wyolum/VeloKey/README.md

# VeloKey
Minimal Bluetooth Keyboard with rotary controller
=======

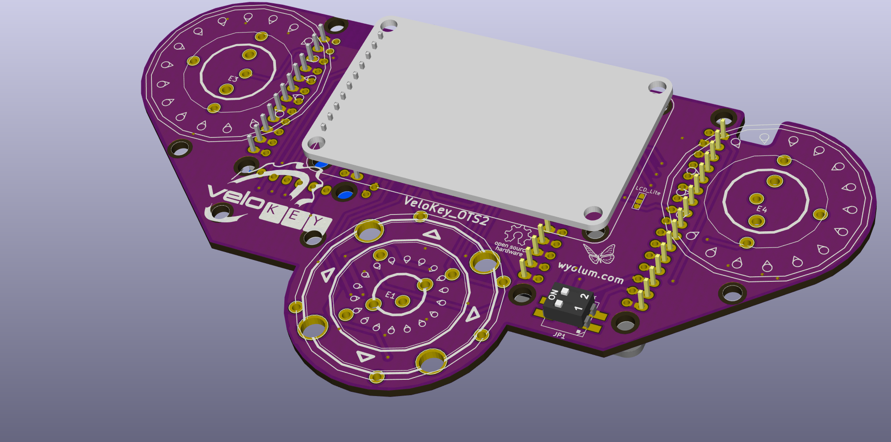
[picture p1: kicad/OTS_2/images/OTS2_01.png]
VeloKey top


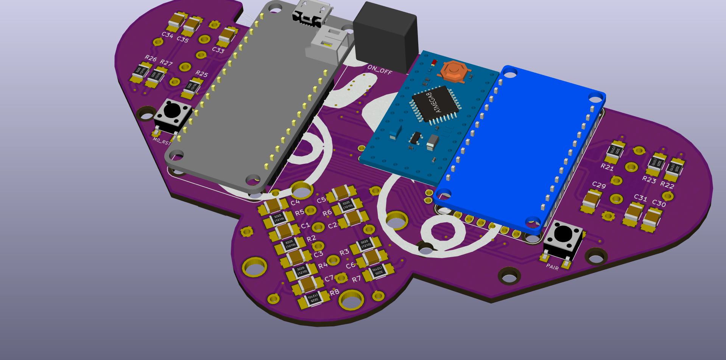
[picture p2: kicad/OTS_2/images/OTS2_02.png]
Velokey bottom


License
-------
[CERN Open Hardware Licence v1.2 ]

[CERN Open Hardware Licence v1.2 ]:http://www.ohwr.org/attachments/2388/cern_ohl_v_1_2.txt
