wyolum/VeloKey/kicad/data/Switch_GPTS203212BR2.pdf

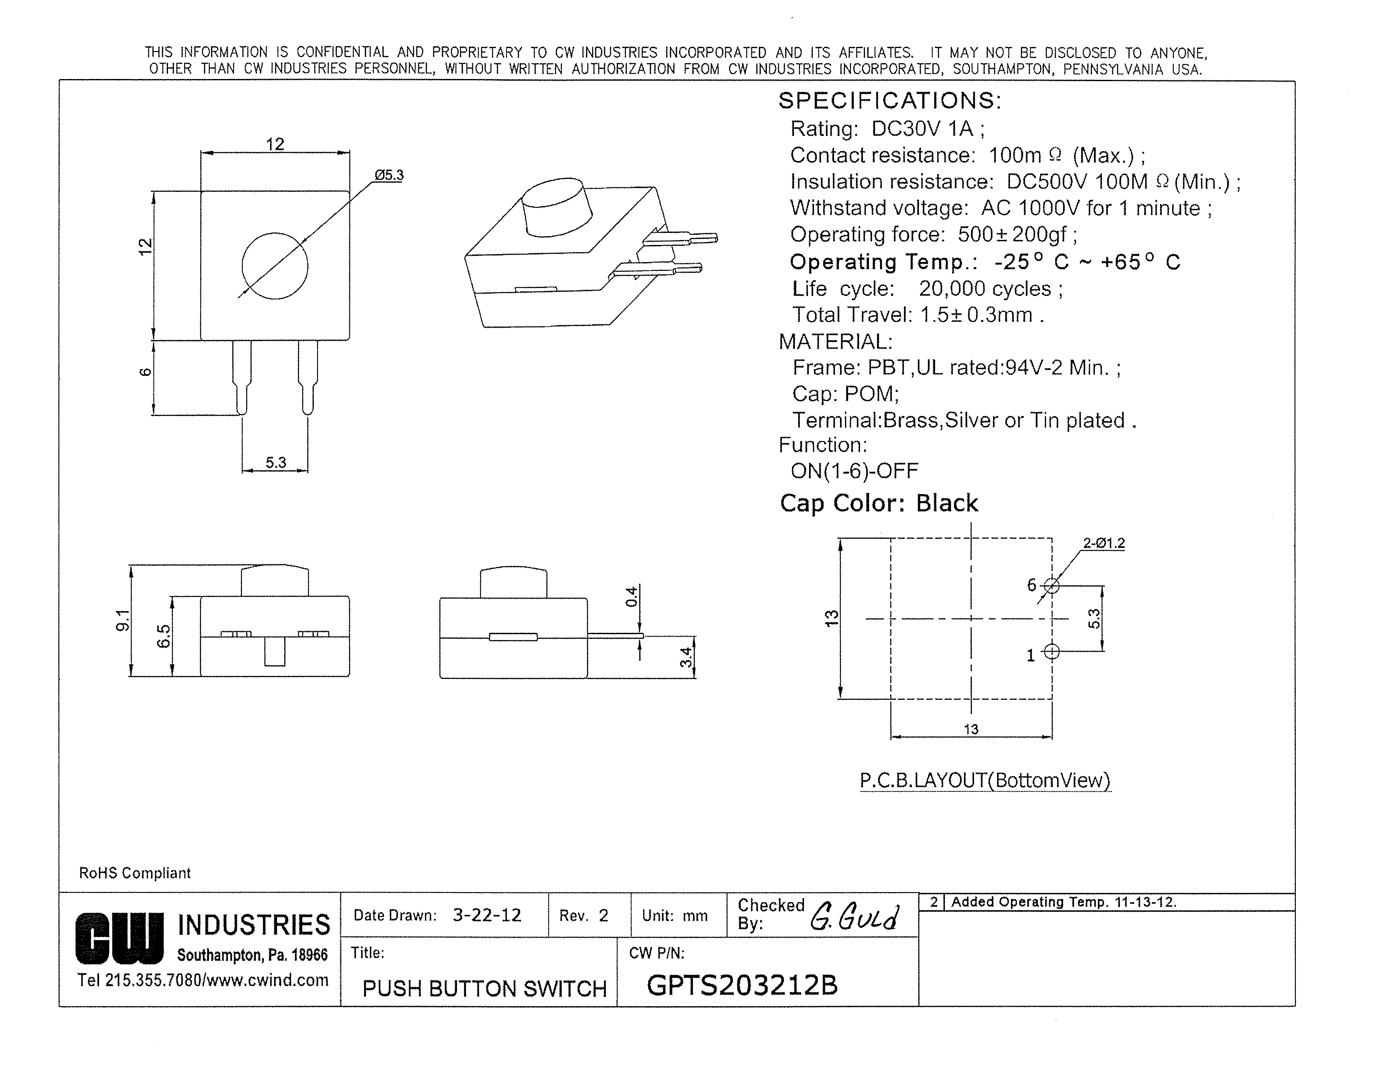
[picture p3: page 1]
