wyolum/VeloKey/kicad/data/ArduinoPRoMini.png

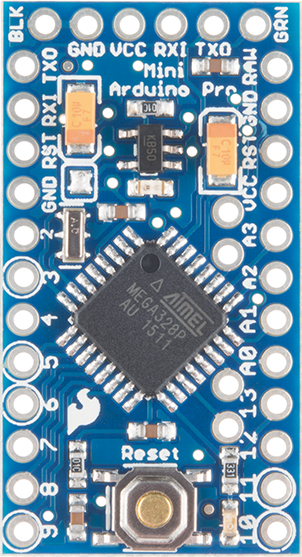
kicad/data/ArduinoPRoMini.png
