wyolum/VeloKey/kicad/data/ch04_promini_outline.png

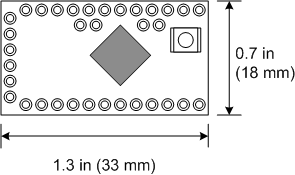
kicad/data/ch04_promini_outline.png
