wyolum/VeloKey/kicad/data/DisplayTFT.png

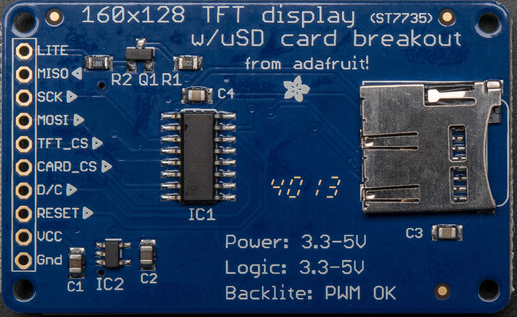
kicad/data/DisplayTFT.png
