wyolum/VeloKey/kicad/data/EZbluefruit.png

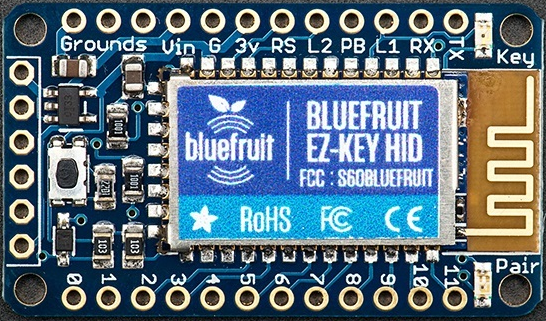
kicad/data/EZbluefruit.png
