wyolum/VeloKey/kicad/data/FeatherM0.png

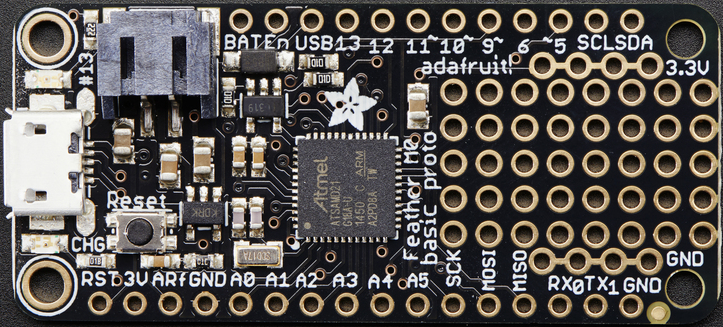
kicad/data/FeatherM0.png
