wyolum/VeloKey/kicad/data/OTS_Schematic.png

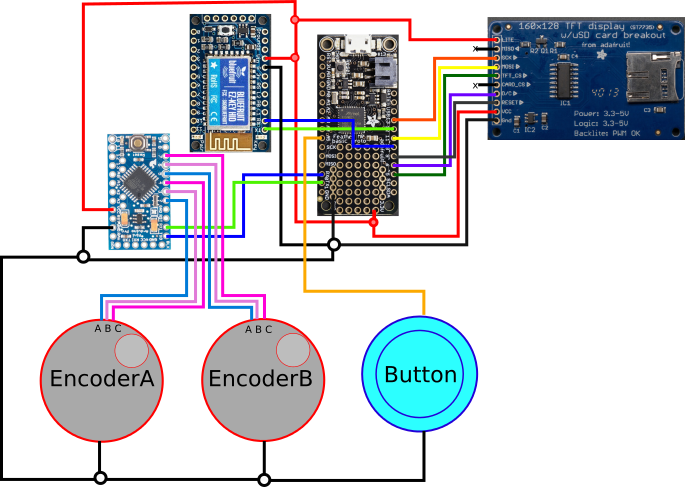
kicad/data/OTS_Schematic.png
