wyolum/VeloKey/kicad/data/velokey_sketch.jpg

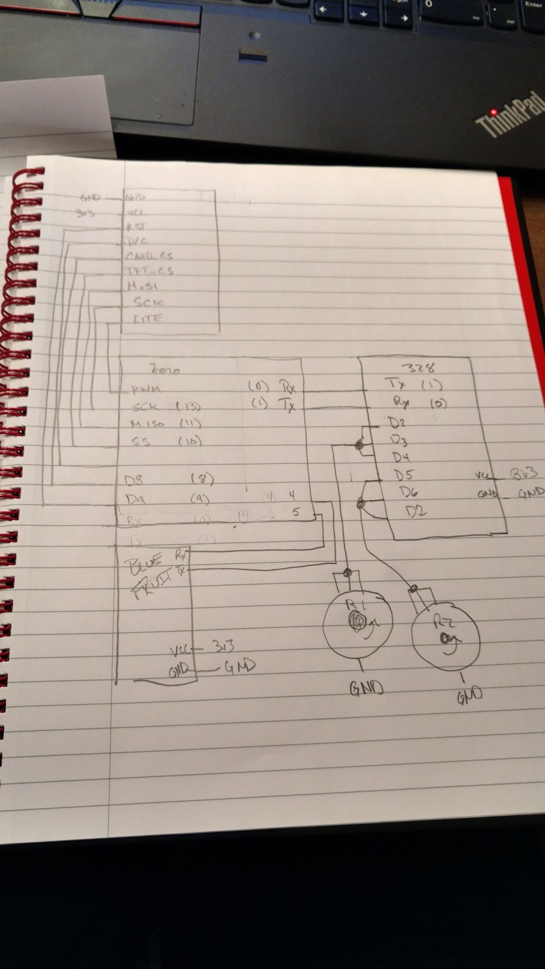
kicad/data/velokey_sketch.jpg
