wyolum/VeloKey/kicad/data/ZeroICSP.jpg

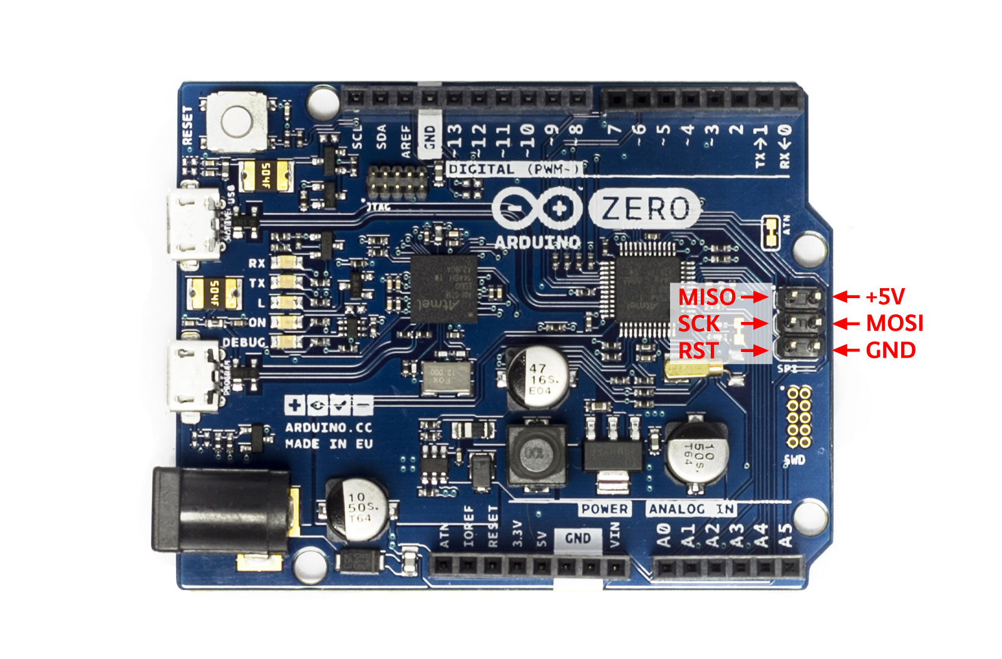
kicad/data/ZeroICSP.jpg
