wyolum/VeloKey/kicad/OTS_1/images/OTS01.png

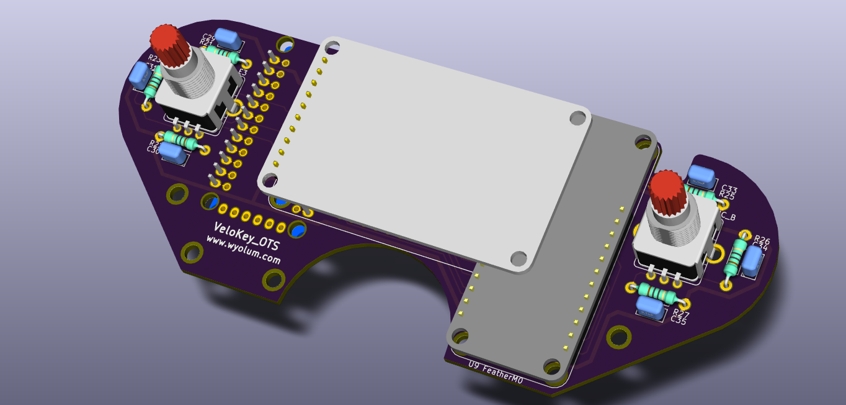
kicad/OTS_1/images/OTS01.png
