wyolum/VeloKey/kicad/OTS_1/images/OTS02.png

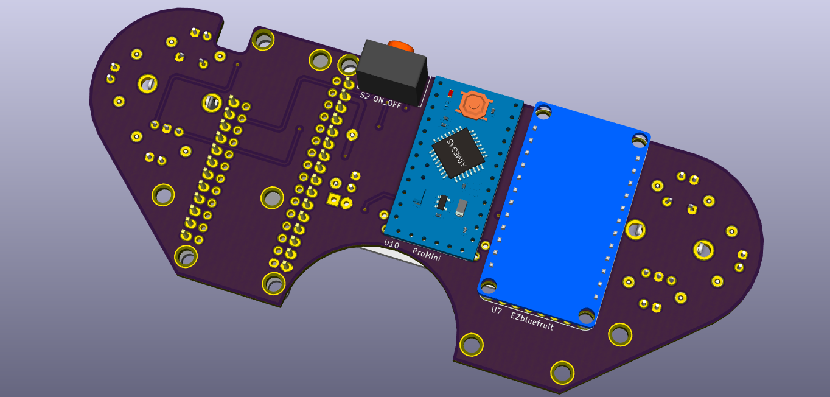
kicad/OTS_1/images/OTS02.png
