wyolum/VeloKey/kicad/OTS_1/images/OTS03.png

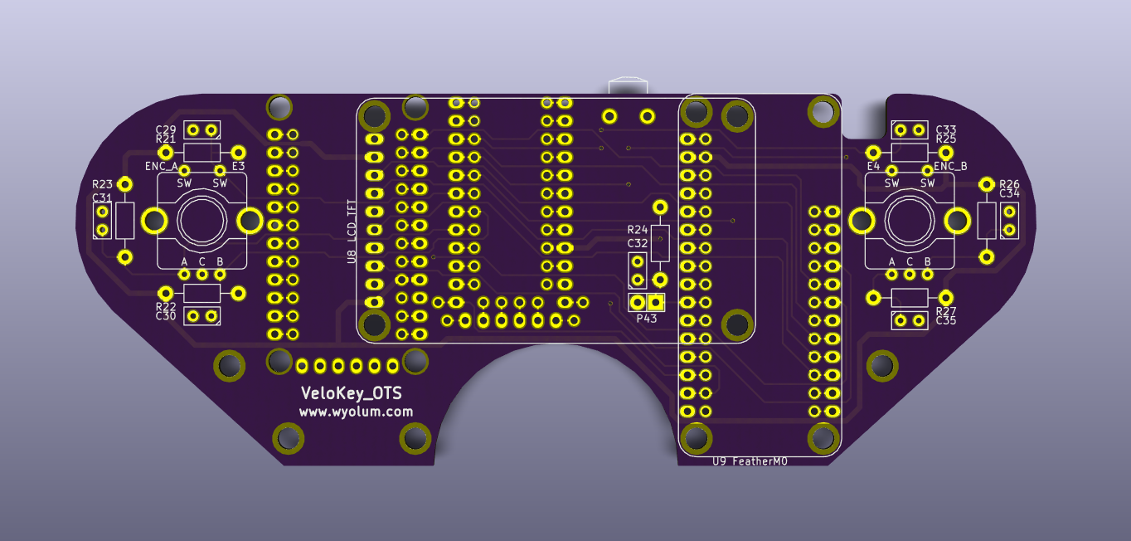
kicad/OTS_1/images/OTS03.png
