wyolum/VeloKey/kicad/OTS_1/images/OTS04.png

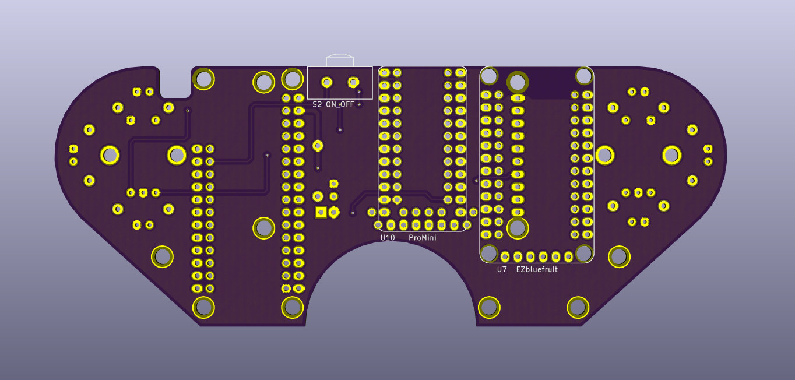
kicad/OTS_1/images/OTS04.png
