wyolum/VeloKey/kicad/OTS_1/images/OTS05.png

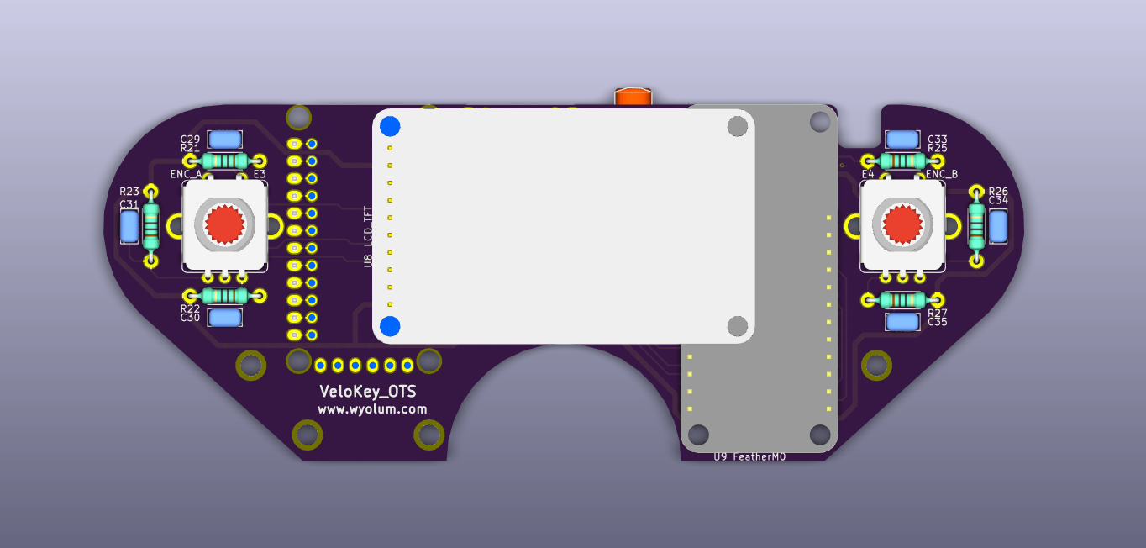
kicad/OTS_1/images/OTS05.png
