wyolum/VeloKey/kicad/OTS_1/images/OTS06.png

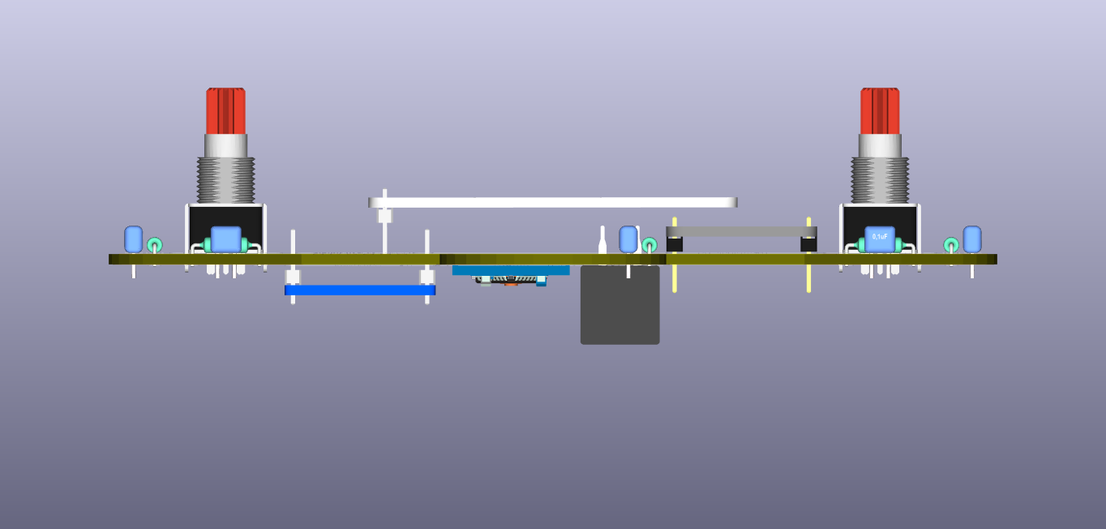
kicad/OTS_1/images/OTS06.png
