wyolum/VeloKey/kicad/OTS_2/images/OTS2_03.png

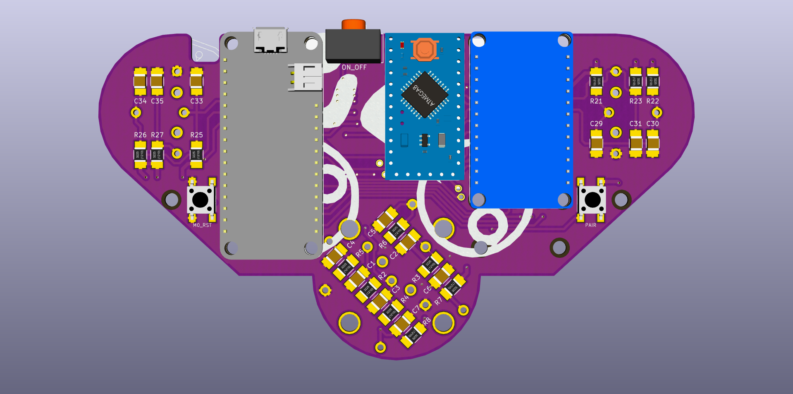
kicad/OTS_2/images/OTS2_03.png
