wyolum/VeloKey/kicad/OTS_2/images/OTS2_04.png

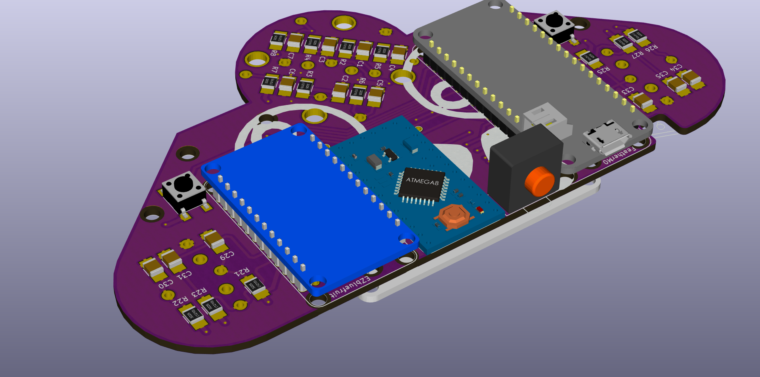
kicad/OTS_2/images/OTS2_04.png
