wyolum/VeloKey/kicad/OTS_2/images/OTS2_05.png

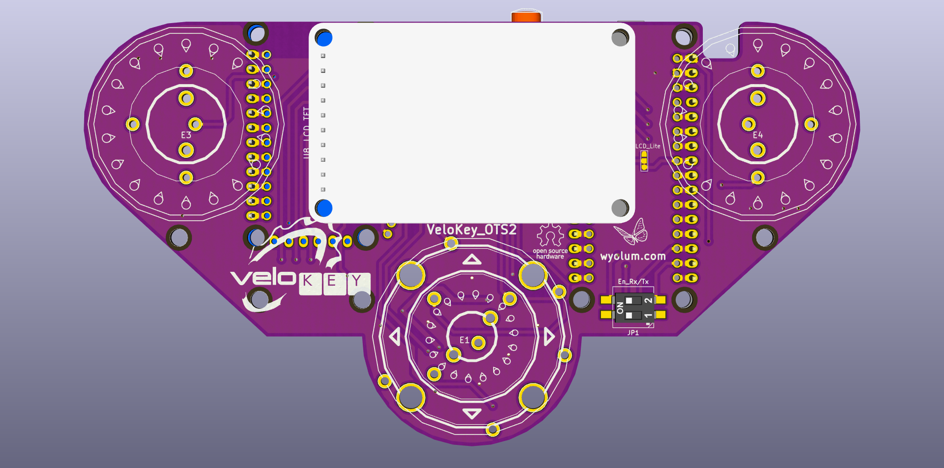
kicad/OTS_2/images/OTS2_05.png
