wyolum/VeloKey/kicad/OTS_2/OTS2_main.FCStd

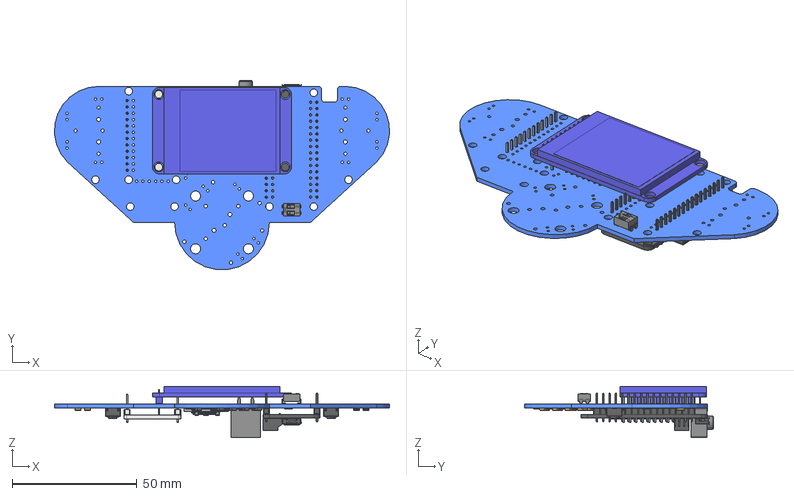
[picture p21: CAD file, 2016-10-24]
kicad/OTS_2/OTS2_main.FCStd
134.5 x 75.9 x 20.6 mm
Pcb
dip_sw_smd_
M0_
SW_smd_
Cap_smd_1210_
Cap_smd_1210_001
Cap_smd_1210_002
Cap_smd_1210_003
Cap_smd_1210_004
Cap_smd_1210_005
Cap_smd_1210_006
Cap_smd_1210_007
Cap_smd_1210_008
Cap_smd_1210_009
Cap_smd_1210_010
Cap_smd_1210_011
Cap_smd_1210_012
Res_smd_1210_
Res_smd_1210_001
Res_smd_1210_002
Res_smd_1210_003
Res_smd_1210_004
Res_smd_1210_005
Res_smd_1210_006
Res_smd_1210_007
Res_smd_1210_008
Res_smd_1210_009
Res_smd_1210_010
Res_smd_1210_011
Res_smd_1210_012
Res_smd_1210_013
SW_smd_001
