wyolum/VeloKey/fabricate/knob2.stl

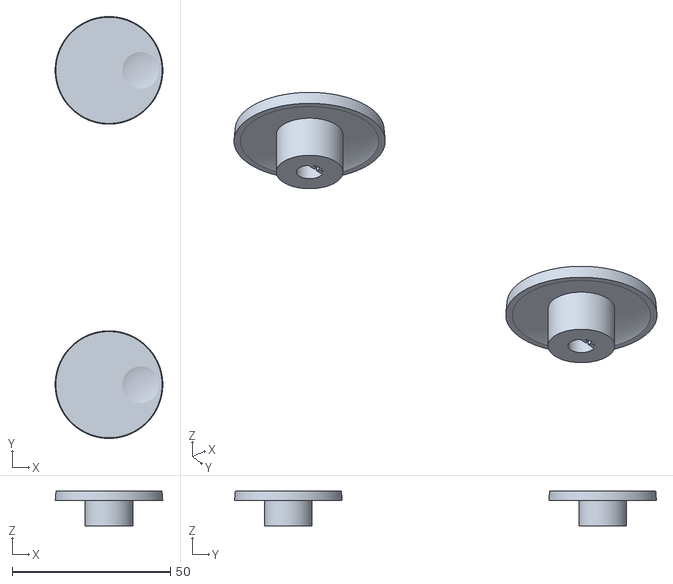
[picture p22: CAD file, 2016-03-05]
fabricate/knob2.stl
34.0 x 133.2 x 11.0
