wyolum/VeloKey/fabricate/OTS_1/case6_OTS_top.stl

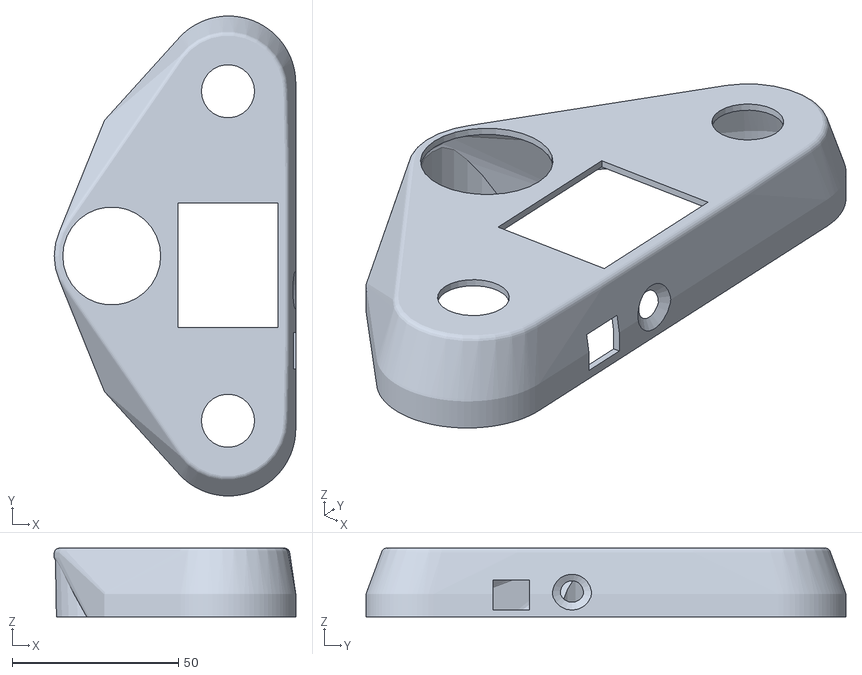
[picture p23: CAD file, 2016-03-07]
fabricate/OTS_1/case6_OTS_top.stl
72.7 x 144.5 x 20.7
