wyolum/VeloKey/fabricate/OTS_2/boards/OTS2_encC.FCStd

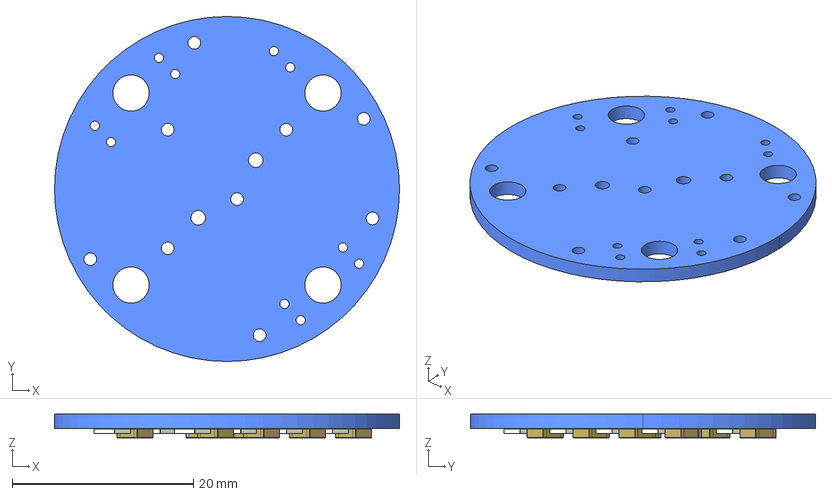
[picture p24: CAD file, 2016-09-07]
fabricate/OTS_2/boards/OTS2_encC.FCStd
38.1 x 38.1 x 2.60 mm
Pcb
Cap_smd_1210_
Cap_smd_1210_001
Res_smd_1210_
Res_smd_1210_001
Cap_smd_1210_002
Res_smd_1210_002
Cap_smd_1210_003
Res_smd_1210_003
Res_smd_1210_004
Res_smd_1210_005
Cap_smd_1210_004
Res_smd_1210_006
Cap_smd_1210_005
Cap_smd_1210_006
