wyolum/VeloKey/fabricate/OTS_2/OTS2_7_top.stl

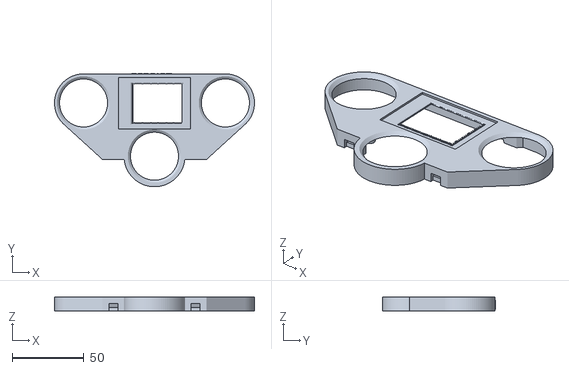
[picture p25: CAD file, 2018-01-31]
fabricate/OTS_2/OTS2_7_top.stl
139.7 x 79.2 x 9.63
