wyolum/VeloKey/fabricate/proto1/front.dxf

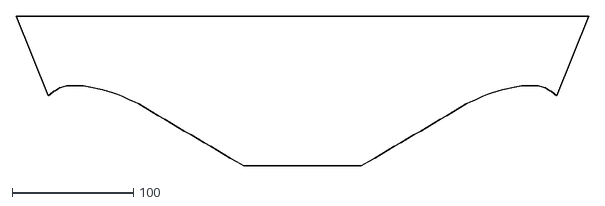
[picture p26: CAD file, 2016-02-07]
fabricate/proto1/front.dxf
473.0 x 123.5
