wyolum/VeloKey/kicad/OTS_1/3d_models/LCD_TFT2.step

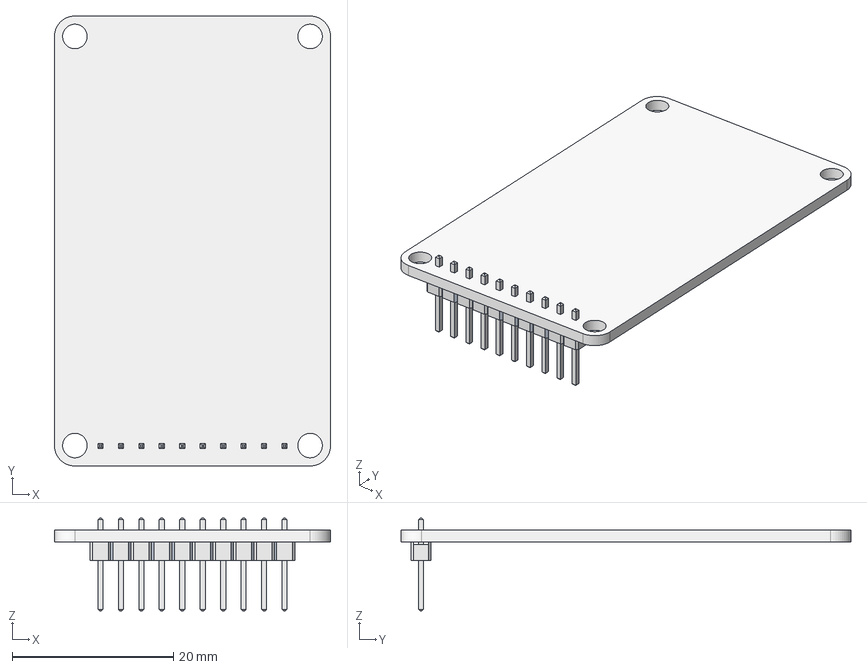
[picture p27: CAD file, 2016-02-05]
kicad/OTS_1/3d_models/LCD_TFT2.step
34.3 x 55.9 x 11.5 mm
