wyolum/VeloKey/kicad/OTS_2/3d_models/enc_a.step

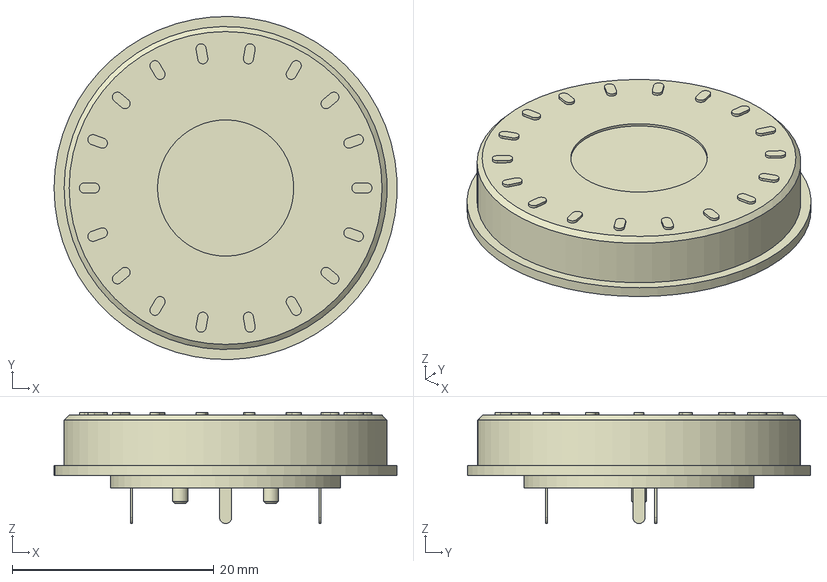
[picture p28: CAD file, 2016-09-07]
kicad/OTS_2/3d_models/enc_a.step
34.0 x 34.0 x 11.0 mm
