wyolum/VeloKey/fabricate/Garmin_Quarter_Turn_Plate.stl

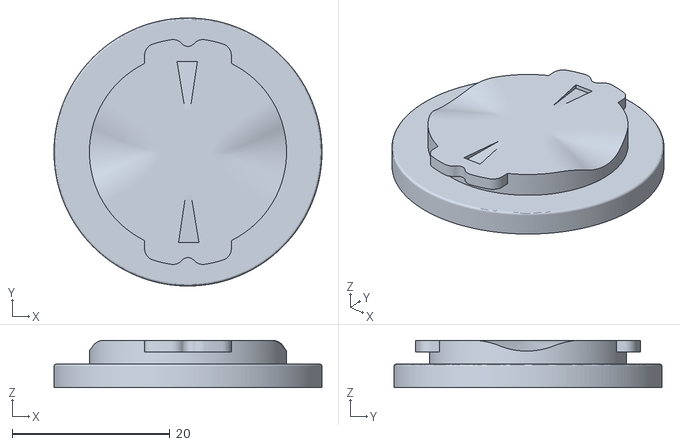
[picture p29: CAD file, 2016-03-05]
fabricate/Garmin_Quarter_Turn_Plate.stl
34.0 x 34.0 x 6.00
