wyolum/VeloKey/fabricate/OTS_1/case4_OTS_bottom.stl

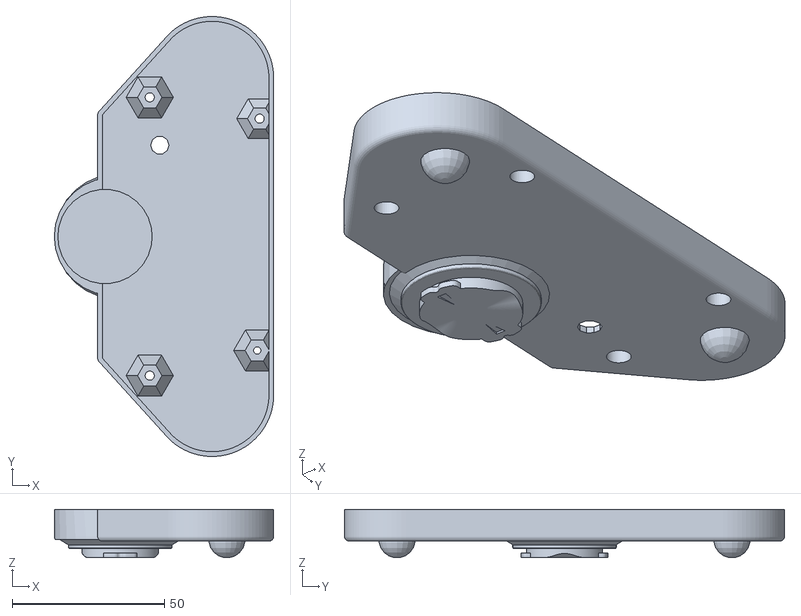
[picture p30: CAD file, 2016-03-05]
fabricate/OTS_1/case4_OTS_bottom.stl
72.1 x 144.5 x 15.8
