wyolum/VeloKey/fabricate/OTS_2/boards/OTS2_encB.FCStd

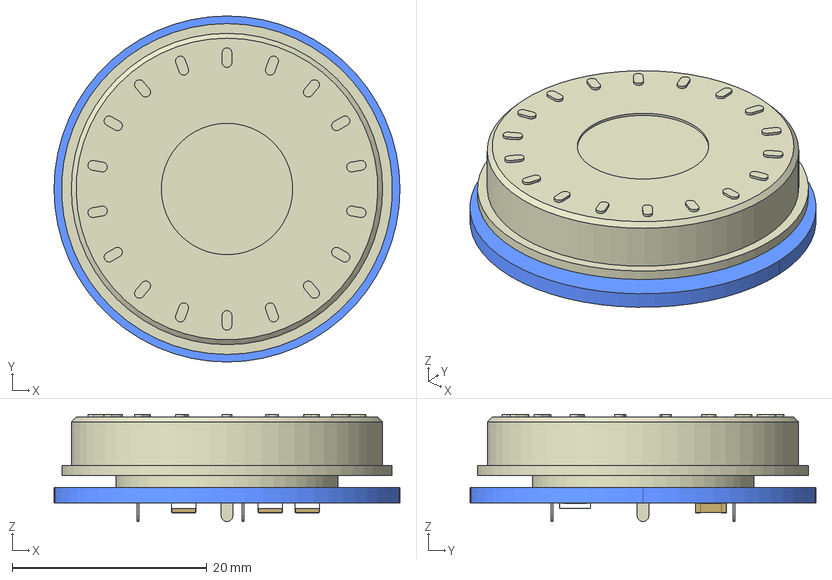
[picture p31: CAD file, 2016-09-07]
fabricate/OTS_2/boards/OTS2_encB.FCStd
35.6 x 35.6 x 11.0 mm
Pcb
Res_smd_1210_
Res_smd_1210_001
Cap_smd_1210_
Res_smd_1210_002
Cap_smd_1210_001
Cap_smd_1210_002
PolarPattern_
