wyolum/VeloKey/fabricate/OTS_2/OTS2_7_top_NoSupport.stl

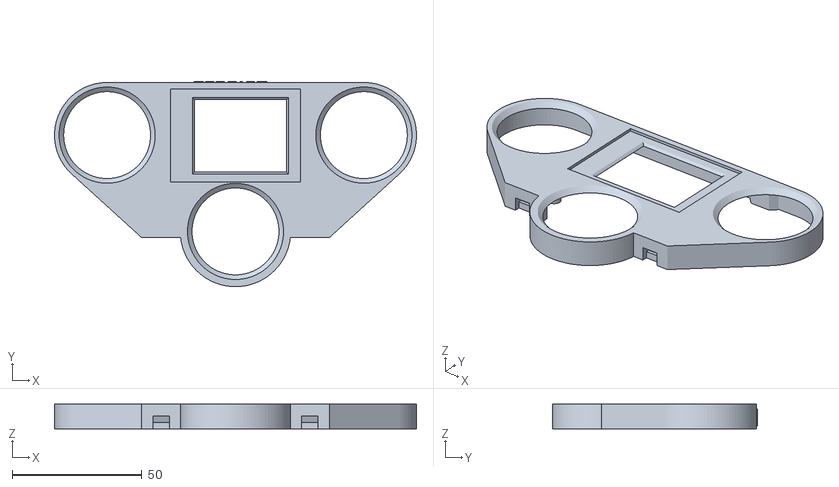
[picture p32: CAD file, 2016-12-15]
fabricate/OTS_2/OTS2_7_top_NoSupport.stl
139.7 x 79.2 x 9.63
