wyolum/VeloKey/fabricate/proto1/side.dxf

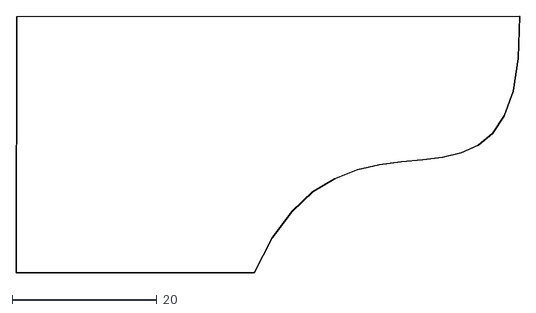
[picture p33: CAD file, 2016-02-01]
fabricate/proto1/side.dxf
69.7 x 35.5
