wyolum/VeloKey/kicad/OTS_1/3d_models/Header_Male_02Pin.step

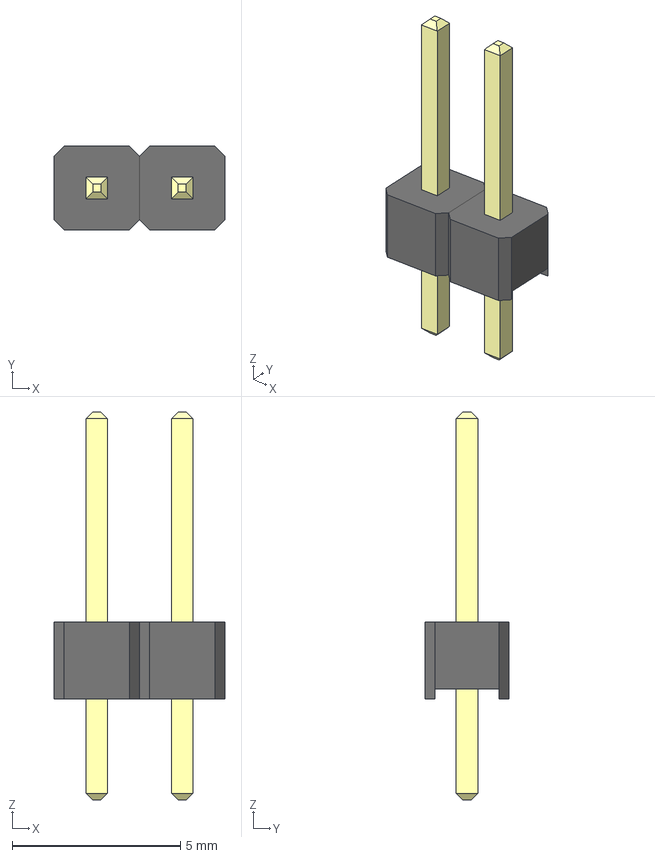
[picture p34: CAD file, 2016-02-05]
kicad/OTS_1/3d_models/Header_Male_02Pin.step
5.08 x 2.49 x 11.5 mm
