wyolum/VeloKey/kicad/OTS_2/3d_models/LCD_TFT.step

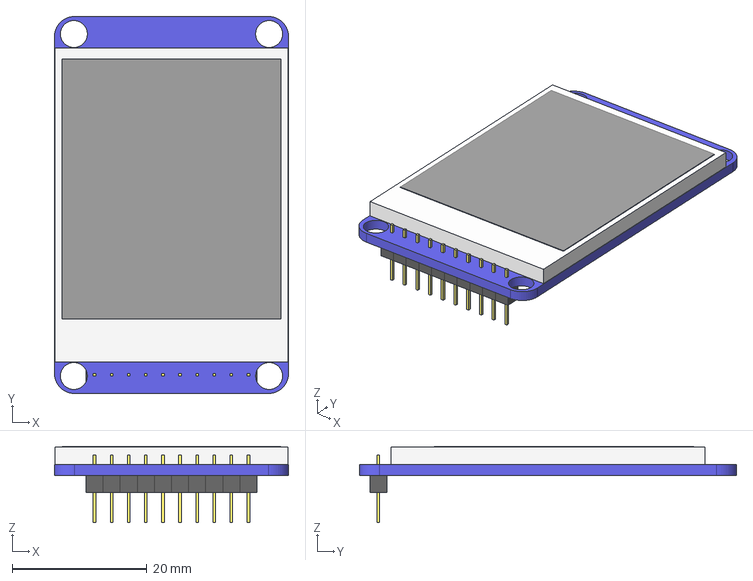
[picture p35: CAD file, 2016-07-04]
kicad/OTS_2/3d_models/LCD_TFT.step
34.8 x 56.0 x 11.3 mm
