wyolum/VeloKey/fabricate/knobs.stl

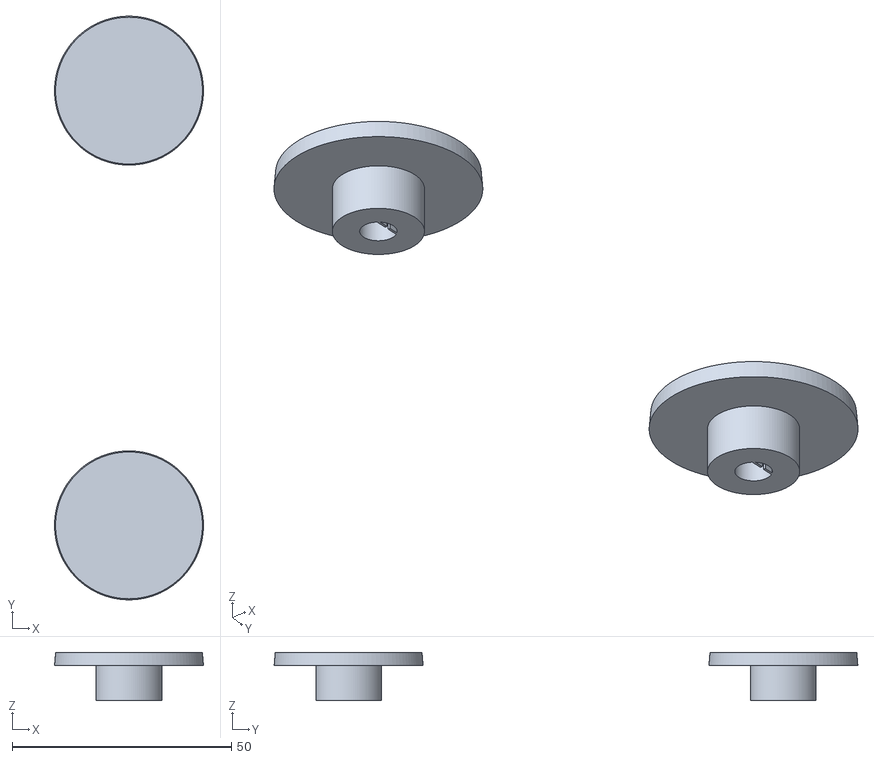
[picture p36: CAD file, 2016-03-05]
fabricate/knobs.stl
34.0 x 133.2 x 11.0
