wyolum/VeloKey/fabricate/OTS_1/case5_OTS.stl

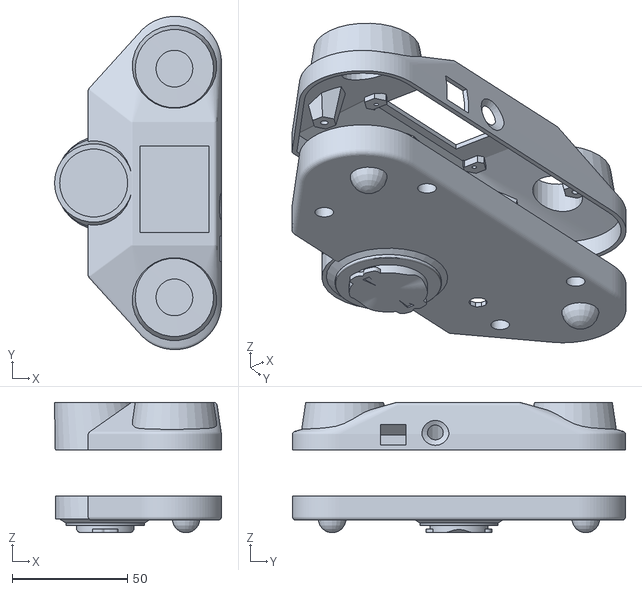
[picture p37: CAD file, 2016-03-05]
fabricate/OTS_1/case5_OTS.stl
72.4 x 144.5 x 56.5
