wyolum/VeloKey/fabricate/OTS_2/OTS2_7_bot.stl

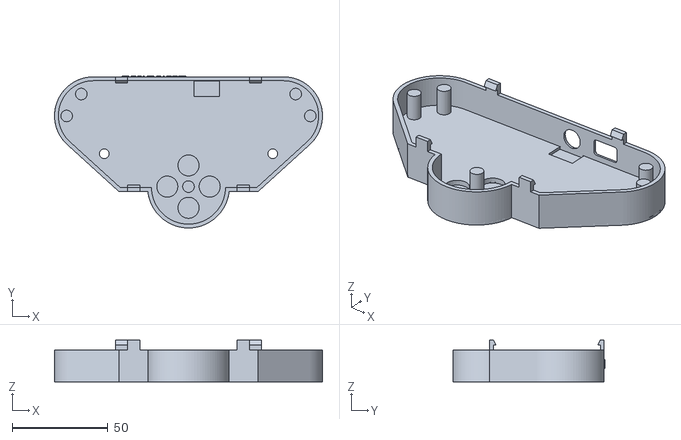
[picture p38: CAD file, 2016-12-15]
fabricate/OTS_2/OTS2_7_bot.stl
139.7 x 79.2 x 21.8
