wyolum/VeloKey/fabricate/proto1/top.dxf

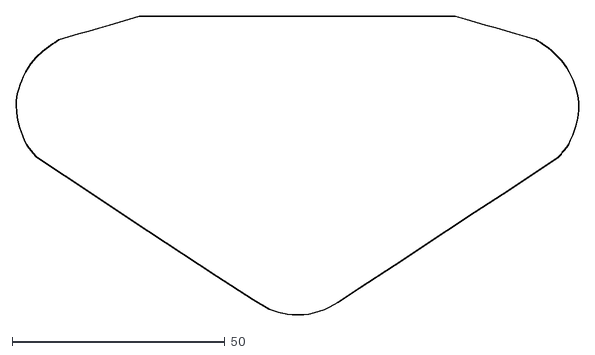
[picture p39: CAD file, 2016-01-26]
fabricate/proto1/top.dxf
132.1 x 70.2
