wyolum/VeloKey/kicad/OTS_1/3d_models/LCD_TFT.stl

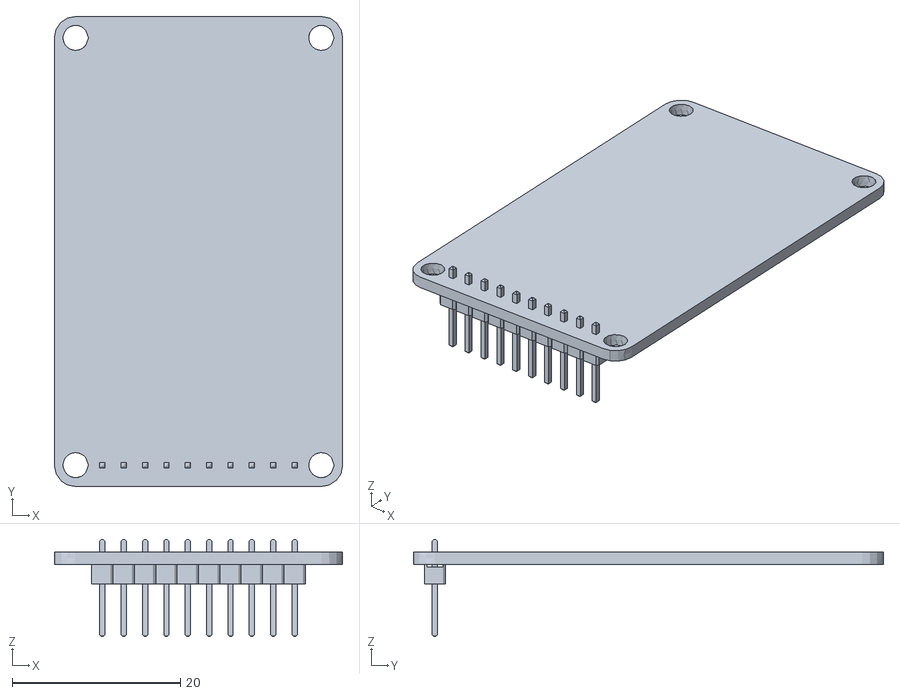
[picture p40: CAD file, 2016-02-04]
kicad/OTS_1/3d_models/LCD_TFT.stl
34.3 x 55.9 x 11.5
