wyolum/VeloKey/kicad/OTS_2/3d_models/dip_switch_smd_x2_3.step

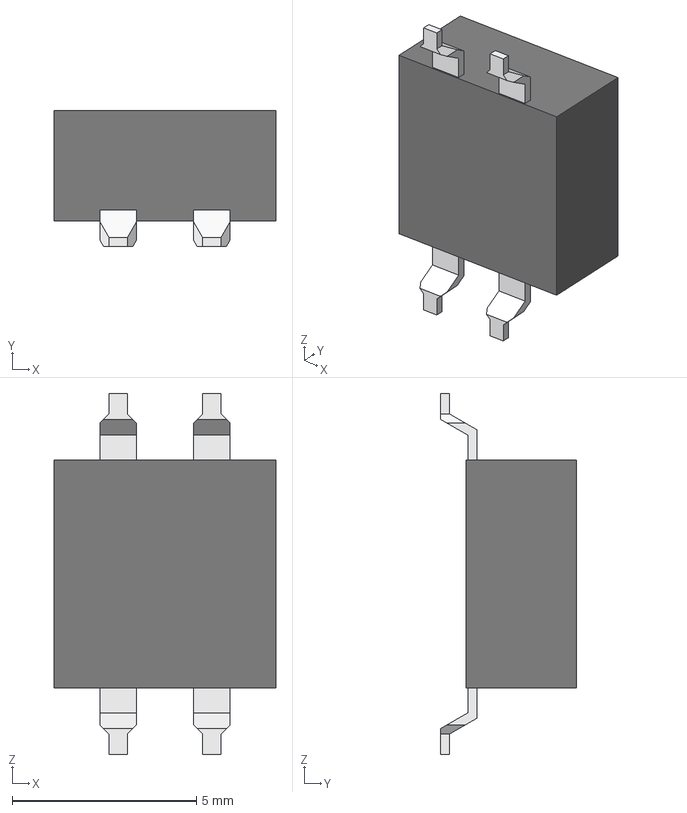
[picture p41: CAD file, 2016-04-25]
kicad/OTS_2/3d_models/dip_switch_smd_x2_3.step
6.02 x 3.70 x 9.80 mm
