wyolum/VeloKey/fabricate/knob.stl

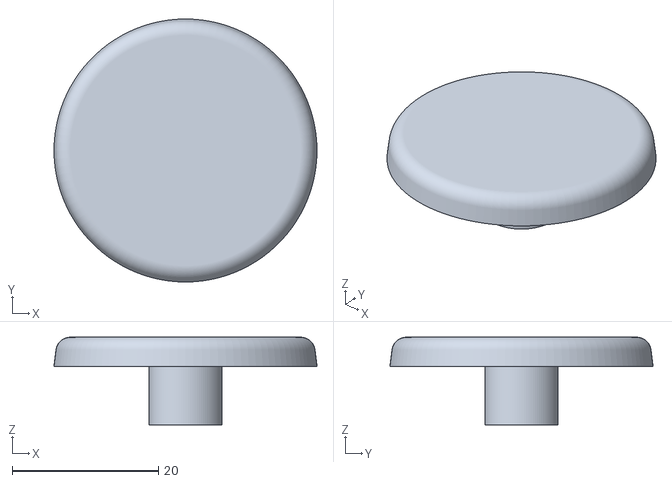
[picture p42: CAD file, 2016-03-05]
fabricate/knob.stl
36.0 x 36.0 x 12.0
