wyolum/VeloKey/fabricate/OTS_1/case4_OTS_top.stl

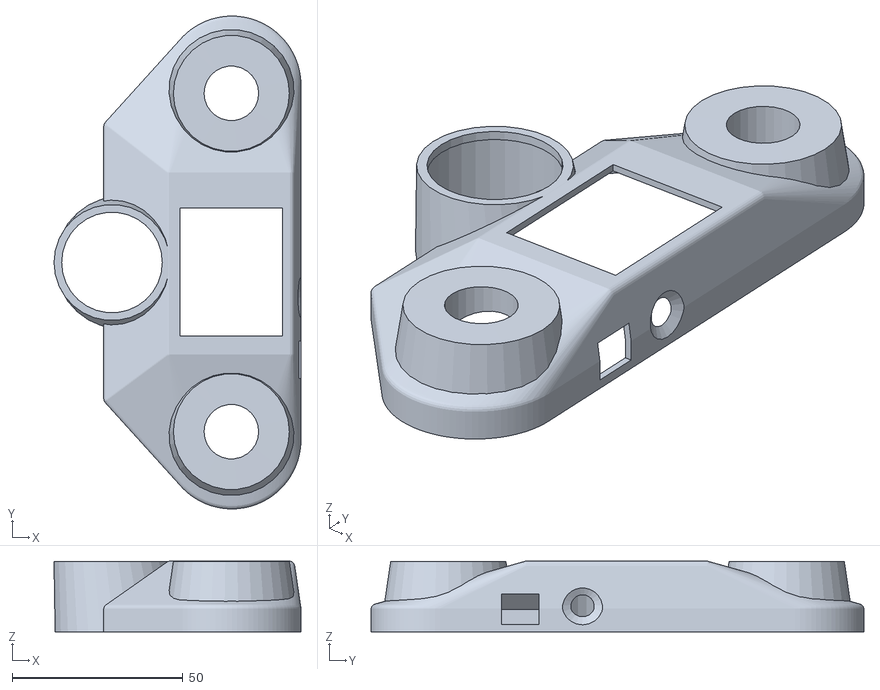
[picture p43: CAD file, 2016-03-05]
fabricate/OTS_1/case4_OTS_top.stl
72.4 x 144.5 x 20.7
