wyolum/VeloKey/kicad/OTS_1/3d_models/FeatherM0.step

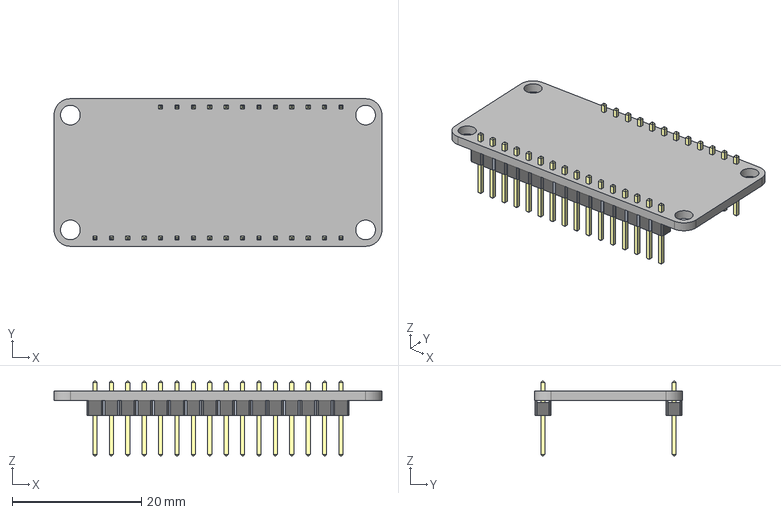
[picture p44: CAD file, 2016-02-04]
kicad/OTS_1/3d_models/FeatherM0.step
50.8 x 22.9 x 11.5 mm
