wyolum/VeloKey/kicad/OTS_2/3d_models/dip_switch_smd_x2.step

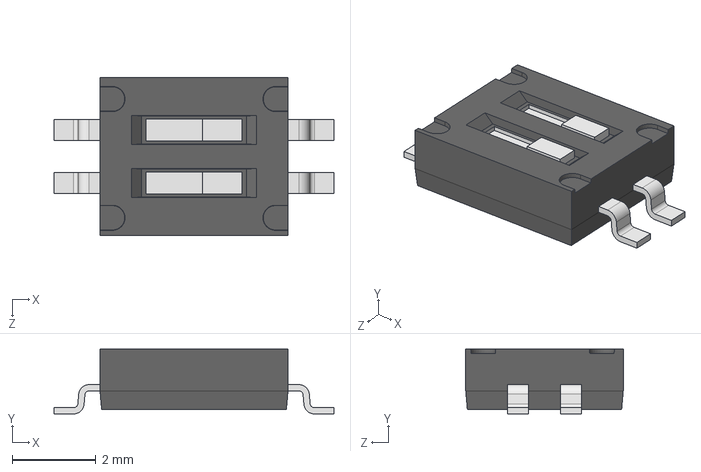
[picture p45: CAD file, 2016-04-25]
kicad/OTS_2/3d_models/dip_switch_smd_x2.step
6.70 x 1.55 x 3.77 mm
