wyolum/VeloKey/fabricate/OTS_1/board_OTS.stl

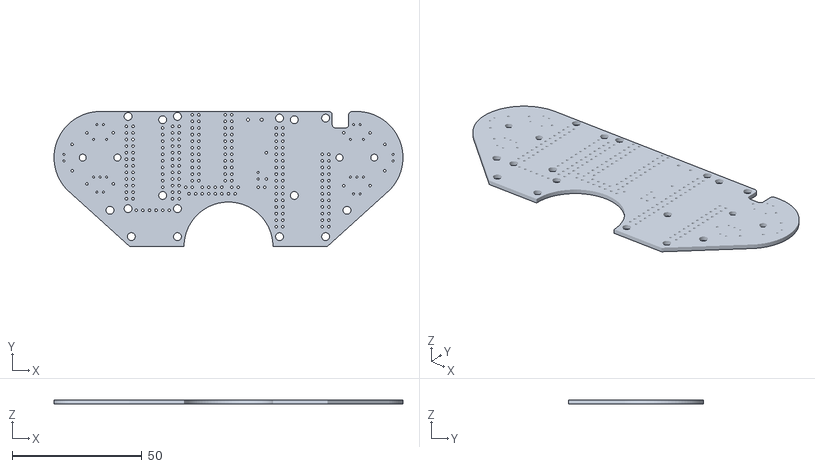
[picture p46: CAD file, 2016-03-05]
fabricate/OTS_1/board_OTS.stl
134.6 x 52.1 x 1.60
