wyolum/VeloKey/fabricate/power.stl

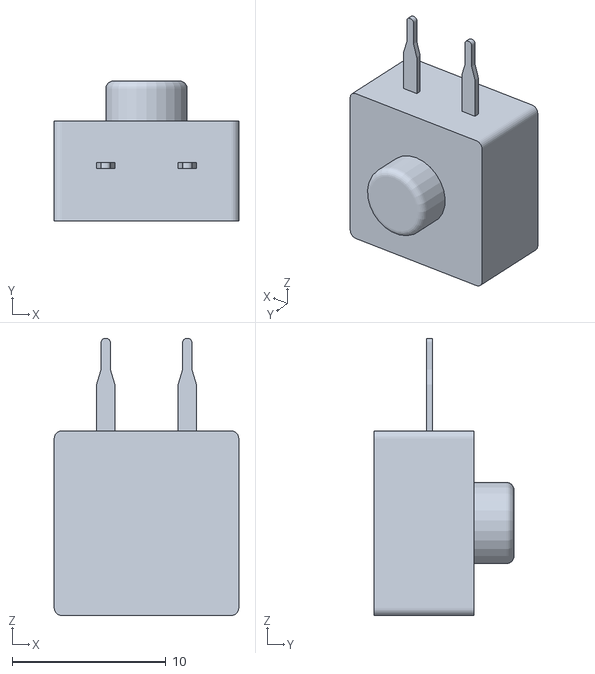
[picture p47: CAD file, 2016-03-05]
fabricate/power.stl
12.0 x 9.10 x 18.0
