wyolum/VeloKey/kicad/OTS_2/3d_models/dip_sw_smd.step

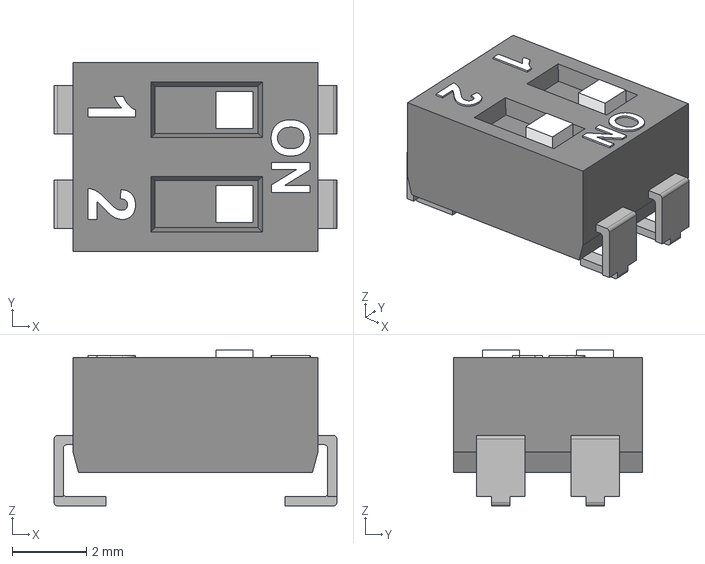
[picture p48: CAD file, 2016-04-25]
kicad/OTS_2/3d_models/dip_sw_smd.step
7.62 x 5.08 x 4.20 mm
