wyolum/VeloKey/fabricate/extender.stl

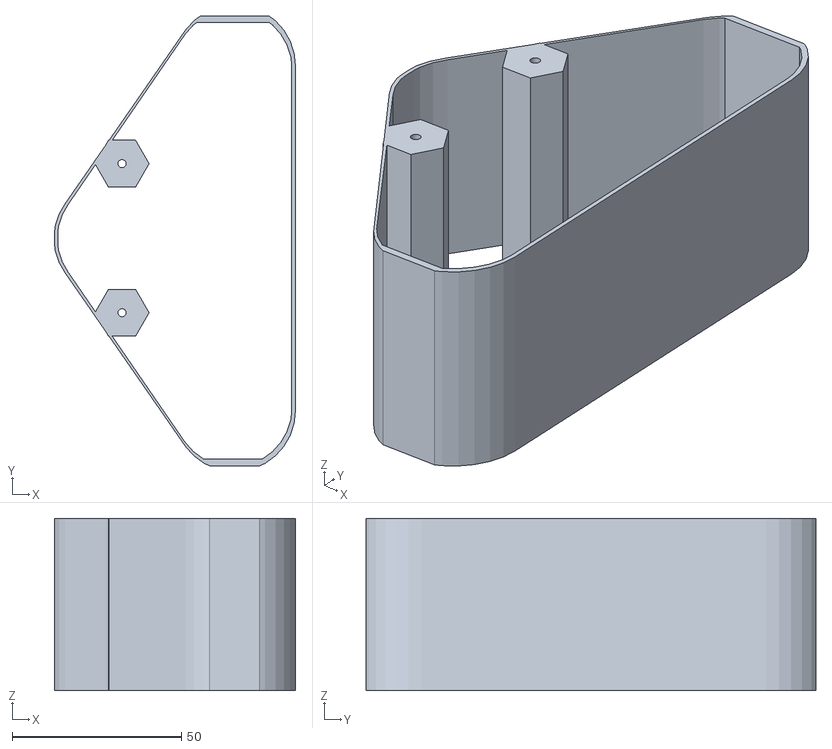
[picture p49: CAD file, 2016-03-05]
fabricate/extender.stl
71.1 x 132.7 x 50.8
