wyolum/VeloKey/fabricate/OTS_1/case3_OTS_bottom.stl

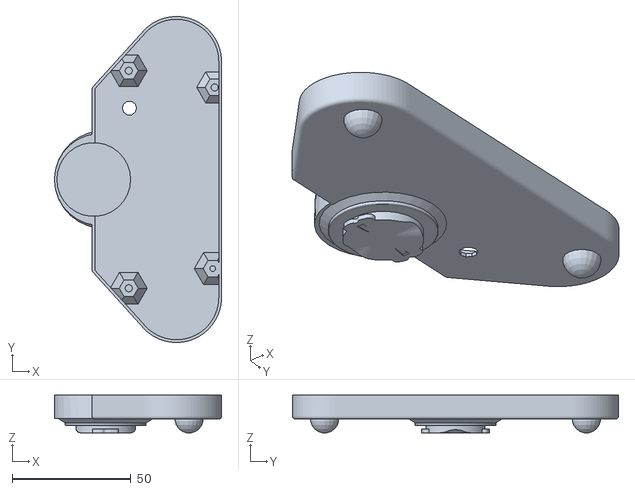
[picture p50: CAD file, 2016-03-05]
fabricate/OTS_1/case3_OTS_bottom.stl
70.3 x 137.0 x 15.8
