wyolum/VeloKey/fabricate/OTS_2/OTS2_5_garmin_base.stl

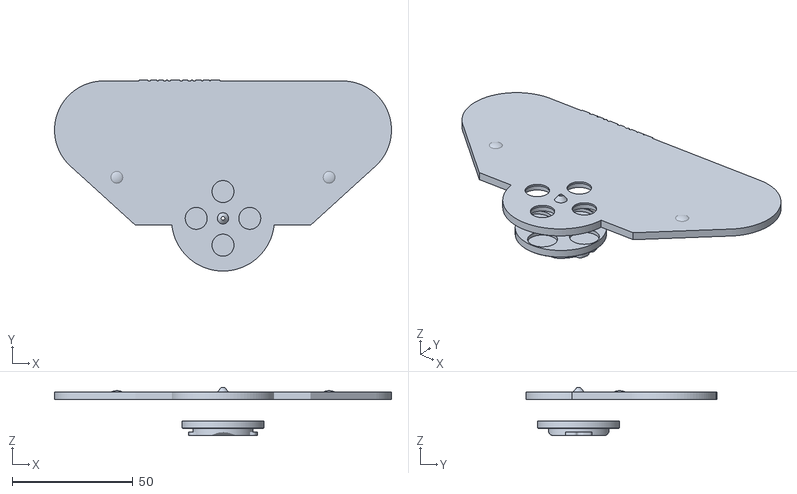
[picture p51: CAD file, 2016-10-24]
fabricate/OTS_2/OTS2_5_garmin_base.stl
139.7 x 79.2 x 19.9
