wyolum/VeloKey/fabricate/display.stl

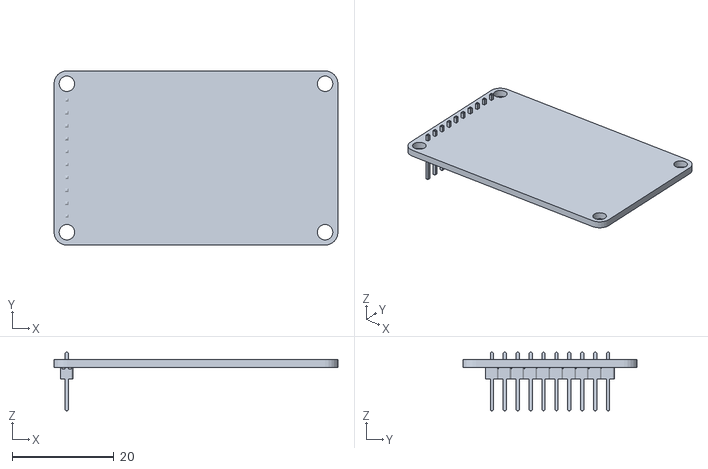
[picture p52: CAD file, 2016-03-05]
fabricate/display.stl
55.9 x 34.3 x 11.5
