wyolum/VeloKey/fabricate/OTS_2/OTS2_4_bot.stl

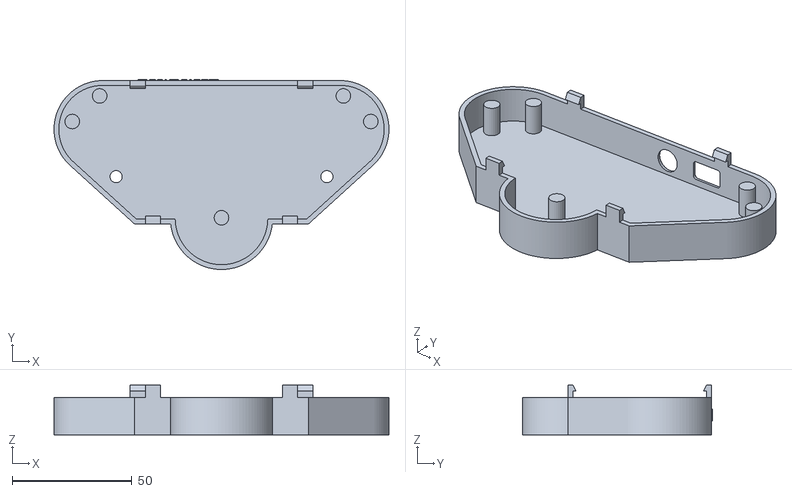
[picture p53: CAD file, 2016-10-10]
fabricate/OTS_2/OTS2_4_bot.stl
139.7 x 79.2 x 20.8
