wyolum/VeloKey/kicad/OTS_1/3d_models/Header_Male_12Pin.step

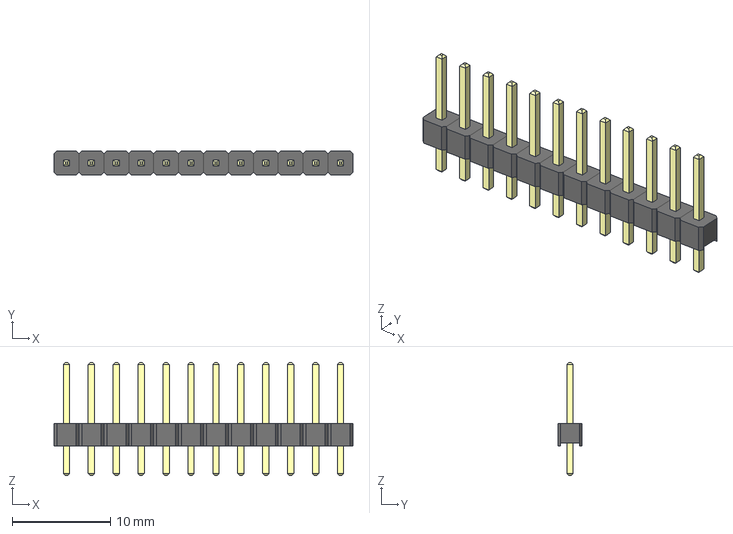
[picture p54: CAD file, 2016-02-04]
kicad/OTS_1/3d_models/Header_Male_12Pin.step
30.5 x 2.49 x 11.5 mm
