wyolum/VeloKey/kicad/OTS_2/3d_models/LiPo.step

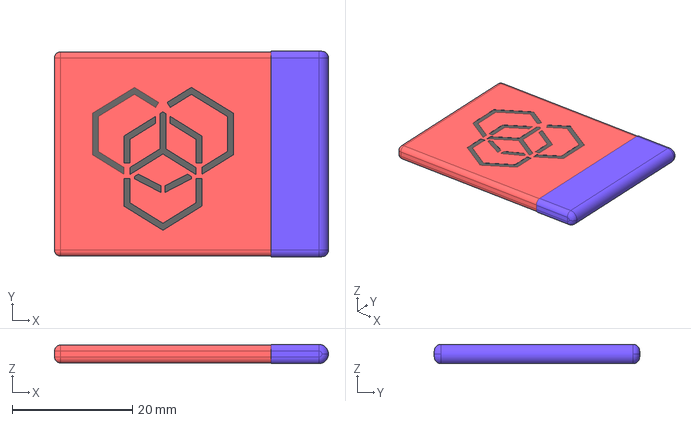
[picture p55: CAD file, 2016-03-31]
kicad/OTS_2/3d_models/LiPo.step
45.6 x 34.2 x 3.20 mm
