wyolum/VeloKey/kicad/OTS_1/3d_models/Capacitor_100nF_2-54mm.step

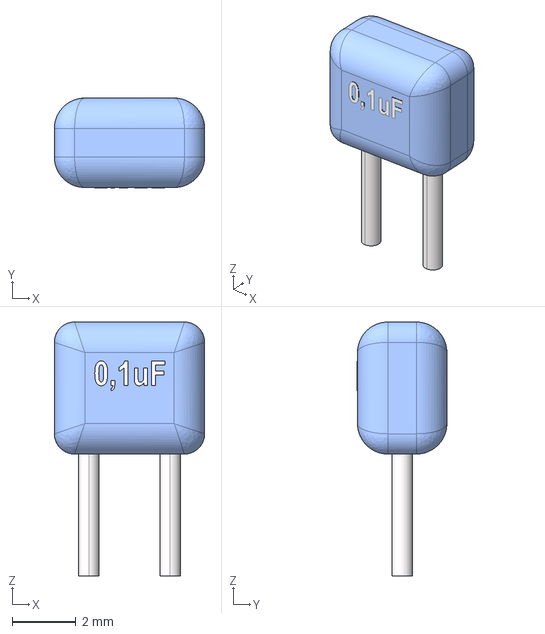
[picture p56: CAD file, 2016-02-04]
kicad/OTS_1/3d_models/Capacitor_100nF_2-54mm.step
4.70 x 2.81 x 7.94 mm
