wyolum/VeloKey/kicad/OTS_2/3d_models/SW_smd.step

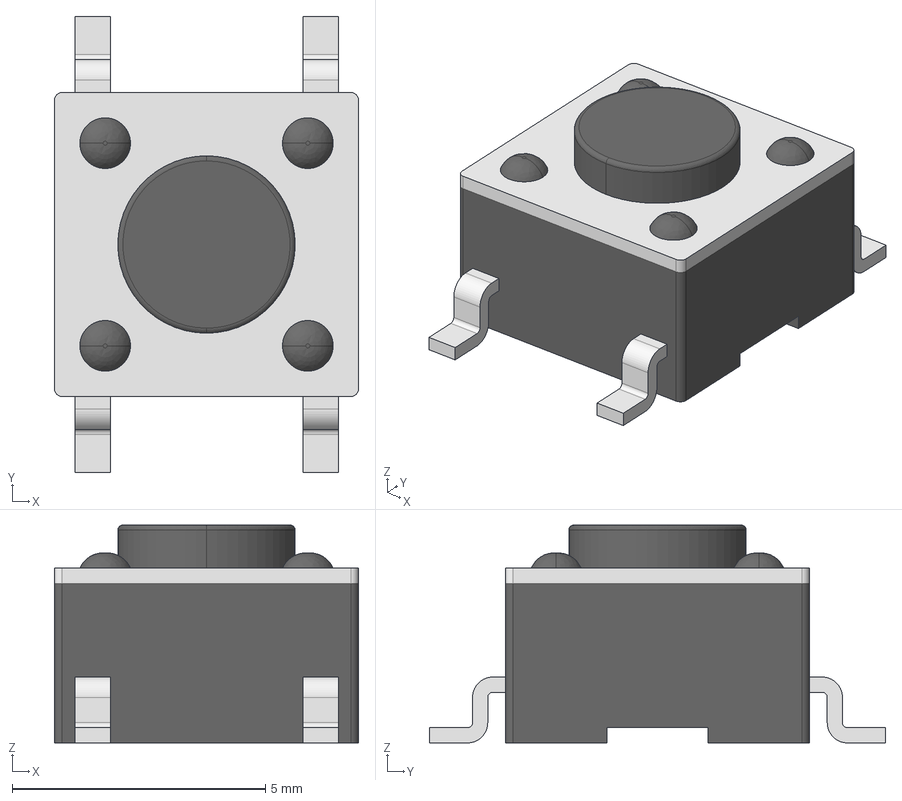
[picture p57: CAD file, 2016-03-31]
kicad/OTS_2/3d_models/SW_smd.step
6.00 x 9.00 x 4.30 mm
