wyolum/VeloKey/fabricate/OTS_1/case3_OTS.stl

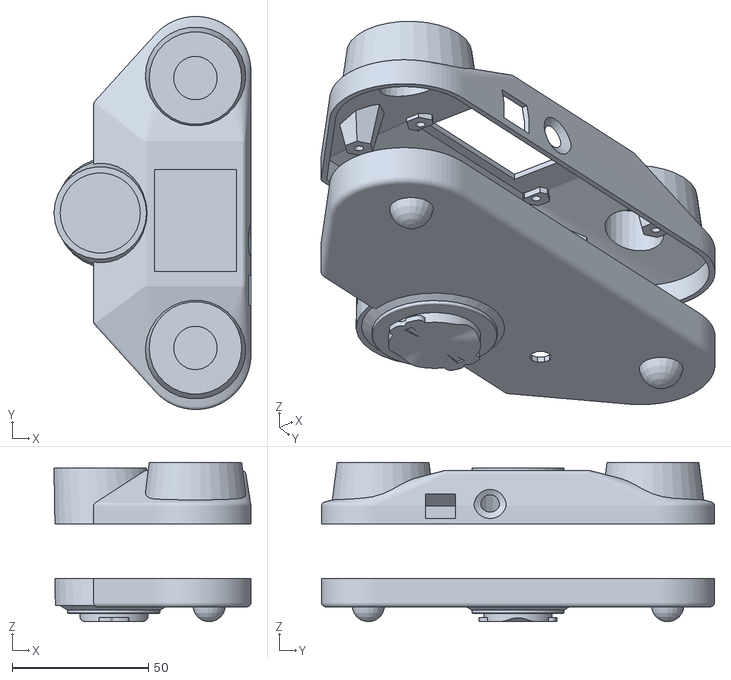
[picture p58: CAD file, 2016-03-05]
fabricate/OTS_1/case3_OTS.stl
72.4 x 144.5 x 58.5
