wyolum/VeloKey/fabricate/OTS_2/OTS2_4.FCStd

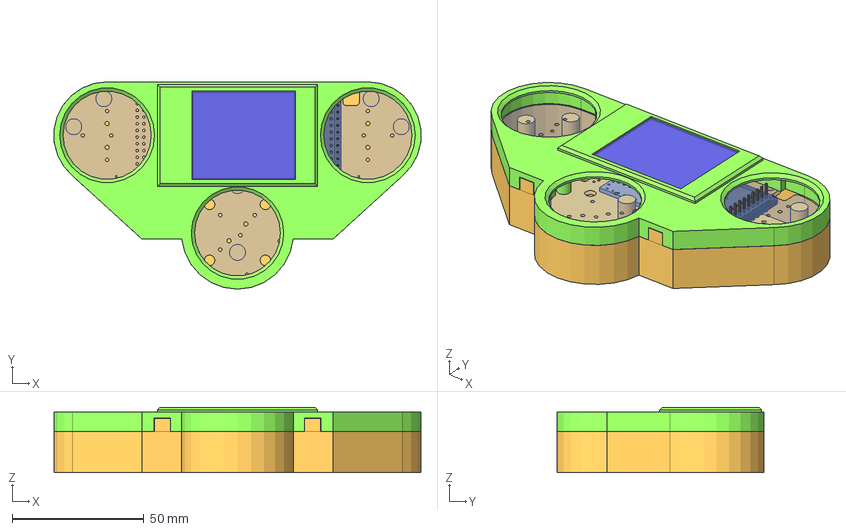
[picture p59: CAD file, 2016-08-29]
fabricate/OTS_2/OTS2_4.FCStd
139.4 x 78.8 x 24.9 mm
Pcb
dip_sw_smd_
LCD
M0_
SW_smd_
ProMini
Power
SW_smd_001
bottom_Pad013
top_final_Chamfer001
