wyolum/VeloKey/kicad/OTS_1/3d_models/header_1x2_TH_2_54mm.step

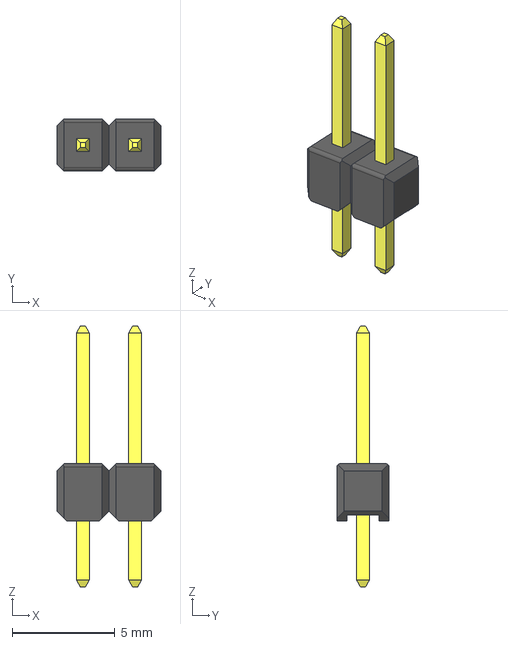
[picture p60: CAD file, 2016-02-04]
kicad/OTS_1/3d_models/header_1x2_TH_2_54mm.step
5.08 x 2.54 x 12.7 mm
