wyolum/VeloKey/kicad/OTS_2/3d_models/JST_SxB-PH-K-S-RA.step

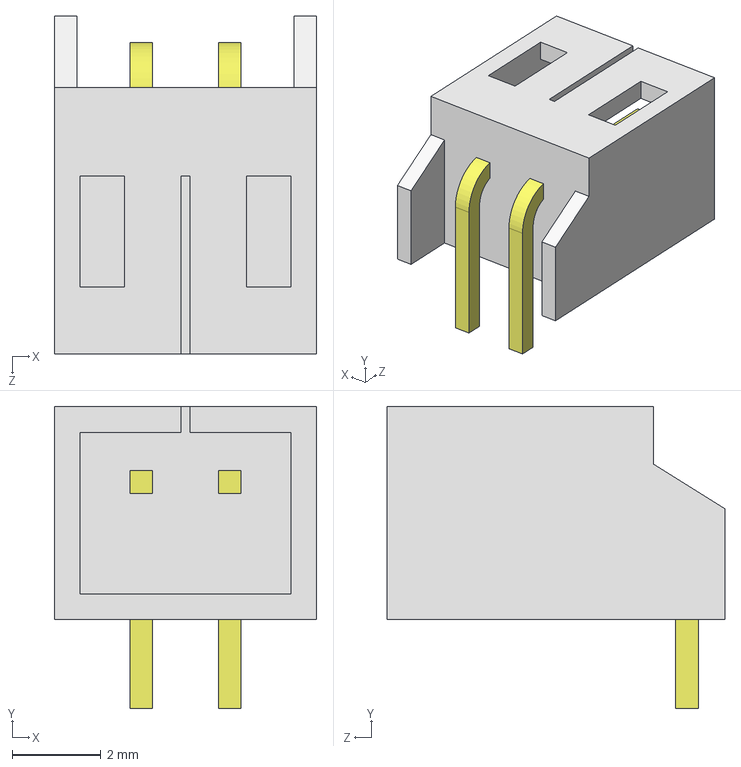
[picture p61: CAD file, 2016-03-31]
kicad/OTS_2/3d_models/JST_SxB-PH-K-S-RA.step
5.90 x 6.80 x 7.60 mm
