wyolum/VeloKey/fabricate/OTS_1/case1_top.stl

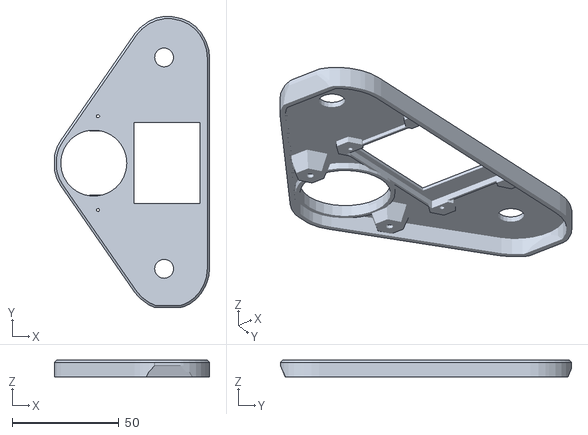
[picture p62: CAD file, 2016-03-05]
fabricate/OTS_1/case1_top.stl
72.8 x 136.6 x 7.88
