wyolum/VeloKey/kicad/OTS_1/3d_models/Header_Male_03Pin.step

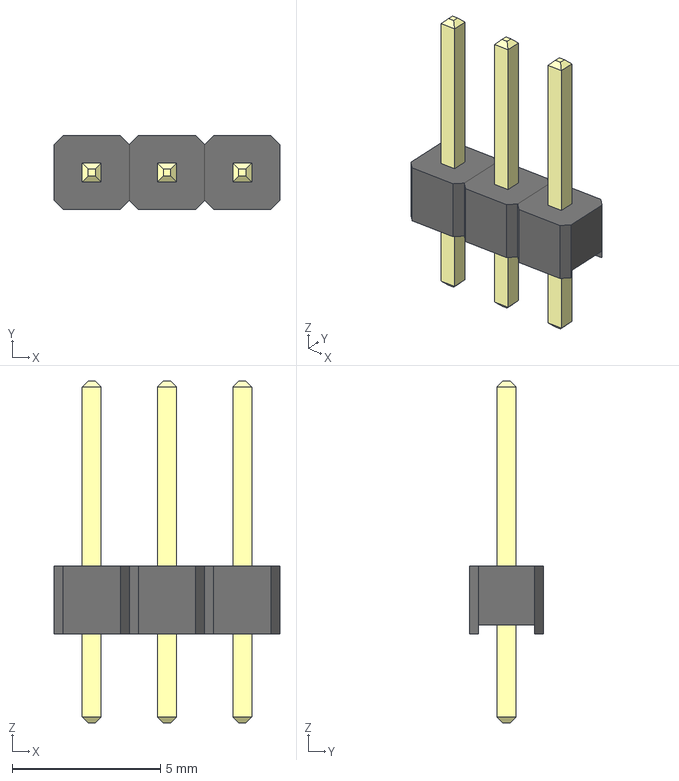
[picture p63: CAD file, 2016-02-04]
kicad/OTS_1/3d_models/Header_Male_03Pin.step
7.62 x 2.49 x 11.5 mm
