wyolum/VeloKey/kicad/OTS_2/3d_models/FeatherM0.fcstd

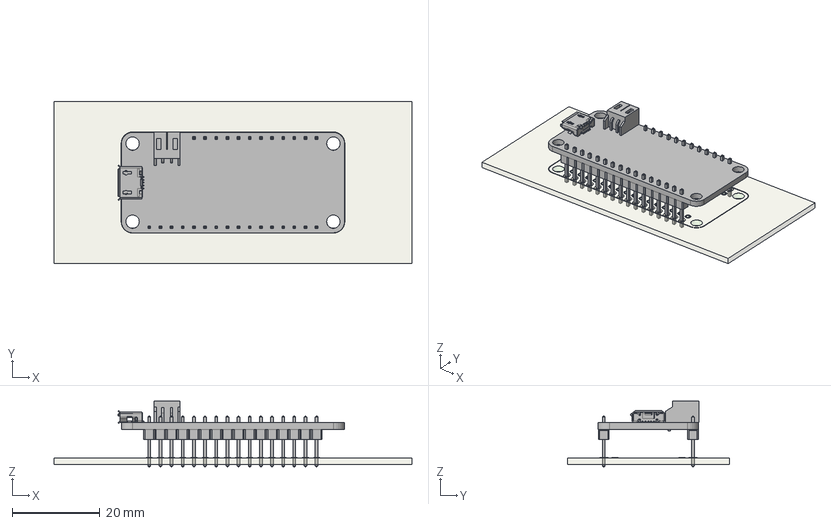
[picture p64: CAD file, 2016-03-31]
kicad/OTS_2/3d_models/FeatherM0.fcstd
81.5 x 36.8 x 14.9 mm
FrontSilk
TopPads
BotPads
PTHs
Pcb
M0
