wyolum/VeloKey/fabricate/OTS_1/case1.stl

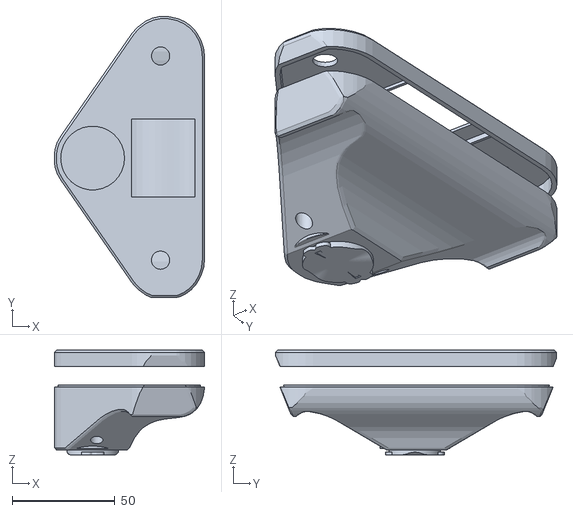
[picture p65: CAD file, 2016-03-05]
fabricate/OTS_1/case1.stl
72.9 x 136.6 x 50.9
