wyolum/VeloKey/kicad/OTS_1/3d_models/header_1x6_TH_2_54mm.step

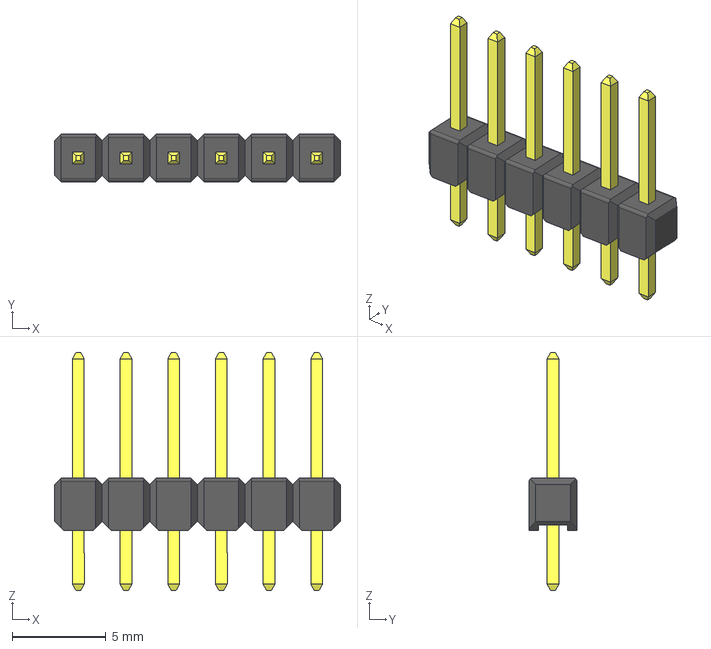
[picture p66: CAD file, 2016-02-04]
kicad/OTS_1/3d_models/header_1x6_TH_2_54mm.step
15.2 x 2.54 x 12.7 mm
