wyolum/VeloKey/kicad/OTS_2/3d_models/SW-800AWSPxM6.step

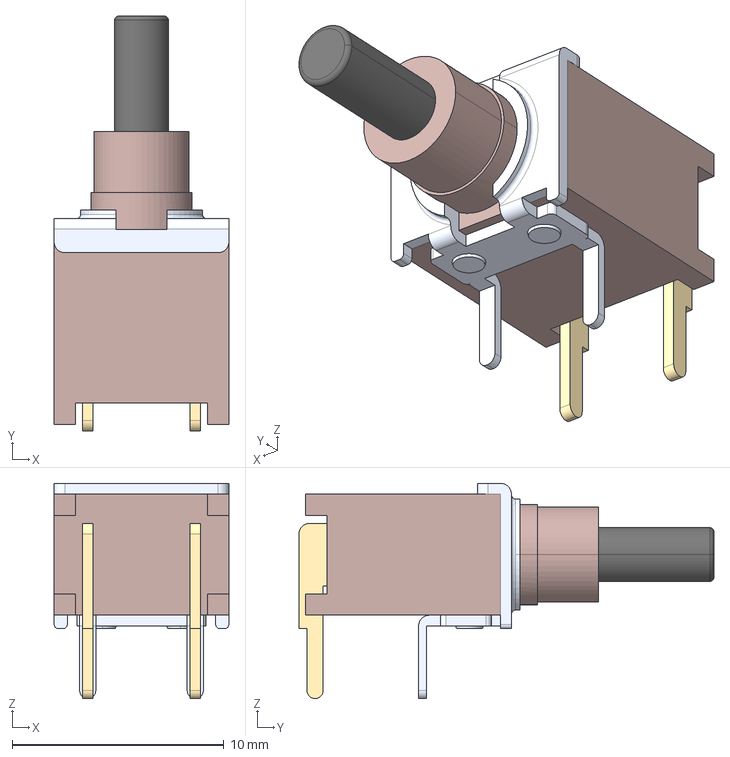
[picture p67: CAD file, 2016-03-31]
kicad/OTS_2/3d_models/SW-800AWSPxM6.step
8.25 x 19.6 x 10.2 mm
