wyolum/VeloKey/kicad/OTS_1/3d_models/Header_Male_06Pin.step

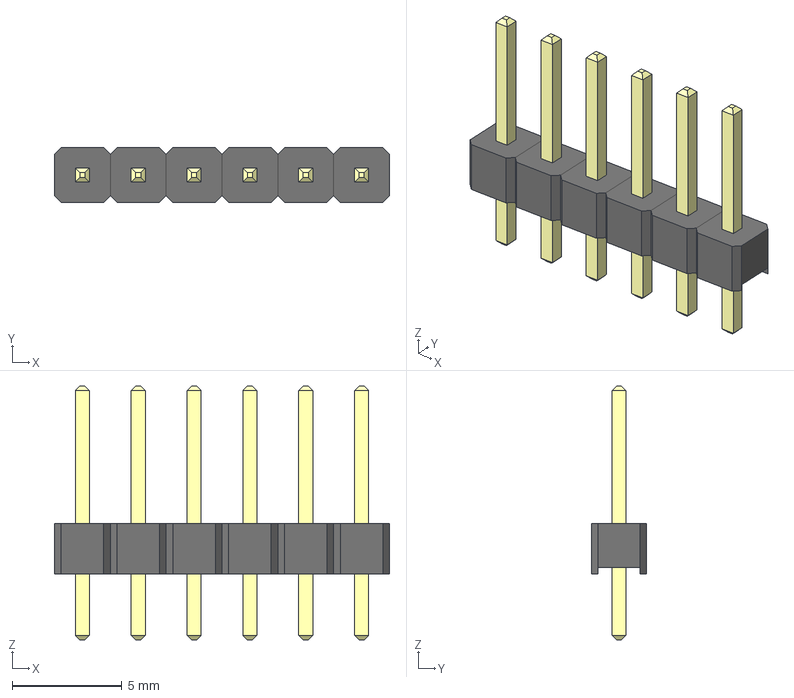
[picture p68: CAD file, 2016-02-04]
kicad/OTS_1/3d_models/Header_Male_06Pin.step
15.2 x 2.49 x 11.5 mm
