wyolum/VeloKey/kicad/OTS_2/3d_models/Res_smd_1210.step

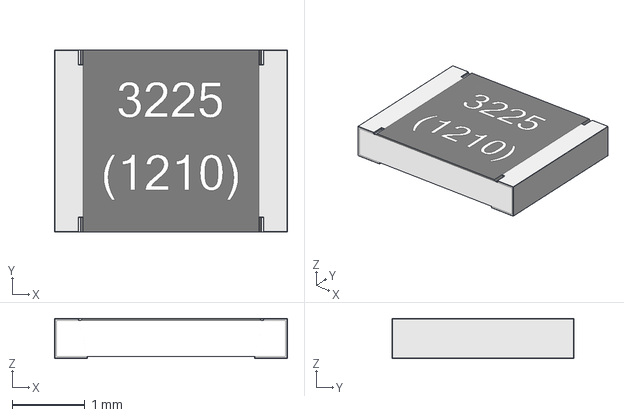
[picture p69: CAD file, 2016-03-31]
kicad/OTS_2/3d_models/Res_smd_1210.step
3.20 x 2.50 x 0.55 mm
