wyolum/VeloKey/fabricate/OTS_1/velokey_edge.dxf

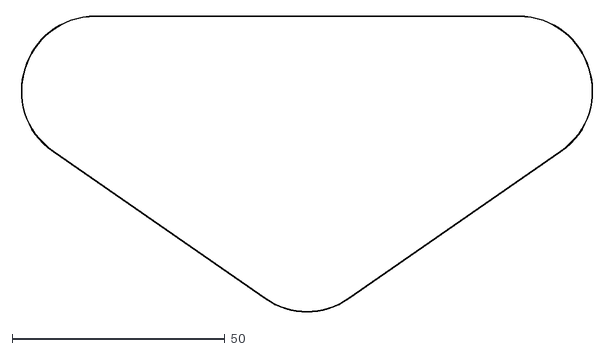
[picture p70: CAD file, 2016-02-25]
fabricate/OTS_1/velokey_edge.dxf
136.9 x 69.5
