wyolum/VeloKey/kicad/OTS_1/3d_models/Rotary_Encoder.step

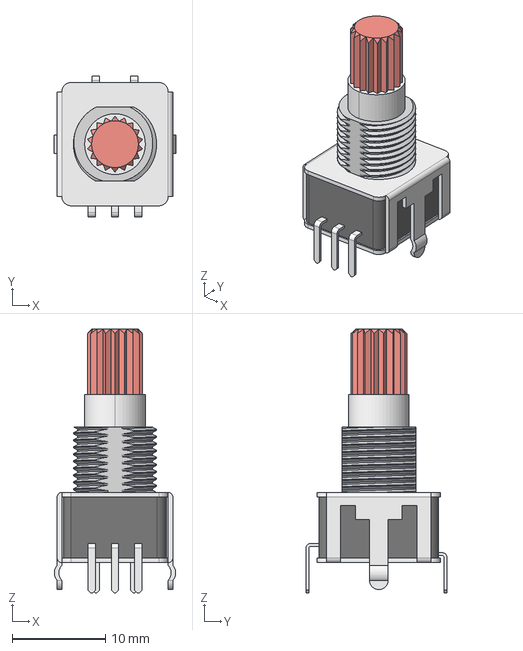
[picture p71: CAD file, 2016-02-04]
kicad/OTS_1/3d_models/Rotary_Encoder.step
13.0 x 15.1 x 28.3 mm
