wyolum/VeloKey/kicad/OTS_2/3d_models/Cap_smd_1210.step

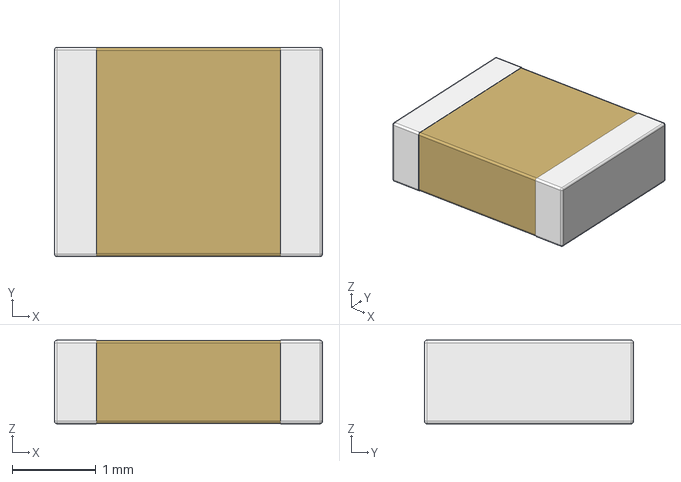
[picture p72: CAD file, 2016-03-31]
kicad/OTS_2/3d_models/Cap_smd_1210.step
3.20 x 2.50 x 1.00 mm
