wyolum/VeloKey/fabricate/OTS_1/velokey_outline.dxf

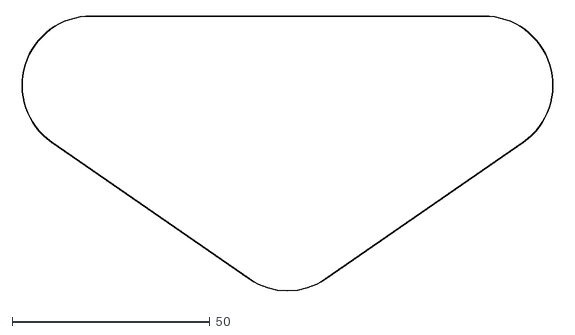
[picture p73: CAD file, 2016-02-25]
fabricate/OTS_1/velokey_outline.dxf
137.2 x 70.5
