wyolum/VeloKey/kicad/OTS_1/3d_models/Header_Male_01Pin.step

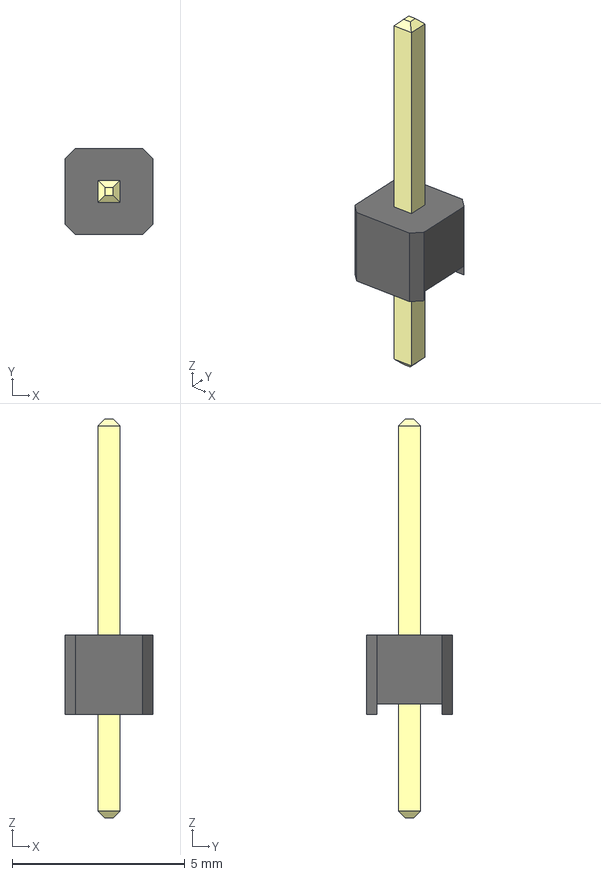
[picture p75: CAD file, 2016-02-04]
kicad/OTS_1/3d_models/Header_Male_01Pin.step
2.54 x 2.49 x 11.5 mm
