wyolum/VeloKey/fabricate/OTS_1/OTS.FCStd

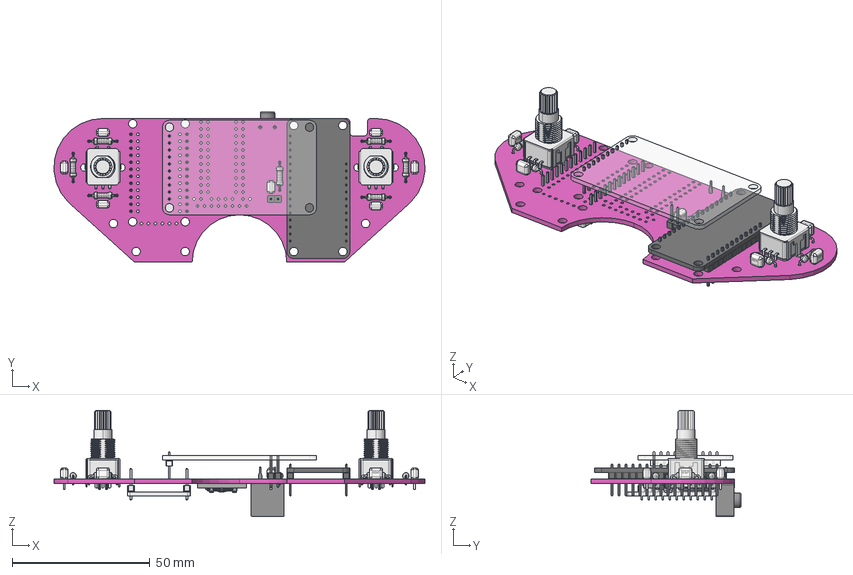
[picture p76: CAD file, 2016-02-05]
fabricate/OTS_1/OTS.FCStd
134.5 x 54.4 x 38.6 mm
Board_outline
Scale_
Scale_001
Scale_002
Scale_003
Scale_004
Scale_005
Scale_006
User_Library-Res40-Axial_Short_0.25W-10R_
User_Library-Res40-Axial_Short_0.25W-10R_001
User_Library-Res40-Axial_Short_0.25W-10R_002
User_Library-Res40-Axial_Short_0.25W-10R_003
User_Library-Res40-Axial_Short_0.25W-10R_004
User_Library-Res40-Axial_Short_0.25W-10R_005
User_Library-Res40-Axial_Short_0.25W-10R_006
