wyolum/VeloKey/kicad/OTS_1/3d_models/Header_Male_10Pin.step

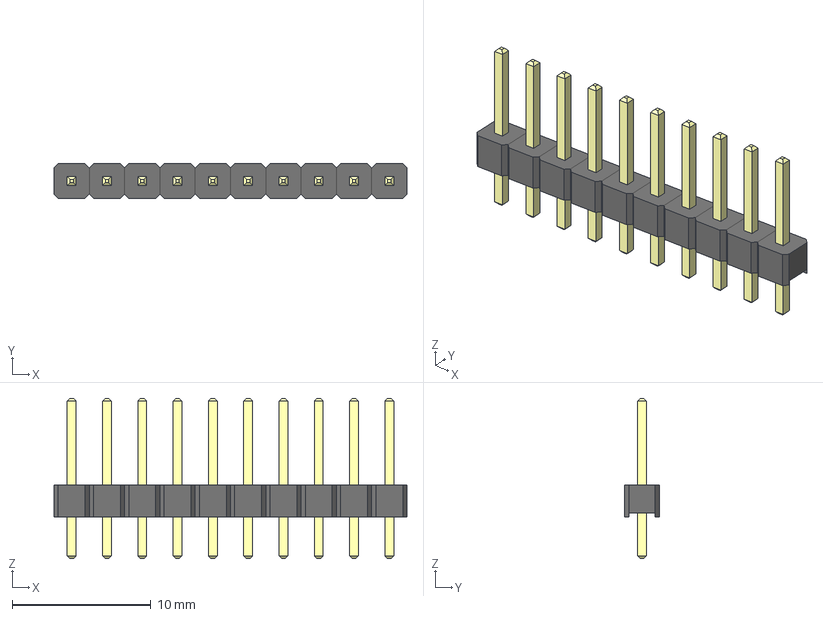
[picture p77: CAD file, 2016-02-04]
kicad/OTS_1/3d_models/Header_Male_10Pin.step
25.4 x 2.49 x 11.5 mm
