wyolum/VeloKey/kicad/OTS_1/3d_models/Header_Male_09Pin.step

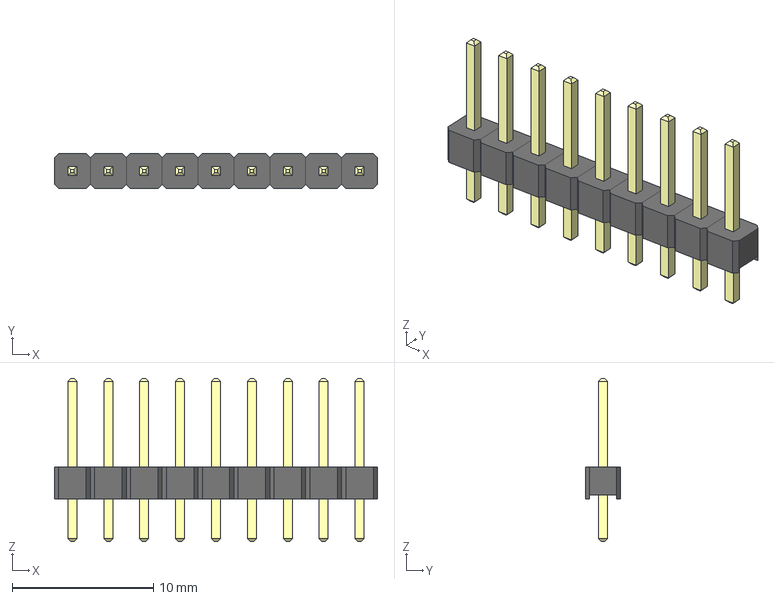
[picture p78: CAD file, 2016-02-04]
kicad/OTS_1/3d_models/Header_Male_09Pin.step
22.9 x 2.49 x 11.5 mm
