wyolum/VeloKey/kicad/OTS_1/3d_models/BlueFruit.step

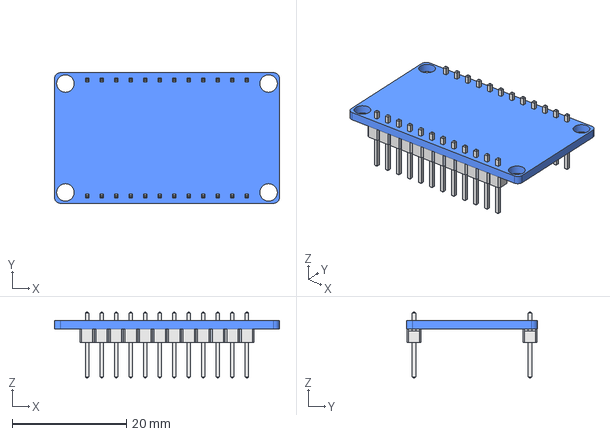
[picture p79: CAD file, 2016-02-04]
kicad/OTS_1/3d_models/BlueFruit.step
39.4 x 22.9 x 11.5 mm
