wyolum/VeloKey/kicad/OTS_1/3d_models/Header_Male_16Pin.step

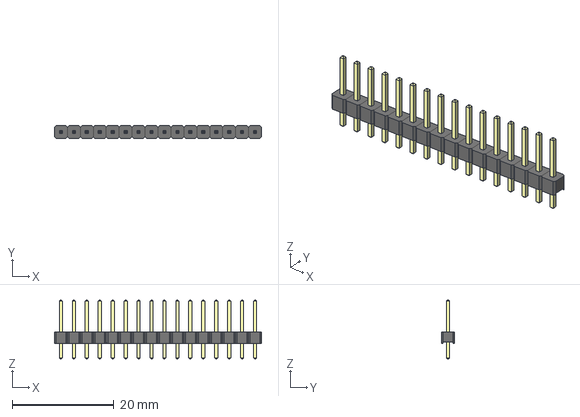
[picture p80: CAD file, 2016-02-04]
kicad/OTS_1/3d_models/Header_Male_16Pin.step
40.6 x 2.49 x 11.5 mm
