wyolum/VeloKey/kicad/OTS_1/3d_models/Header_Male_40Pin.step

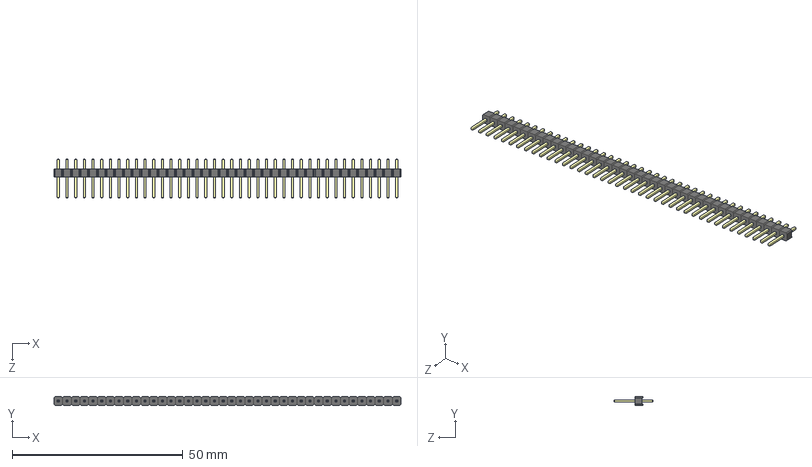
[picture p81: CAD file, 2016-02-04]
kicad/OTS_1/3d_models/Header_Male_40Pin.step
101.6 x 2.49 x 11.5 mm
User Library-Header_Male_40Pin_BodyArray
User Library-Header_Male_40Pin_PinArray
