wyolum/VeloKey/kicad/OTS_1/3d_models/Res40_AxialShort_0_25W-10k.step

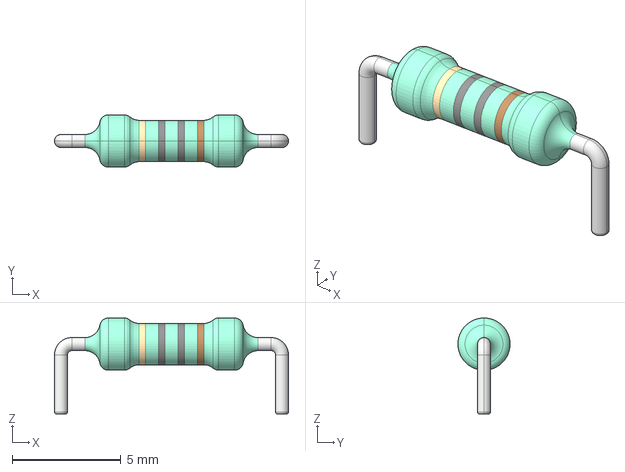
[picture p82: CAD file, 2016-02-04]
kicad/OTS_1/3d_models/Res40_AxialShort_0_25W-10k.step
10.8 x 2.40 x 4.41 mm
