wyolum/VeloKey/kicad/OTS_1/3d_models/Header_Male_08Pin.step

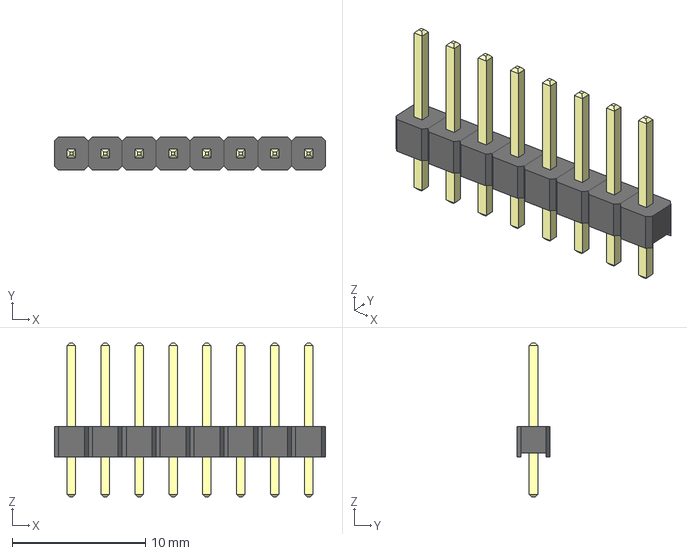
[picture p83: CAD file, 2016-02-04]
kicad/OTS_1/3d_models/Header_Male_08Pin.step
20.3 x 2.49 x 11.5 mm
