wyolum/VeloKey/(list of files, cad)

Other CAD files:
fabricate/OTS_2/boards/OTS2_encA.FCStd
fabricate/OTS_2/OTS2_6_bot.stl
fabricate/OTS_2/OTS2_6_top.stl
kicad/OTS_1/3d_models/SW_spdt.step
kicad/OTS_1/3d_models/SW_spst.step
kicad/OTS_2/3d_models/dip_switch_smd_x2_2.step
fabricate/OTS_1/case4_OTS.stl
fabricate/OTS_2/OTS2_4_top.stl
fabricate/OTS_1/VeloKey_dims.fcstd
kicad/OTS_2/3d_models/LCD_TFT_2.fcstd
fabricate/OTS_1/velokey.fcstd
kicad/OTS_2/3d_models/SW_spst.step
fabricate/OTS_1/case4_OTS.scad
fabricate/OTS_1/case5_OTS.scad
fabricate/OTS_1/case6_OTS.scad
fabricate/OTS_2/archive/OTS2_0.FCStd
fabricate/OTS_2/archive/OTS2_1.FCStd
fabricate/OTS_2/archive/OTS2_2.FCStd
fabricate/OTS_2/archive/OTS2_2.stl
fabricate/OTS_2/archive/OTS2_3.FCStd
fabricate/OTS_2/archive/OTS2_3.stl
fabricate/OTS_2/archive/OTS2_4_top.stl
fabricate/OTS_2/archive/OTS2_5_bot.stl
fabricate/OTS_2/archive/OTS2_5_top.stl
fabricate/OTS_2/archive/OTS2_6_bot.stl
fabricate/OTS_2/archive/OTS2_6_top.stl
fabricate/OTS_2/boards/OTS2_main.FCStd
kicad/OTS_1/3d_models/BlueFruit.fcstd
kicad/OTS_1/3d_models/FeatherM0.fcstd
kicad/OTS_1/3d_models/SW_spst.fcstd
kicad/OTS_2/3d_models/BlueFruit.fcstd
kicad/OTS_2/3d_models/LCD_TFT.fcstd
kicad/OTS_2/3d_models/SW_spst.fcstd
kicad/OTS_2/3d_models/enc_a.fcstd
