wyolum/VeloKey/fabricate/images/OTS2_4_01.png

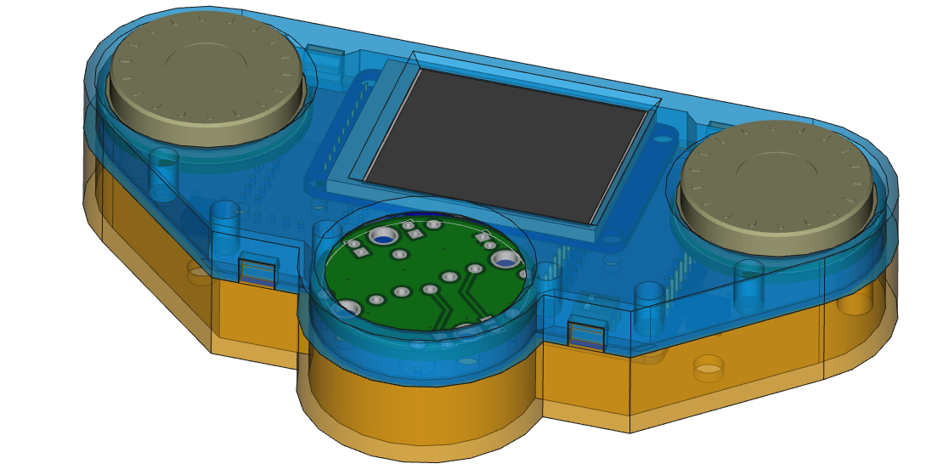
fabricate/images/OTS2_4_01.png
