wyolum/VeloKey/fabricate/images/OTS2_4_02.png

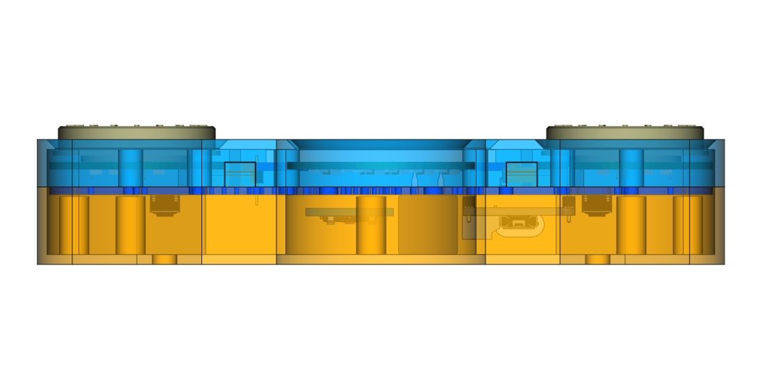
fabricate/images/OTS2_4_02.png
