wyolum/VeloKey/fabricate/images/OTS2_4_03.png

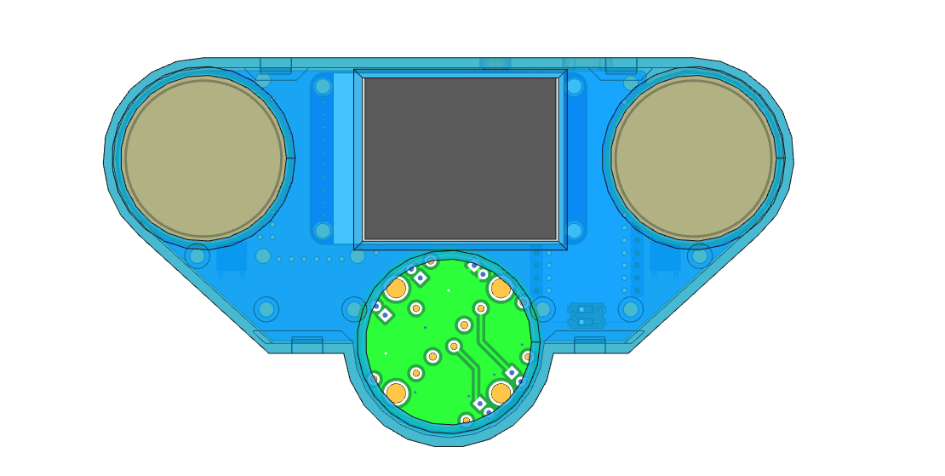
fabricate/images/OTS2_4_03.png
