wyolum/VeloKey/(threads)

Thread 1 (2016-02-15):

Power button holes are too small.

wyojustin, 2016-02-15:
The power button leads to not fit all the way down into the holes.  We need to make them a bit bigger.

wyojustin, 2016-02-15:
Posts are 1.5 mm.

Anool, 2016-02-15:
Switch pad hole diameter set to 1.6mm hole and 2.6mm pad dia.

wyojustin, 2016-04-01:
Confirmed in KiCad.

Closed 2016-02-15.

Thread 2 (2016-02-15):

Encoder holes are too small

wyojustin, 2016-02-15:
Encoder posts do not fit in holes.  Need to make bigger.

wyojustin, 2016-02-15:
posts are 1mm

Anool, 2016-02-15:
Encoder pads hole dia set to 1mm.

wyojustin, 2016-04-01:
New encoder part fits printed layout.

Closed 2016-02-15.

Thread 3 (2016-02-15):

Add reset button to reset M0

wyojustin, 2016-02-15:
Sometimes the M0 gets hung and the only way to revive it is to hit the reset button.  We need to break this out to the exterior of the case like bluetooth pair button.

Anool, 2016-03-27:
Added Reset button for M0 with pull up resistor.

Closed 2016-03-27.

Thread 4 (2016-02-16):

VeloKey_V1 locks up

wyojustin, 2016-02-16:
VeloKey_V1 locks up.  Seems to software as vk_display test can run for hours without locking up.

osbock, 2016-02-16:
have you performed a static analysis of RAM usage? or perhaps periodically
printing free_ram() periodically?

On Mon, Feb 15, 2016 at 10:45 PM, Justin Shaw <notifications@github.com>
wrote:

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

Anool, 2016-02-16:
On the hardware side, try adding a large (10uF  ~ 47uF) cap across the M0 power supply pins to take care of the occasional supply brownout, or a 100nF cap to take care of noise.

wyojustin, 2016-02-17:
Hard to test when it is intermittent.  Right now it seems to be working fine.

wyojustin, 2016-02-20:
Figured it out.  When there is no bluetooth link it locks up.  Need to check bt before writing to EZKey

wyojustin, 2016-02-20:
Looks like we need to monitor L2 on the EZLink for a 4 Hz sq wave.  This is the signal that a link is made.

https://learn.adafruit.com/introducing-bluefruit-ez-key-diy-bluetooth-hid-keyboard/pinouts

wyojustin, 2016-02-21:
Successful testing connecting EZ-Key L2 --> A4.  Please update schematic @Anool

Anool, 2016-02-22:
Connected EZKey L2 to M0 Pin A4

Anool, 2016-03-27:
Connected EZKey L2 to M0 Pin A4

wyojustin, 2016-04-01:
Fixed in SW.  Lock up occurs when trying to use BlueFruit when there is no link.   We now wait for link before starting BF serial.

Closed 2016-03-27.

Thread 5 (2016-02-17):

Move line from display lite to A5

wyojustin, 2016-02-17:
We might want to save battery when inactive.  If we move display LITE to A5, we can toggle the back light  on and off as necessary.

Anool, 2016-02-17:
A5 is the pin used for Power Up/Sleep. You mean to connect LCD LITE signal
to this same pin?
When M0 goes to sleep, so does the LCD, I thought.

Best Regards,

Anool Mahidharia
Work <http://www.lumetron.com/>
DiY <http://www.wyolum.com/>
Hackaday <http://hackaday.com/about/>
HackerSpace <http://www.makersasylum.com>
Git <https://github.com/anool>
Cycling <http://cyclists.in/profile/AnoolJM>
Workouts <http://www.dailymile.com/people/anool>
Flickr <http://www.flickr.com/photos/anool>
Picasa <http://picasaweb.google.com/anool.m>

On Wed, Feb 17, 2016 at 5:44 AM, Justin Shaw <notifications@github.com>
wrote:

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

wyojustin, 2016-02-17:
https://learn.adafruit.com/assets/30320

I don't see any special functionality on the Feather A5 pin from this
printout.  I really don't care which pin though.

On Wed, Feb 17, 2016 at 12:32 AM, Anool Mahidharia <notifications@github.com
> wrote:

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

--
Justin
<justin@wyolum.com>

Anool, 2016-02-22:
LCD Display LITE pin connected to Pin 20 of M0

wyojustin, 2016-03-05:
M0 pin does not have enough current to support display LITE.  Tested and failed.  Move display LITE pin back to 3v3.

wyojustin, 2016-03-06:
Comment from Anool:

> adding a simple transistor/FET will solve the display

Anool, 2016-03-07:
Let's first try with adding a series resistor on the A3 "LITE" pin. About
100 to 220 ohms. If that doesn't work, a MOSFET/Transistor will.

Best Regards,

Anool Mahidharia
Work <http://www.lumetron.com/>
DiY <http://www.wyolum.com/>
Hackaday <http://hackaday.com/about/>
HackerSpace <http://www.makersasylum.com>
Git <https://github.com/anool>
Cycling <http://cyclists.in/profile/AnoolJM>
Workouts <http://www.dailymile.com/people/anool>
Flickr <http://www.flickr.com/photos/anool>
Picasa <http://picasaweb.google.com/anool.m>

On Sun, Mar 6, 2016 at 5:12 PM, Justin Shaw <notifications@github.com>
wrote:

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

Anool, 2016-03-07:
How did you wire it up?
Per the data on Adafruit product page at :
https://www.adafruit.com/products/358
it says "2 white LED backlight, transistor connected so you can PWM dim the
backlight"

Which means you can connect micro controller pin directly to the LITE pin.

Best Regards,

Anool Mahidharia
Work <http://www.lumetron.com/>
DiY <http://www.wyolum.com/>
Hackaday <http://hackaday.com/about/>
HackerSpace <http://www.makersasylum.com>
Git <https://github.com/anool>
Cycling <http://cyclists.in/profile/AnoolJM>
Workouts <http://www.dailymile.com/people/anool>
Flickr <http://www.flickr.com/photos/anool>
Picasa <http://picasaweb.google.com/anool.m>

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

wyojustin, 2016-03-08:
Tried on an analog pin and a digital pin full power.  Will try again soon.

J

On Mon, Mar 7, 2016 at 8:50 AM, Anool Mahidharia <notifications@github.com>
wrote:

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

--
Justin
<justin@wyolum.com>

wyojustin, 2016-04-01:
TFT_LITE now connected to A3.  Tested with 5V PWM and works great.  Anool to add fall back via for direct connection if necessary.  Will close after change.

Closed 2016-04-01.

Thread 6 (2016-02-19):

encoder gets in the way of lipo jack.

wyojustin, 2016-02-19:
Anool: Maybe put M0 on the bottom.
Justin: But that is where lipo goes
Anool: put lipo under display

wyojustin, 2016-04-01:
New design accommodates JST connector

Closed 2016-04-01.

Thread 7 (2016-02-22):

Pin 28 on M0 is different on the bluetooth version. Disconnect

osbock, 2016-02-22:
Pin 16 is common gnd on both boards, connect to GND

Anool, 2016-02-22:
Disconnected Pin 28 of M0 from GND.
Connected Pin 16 of M0 to GND.

Best Regards,

Anool Mahidharia
Work <http://www.lumetron.com/>
DiY <http://www.wyolum.com/>
Hackaday <http://hackaday.com/about/>
HackerSpace <http://www.makersasylum.com>
Git <https://github.com/anool>
Cycling <http://cyclists.in/profile/AnoolJM>
Workouts <http://www.dailymile.com/people/anool>
Flickr <http://www.flickr.com/photos/anool>
Picasa <http://picasaweb.google.com/anool.m>

On Mon, Feb 22, 2016 at 9:01 AM, Kevin Osborn <notifications@github.com>
wrote:

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

Anool, 2016-03-27:
Connected Pin 16 to GND

Closed 2016-03-27.

Thread 8 (2016-03-06):

Add strain relief for PowerUp button leads

wyojustin, 2016-03-06:
I've broken a few power up leads at the solder joint.
Add a hole for the power up button leads to go through to relieve some strain on the solder joints.

Anool, 2016-03-07:
Added several holes around the board. This can be closed.

Closed 2016-03-07.

Thread 9 (2016-03-25):

Swap thumbwheels/ replace Powerup. --> OTS_V2

wyojustin, 2016-03-25:
Going to try new thumbwheels ENC_A ENC_B with : http://www.digikey.com/product-detail/en/c-k-components/TSWA3NCD23LFS/CKN10343-ND/2627682

Replace power up button with all-in-one L/R/U/D/S + scroll: http://www.digikey.com/product-search/en?keywords=ckn10345-nd

Closed 2016-04-01.

Thread 11 (2016-04-22):

Values and Labels swapped on R6 and C2 (OTS_2)

wyojustin, 2016-04-22:
Value or label swapped on OTS_2 board: C2/R6 1uF/10K.

Anool, 2016-04-22:
Labels are correct - C2 / R6
Values were swapped and are now corrected.

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

wyojustin, 2016-04-23:
Tested this configuration on unit #1.  Checks out.

Closed 2016-04-23.

Thread 12 (2016-04-23):

PIN 13 is used for LED.  Move  S2 to different pin

wyojustin, 2016-04-23:
LED prevents detection of button presses.

Anool, 2016-04-26:
Changed. Please review and close.

Closed 2016-04-26.

Thread 13 (2016-04-23):

Add micro switch to disconnect pro mini Rx/Tx from M0

wyojustin, 2016-04-23:
We need to be able to re-program the pro mini after soldering into the OTS board.  This switch will allow it.

Anool, 2016-04-26:
Added 2 way DIP switch. Please review and close.

Closed 2016-04-26.
