wyolum/VeloKey/kicad/data/Arduino-Zero-schematic.pdf

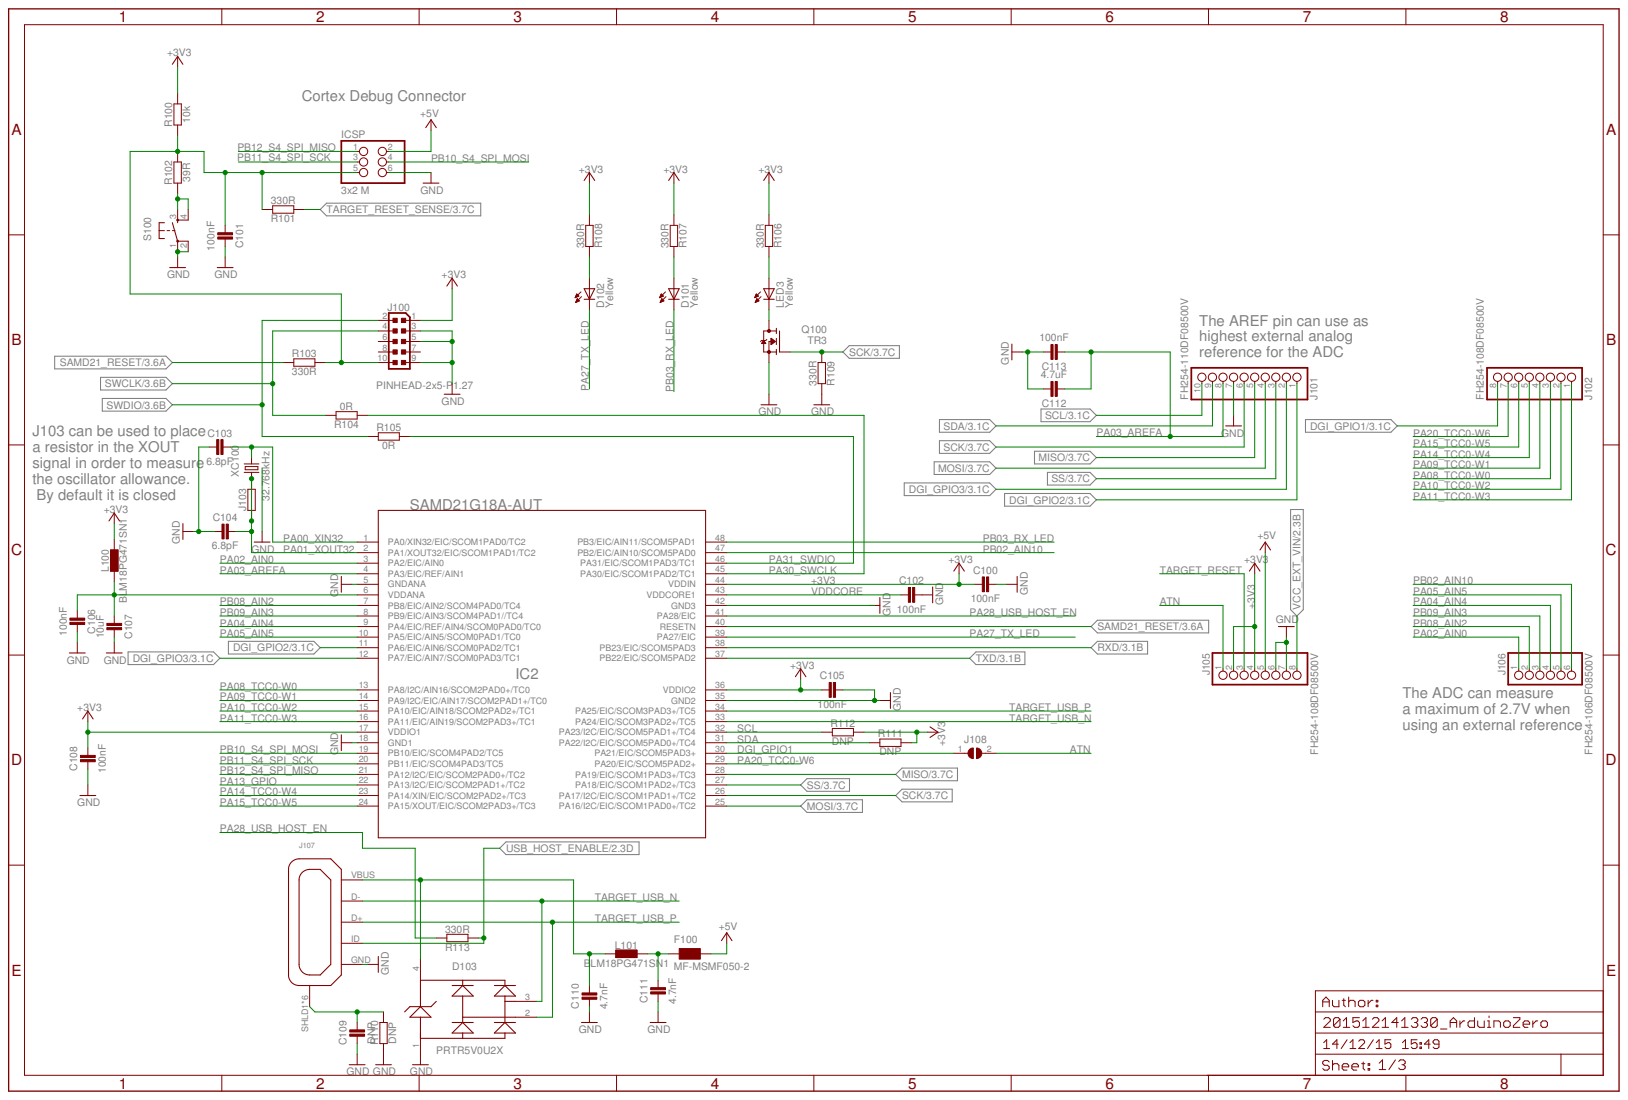
[picture p87: page 1]

The AREF pin can use as
highest external analog
reference for the ADC

J103 can be used to place
a resistor in the XOUT
signal in order to measure
the oscillator allowance. By default it is closed

The ADC can measure
a maximum of 2.7V when
using an external reference

D+D- VBUS

TARGET_USB_P

DNP DNP GND GND

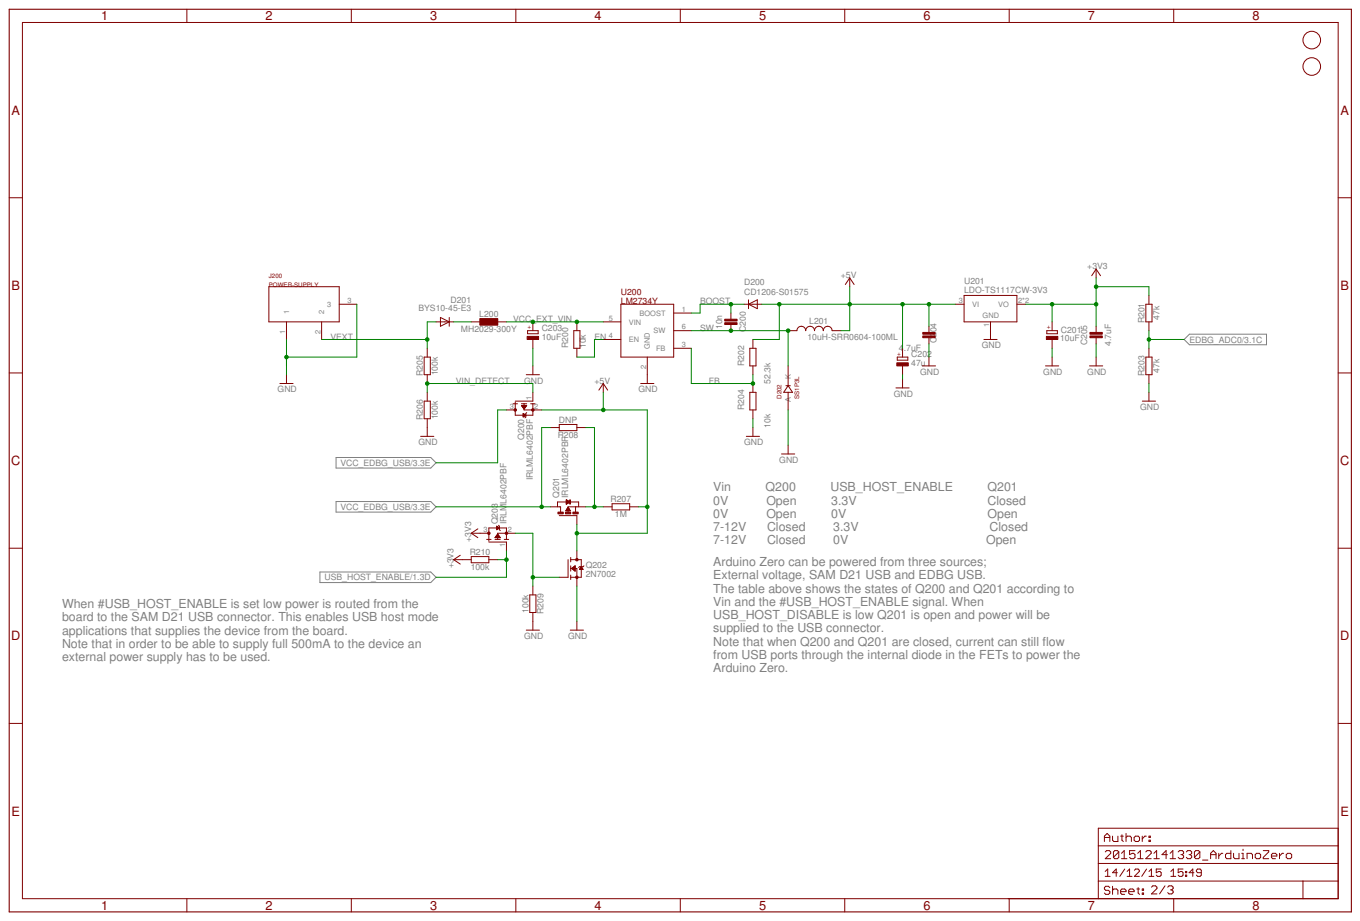
[picture p88: page 2]

Arduino Zero can be powered from three sources;
External voltage, SAM D21 USB and EDBG USB. The table above shows the states of Q200 and Q201 according to
Vin and the #USB_HOST_ENABLE signal. When
USB_HOST_DISABLE is low Q201 is open and power will be
supplied to the USB connector. Note that when Q200 and Q201 are closed, current can still flow
from USB ports through the internal diode in the FETs to power the
Arduino Zero.

When #USB_HOST_ENABLE is set low power is routed from the
board to the SAM D21 USB connector. This enables USB host mode
applications that supplies the device from the board. Note that in order to be able to supply full 500mA to the device an
external power supply has to be used.

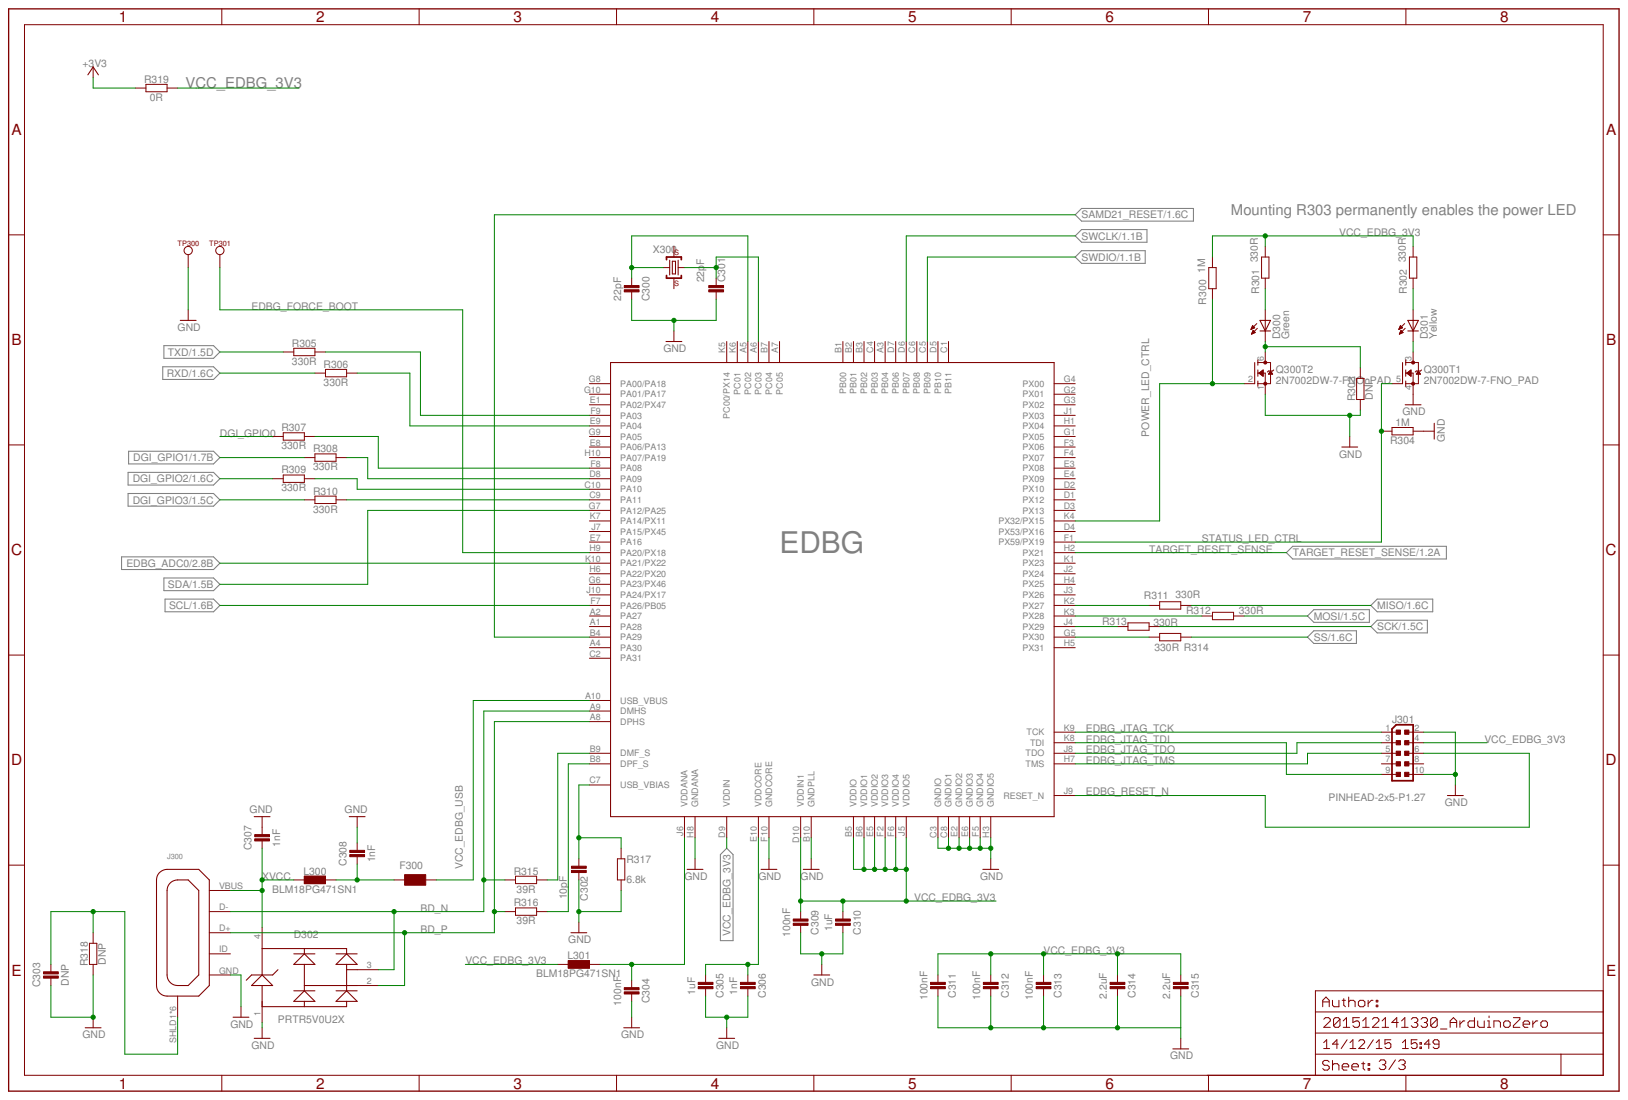
[picture p89: page 3]

Mounting R303 permanently enables the power LED

IDGND | | L301
