wyolum/VeloKey/kicad/data/SW_500A.pdf

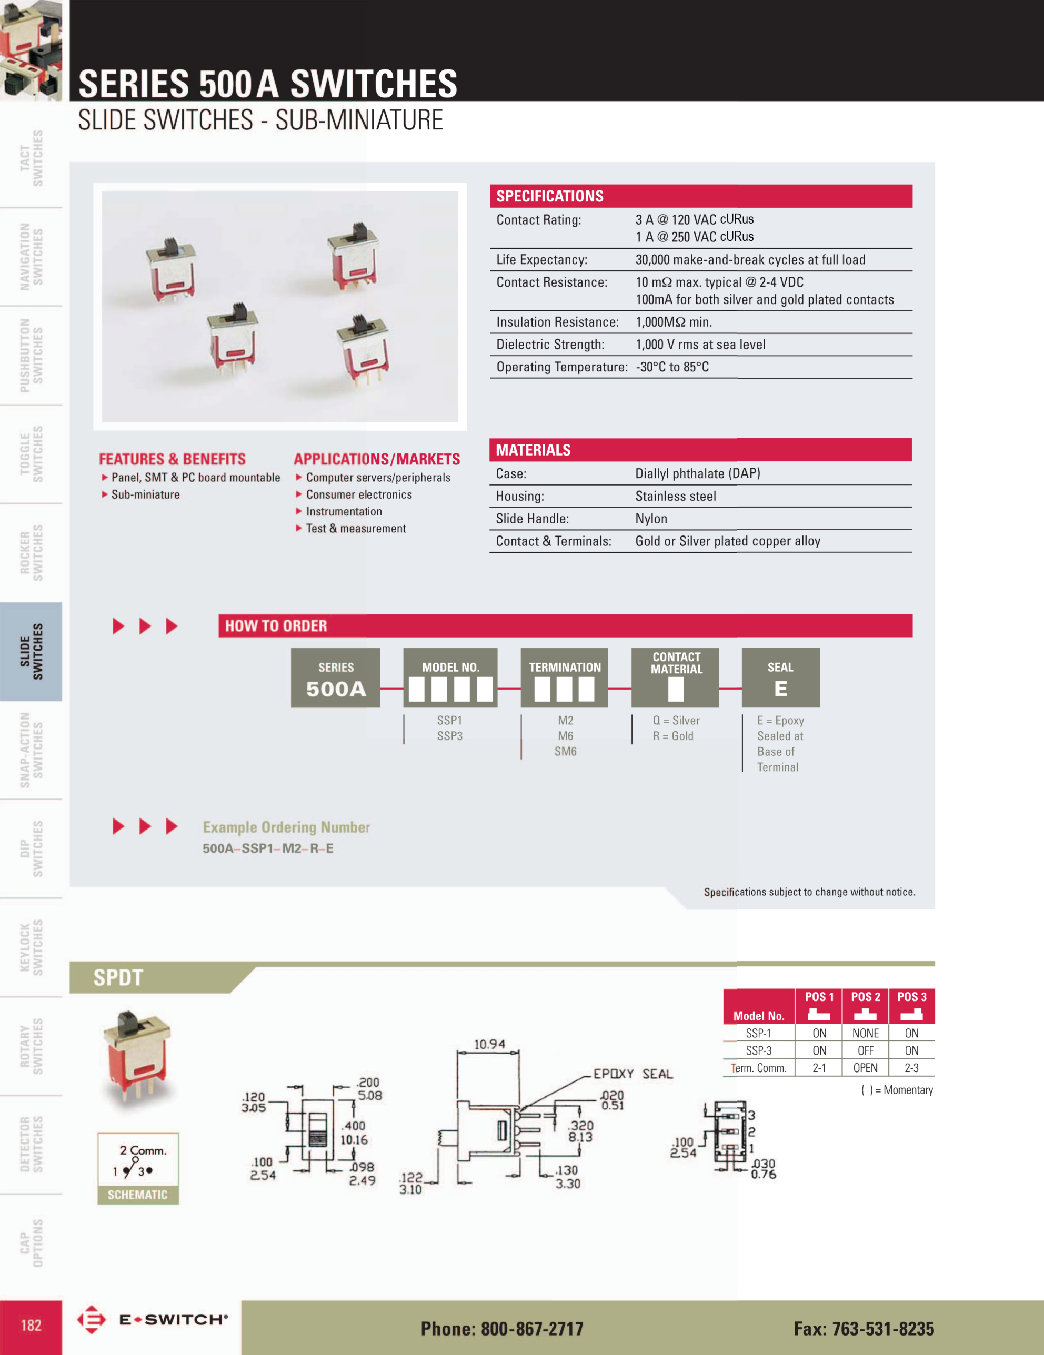
[picture p90: page 1]

M2

## PC PIN

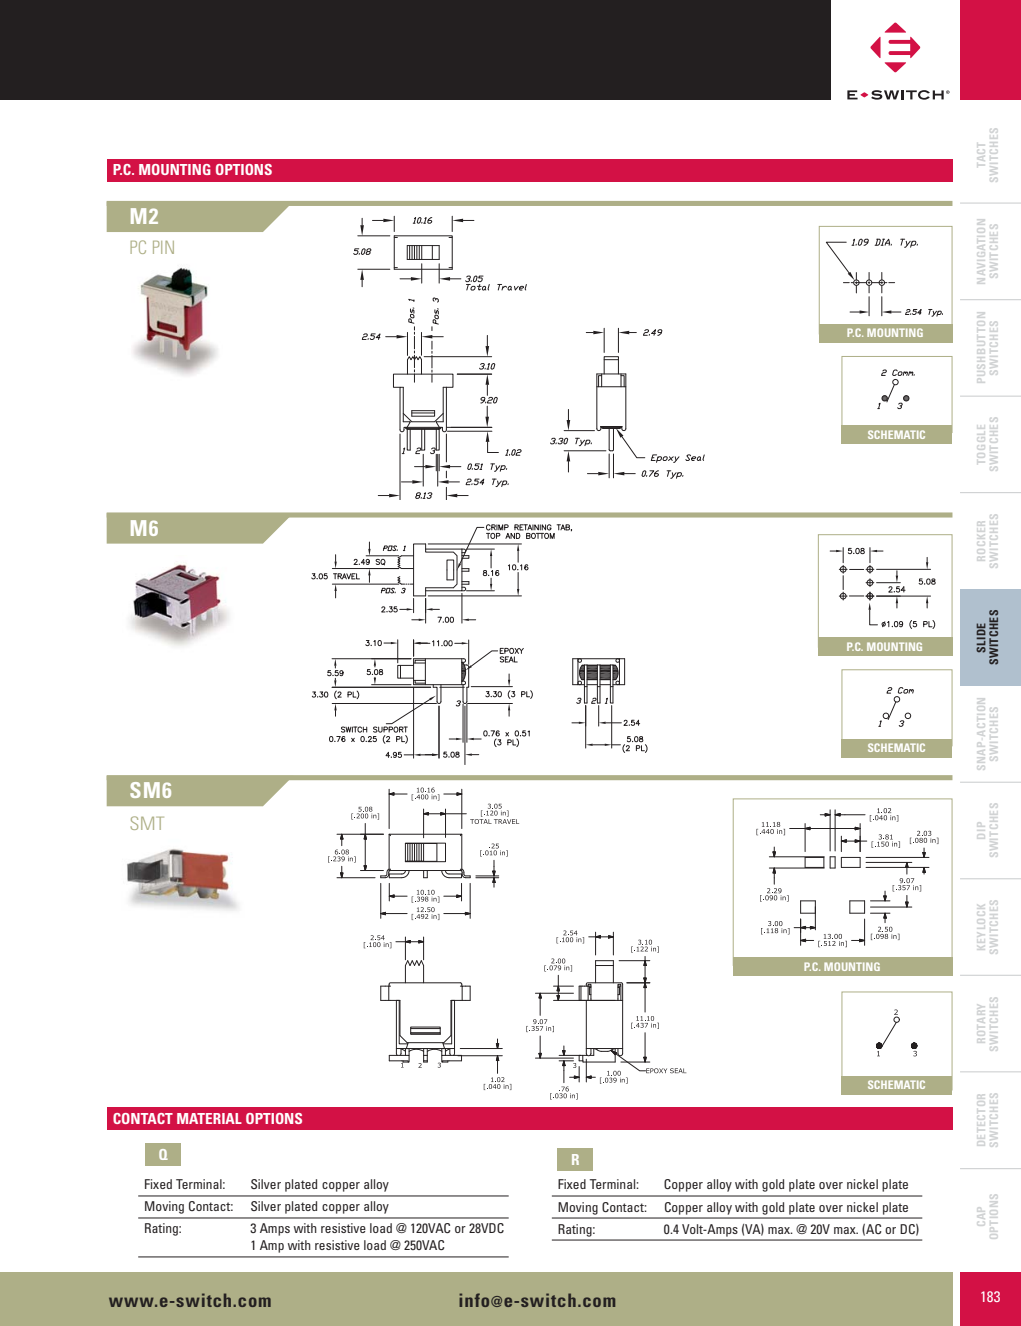
[picture p91: page 2]
www.e-switch.com; info@e-switch.com; 183 TACT SWITCHES NAVIGATION SWITCHES PUSHBUTTON SWITCHES TOGGLE SWITCHES ROCKER SWITCHES SLIDE SWITCHES SNAP⁻ACTION SWITCHES DIP SWITCHES KEYLOCK SWITCHES ROTARY SWITCHES DETECTOR SWITCHES CAP OPTIONS; Fixed Terminal:; Silver plated copper alloy; Moving Contact:; Rating:; 3 Amps with resistive load @ 120VAC or 28VDC; Copper alloy with gold plate over nickel plate; 0.4 Volt-Amps (VA) max. @ 20V max. (AC or DC); P.C. MOUNTING OPTIONS; P.C. MOUNTING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

CONTACT MATERIAL OPTIONS

1 Amp with resistive load @ 250VAC
