wyolum/VeloKey/kicad/data/SW_T511006.pdf

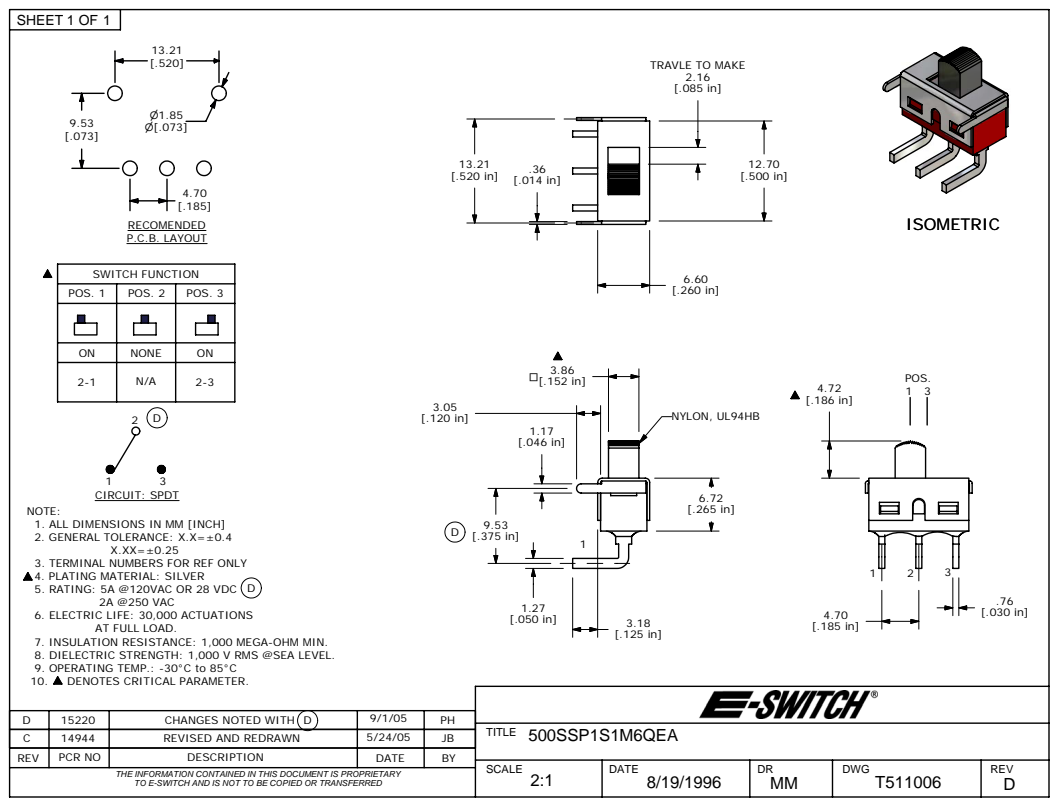
[picture p92: page 1]
ISOMETRIC; TITLE; THE INFORMATION CONTAINED IN THIS DOCUMENT IS PROPRIETARY; SCALE; DATE; DWG; REV; SHEET OF; 500SSP1S1M6QEA; POS. 1 3; POS. 1; POS. 2; POS. 3; SWITCH FUNCTION; TRAVLE TO MAKE; CIRCUIT: SPDT; 2A @250 VAC; NYLON, UL94HB; RECOMENDED P.C.B. LAYOUT; CHANGES NOTED WITH D

ON | NONE | ON

NOTE:
1. ALL DIMENSIONS IN MM [INCH]
2. GENERAL TOLERANCE: X.X=±0.4

3. TERMINAL NUMBERS FOR REF ONLY
4. PLATING MATERIAL: SILVER
5. RATING: 5A @120VAC OR 28 VDC

6. ELECTRIC LIFE: 30,000 ACTUATIONS

AT FULL LOAD.

7. INSULATION RESISTANCE: 1,000 MEGA-OHM MIN.
8. DIELECTRIC STRENGTH: 1,000 V RMS @SEA LEVEL.
9. OPERATING TEMP.: -30°C to 85°C
10. DENOTES CRITICAL PARAMETER.

C | 14944 | REVISED AND REDRAWN | 5/24/05 | JB
REV | PCR NO | DESCRIPTION | DATE | BY

TO E-SWITCH AND IS NOT TO BE COPIED OR TRANSFERRED
