wyolum/VeloKey/kicad/OTS_2/pdf/OTS2.pdf

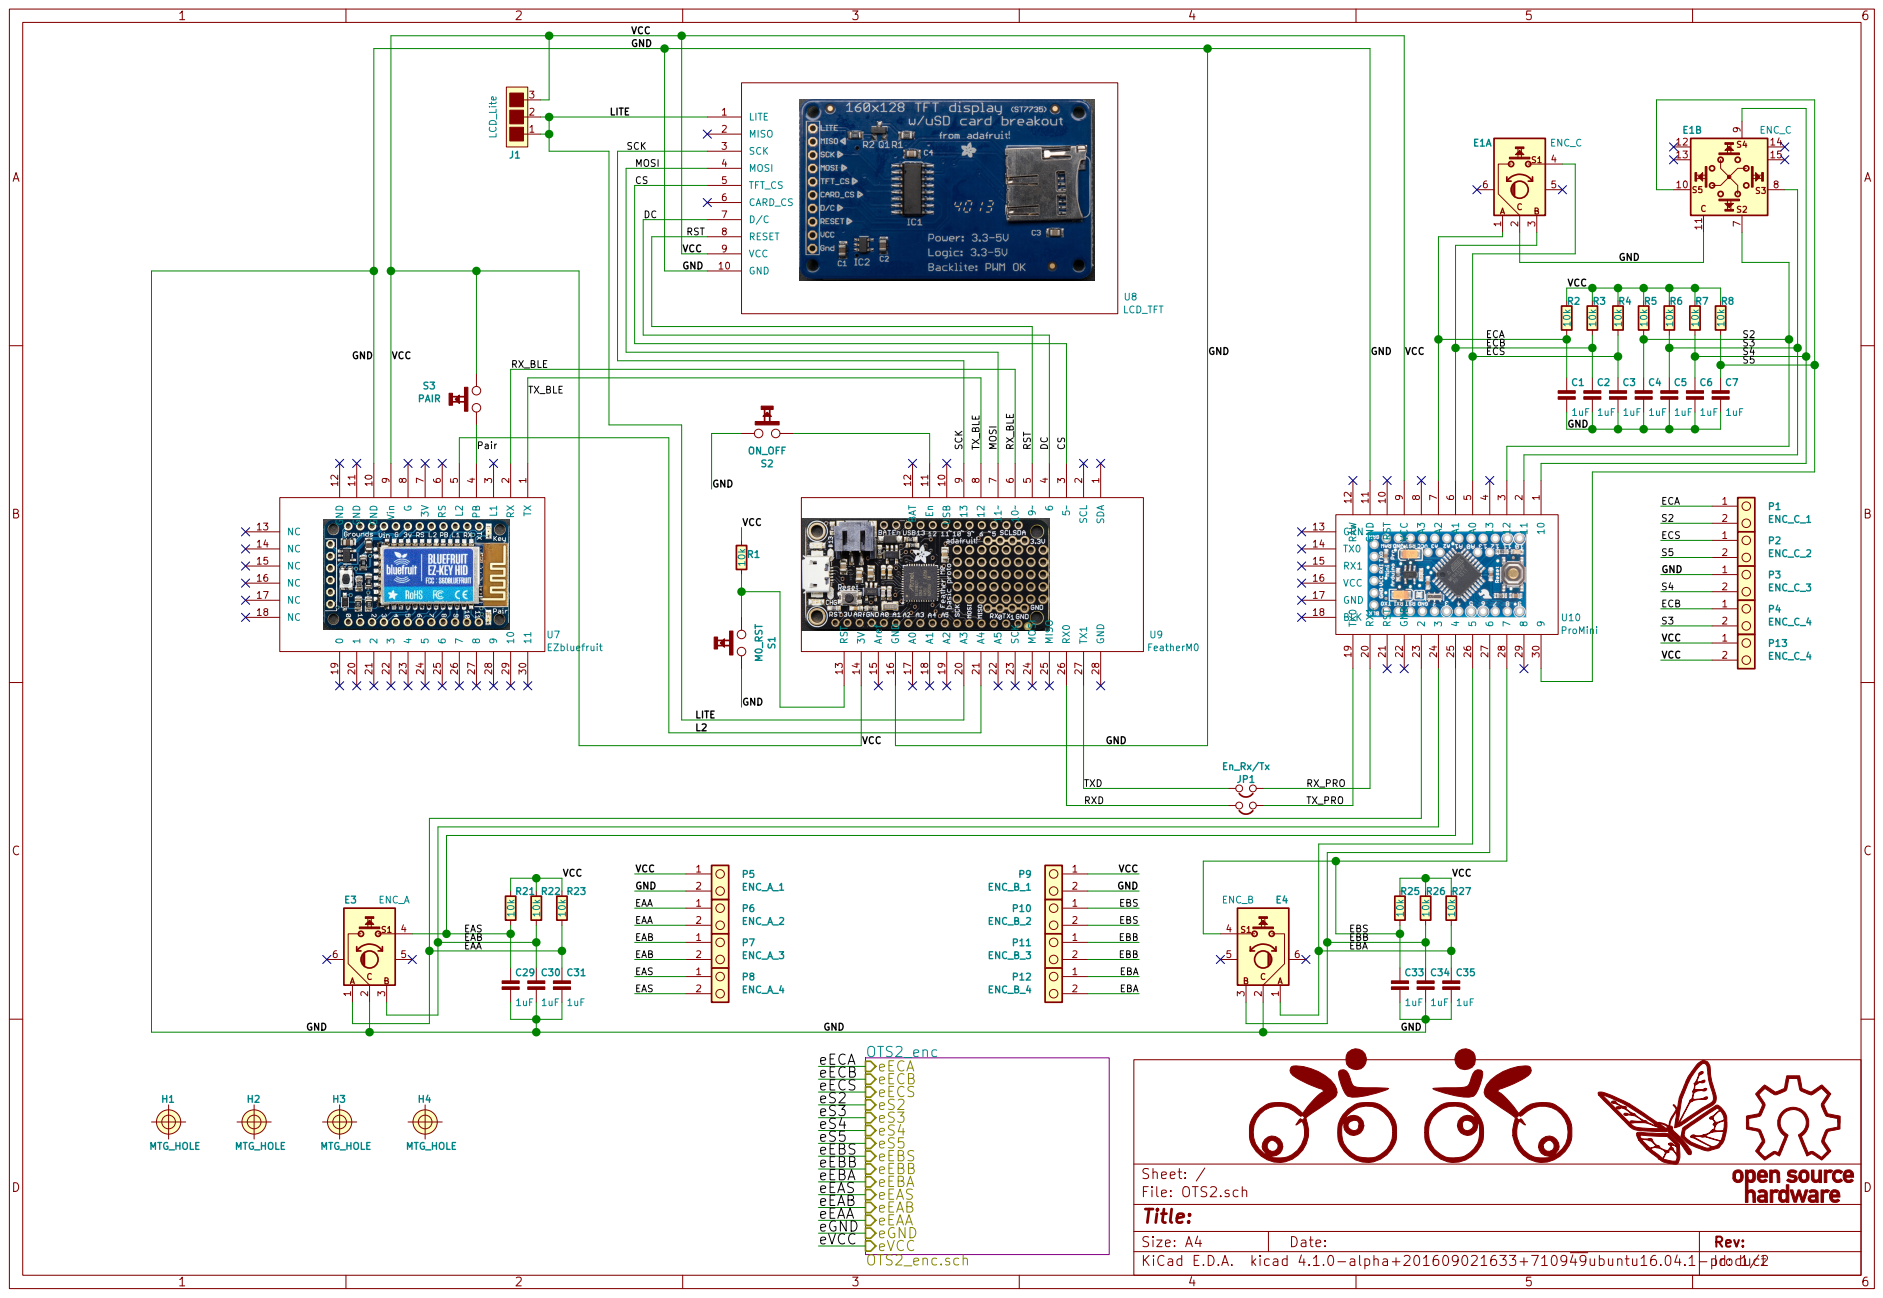
[picture p93: page 1]

ECB
ECS

9 USB 10 A3 20 En 11 A4 21 BAT 12 A5 22 RST 13 SCK 23 3V 14 MOSI 24 Aref 15 MISO 25 GND 16 RX0 26 A0 17 TX1 27 A1 18 GND 28 A2 19 U9 FeatherM0 10

9 30 GND 11 RST 21 RAW 12 GND 22 GRN 13

Id: 1/2 Title: File: OTS2.sch Sheet: /

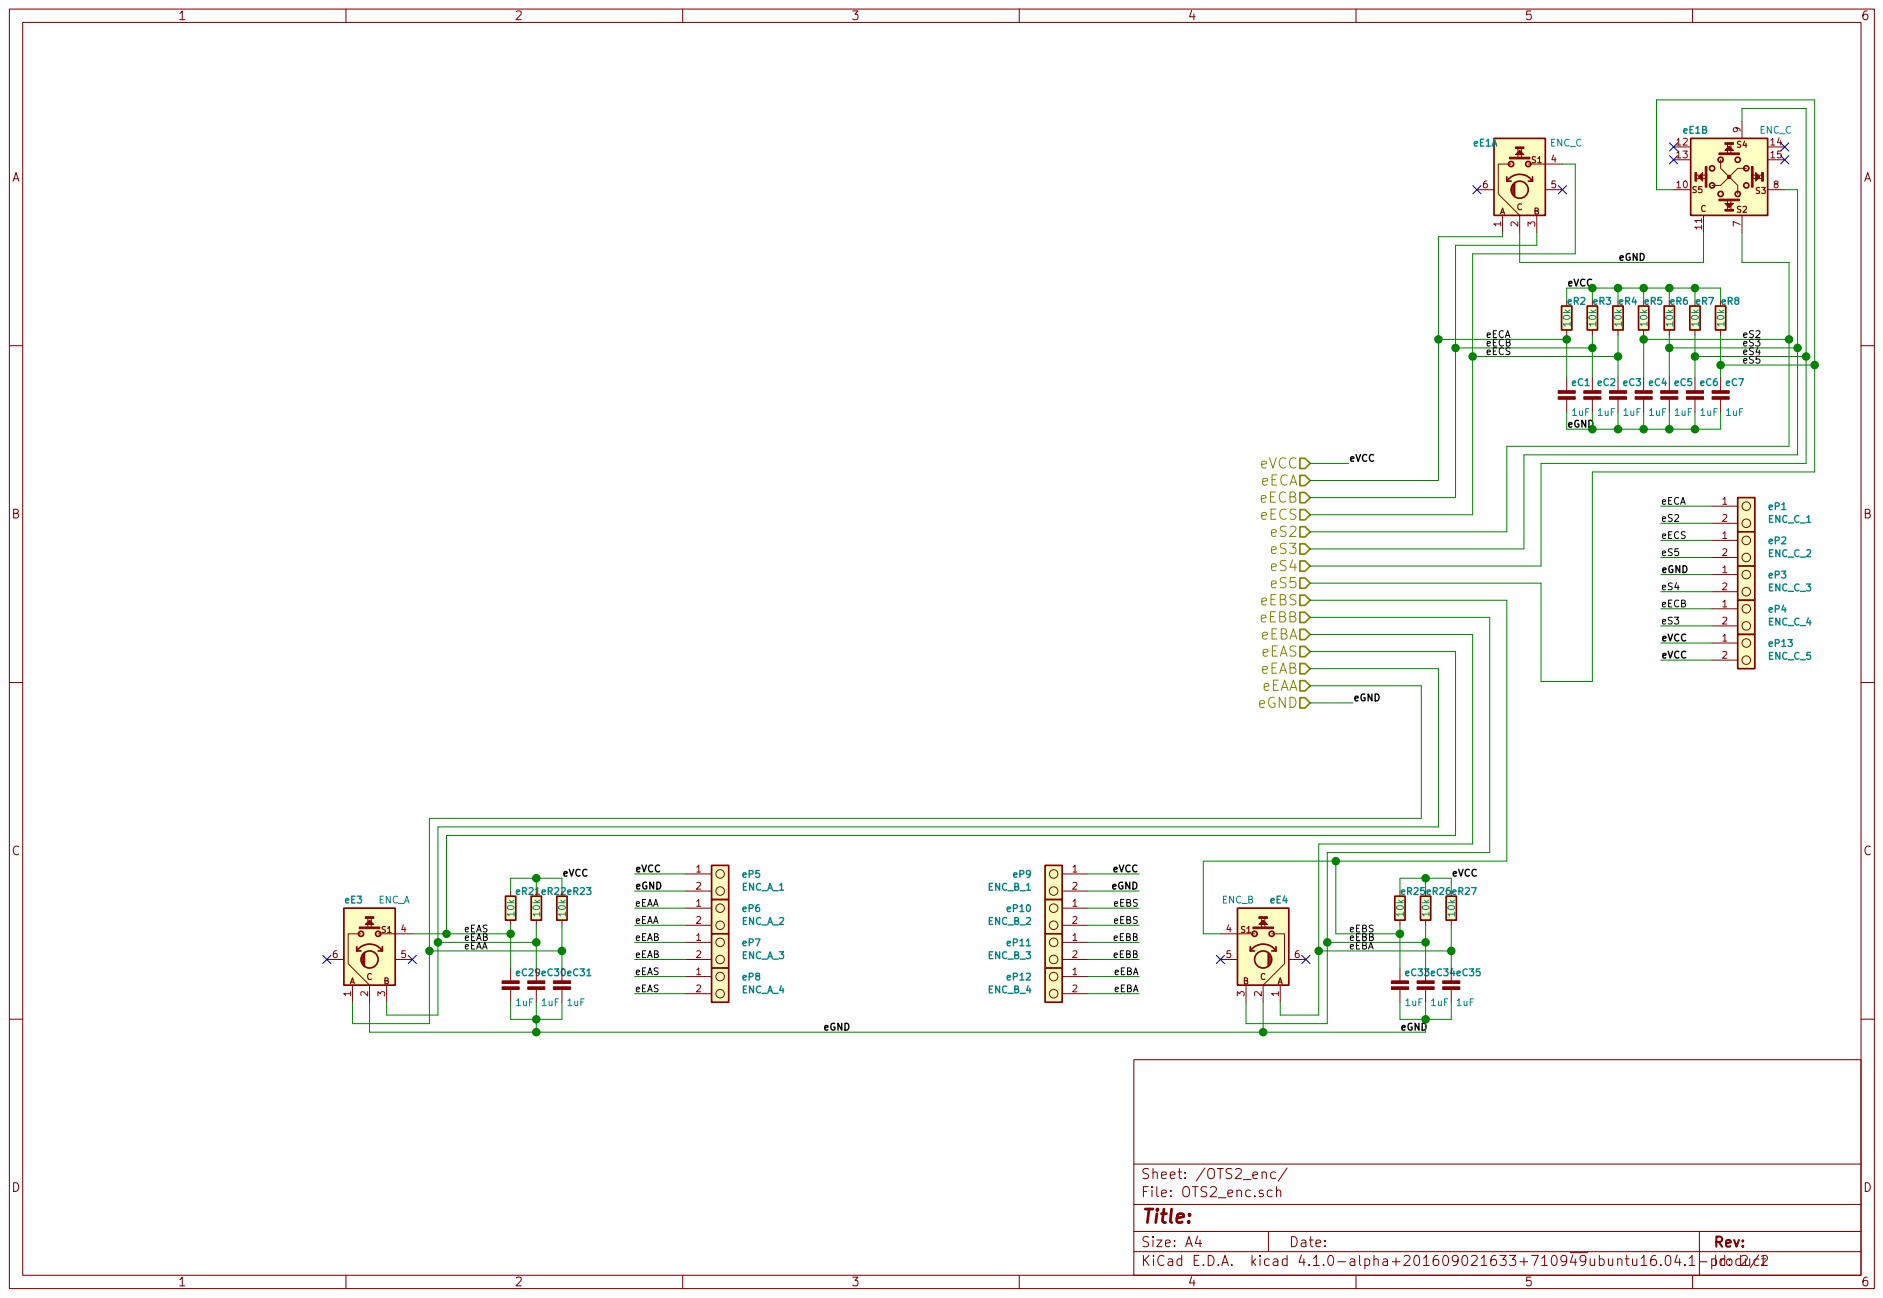
[picture p94: page 2]
