wyolum/VeloKey/kicad/OTS_1/pdf/OTS-Dwgs.User.pdf

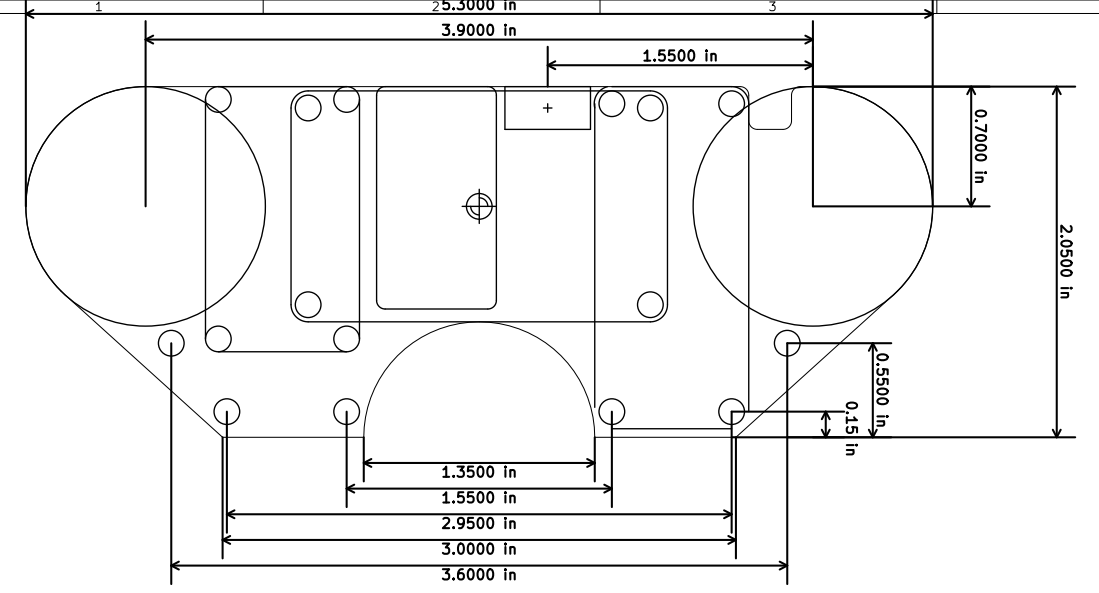
[picture p95: page 1]

File: OTS.kicad_pcb Sheet: 0.7000 in
