wyolum/VeloKey/kicad/OTS_1/pdf/velokey.pdf

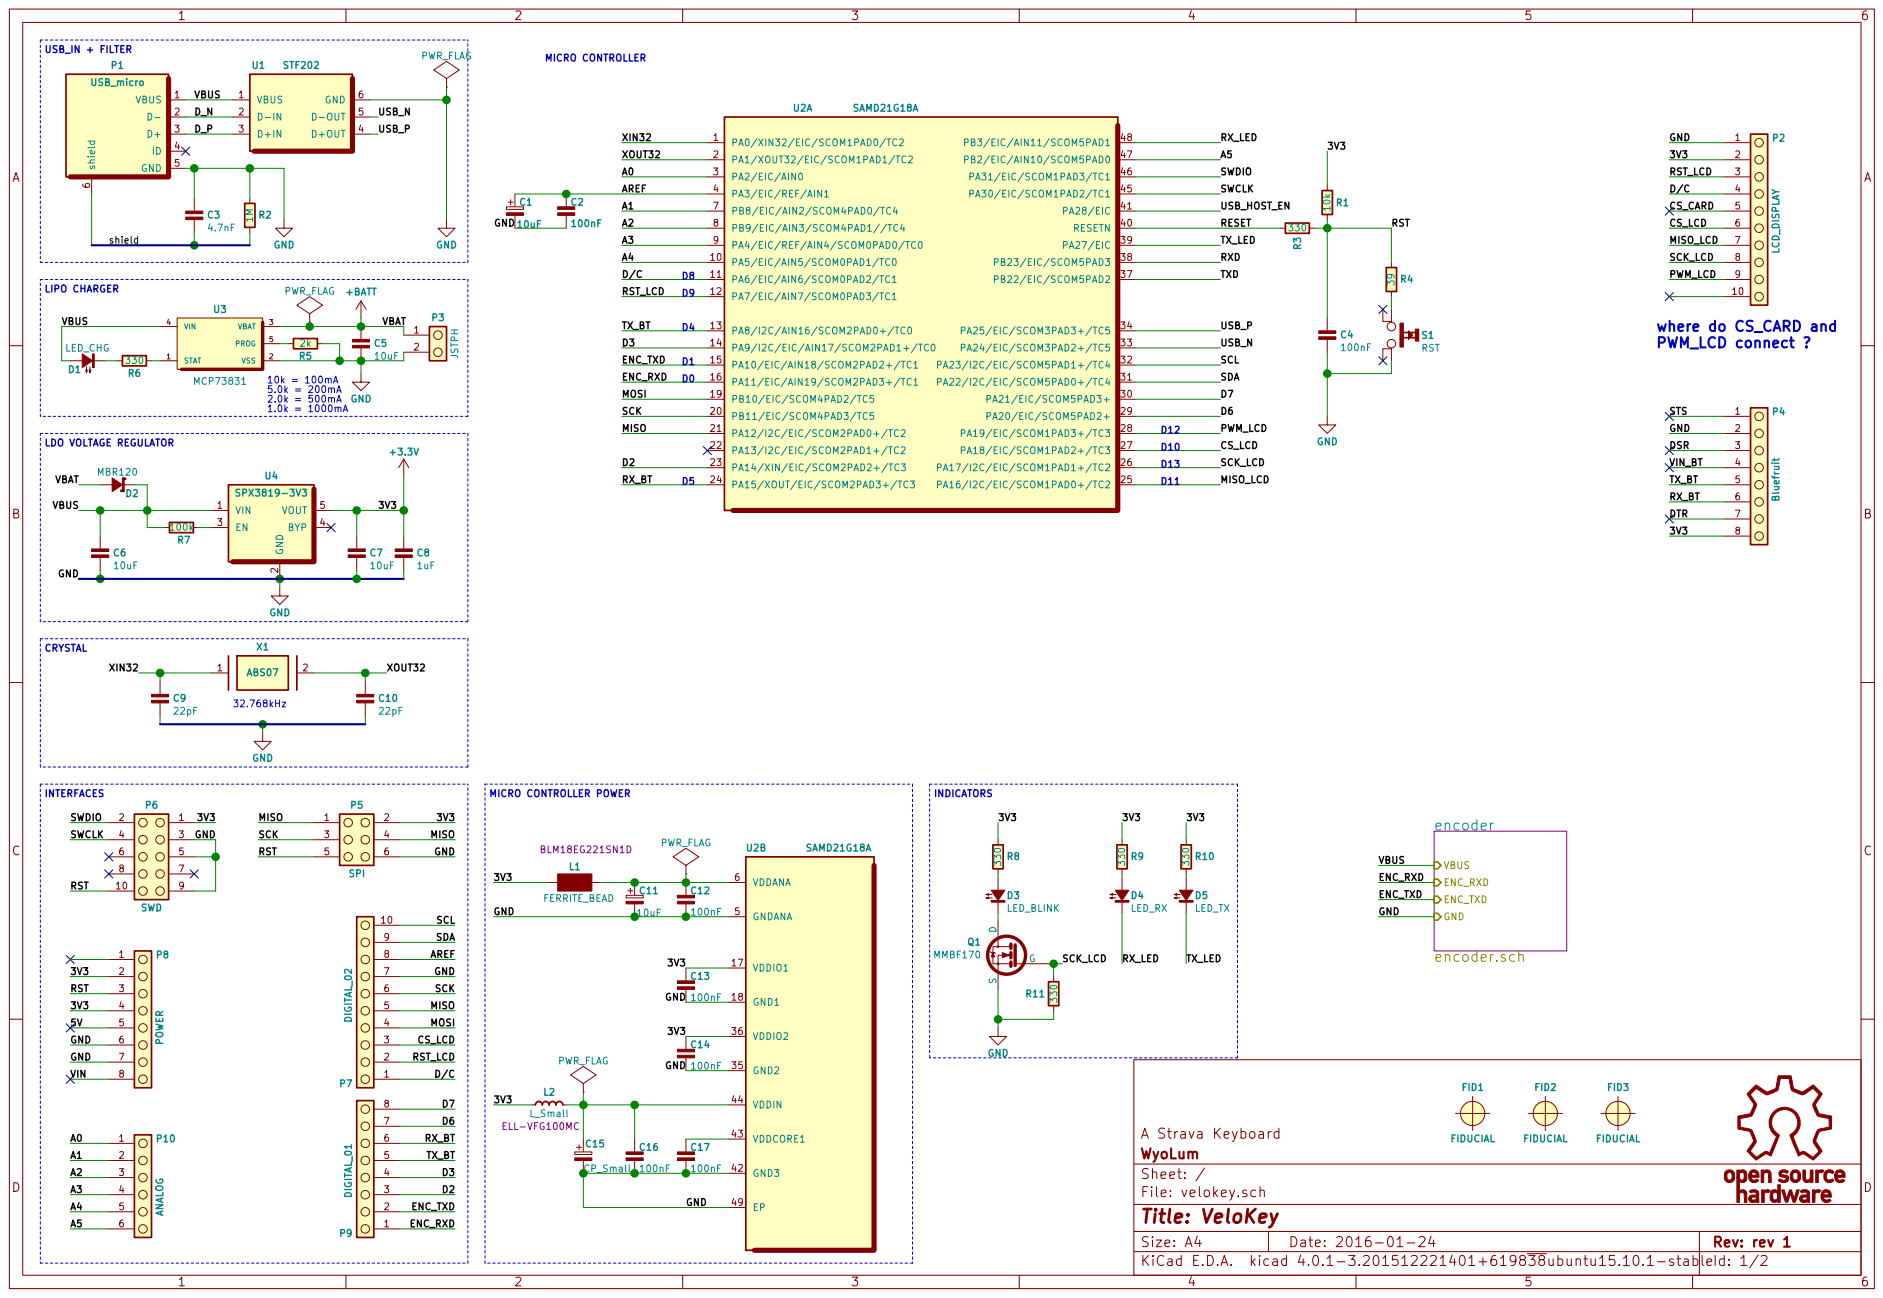
[picture p96: page 1]

6 P1 USB_micro VBUS 1 D-IN 2 D+IN 3 D+OUT 4 D-OUT 5 GND 6 U1 STF202 C7

LIPO CHARGER PWR_FLAG +BATT

STAT 1 PROG VSS | 2 VBAT 5 U3 MCP73831 D1 3 VIN 4

SCL VIN GND GND

A Strava Keyboard
File: velokey.sch Sheet: / WyoLum

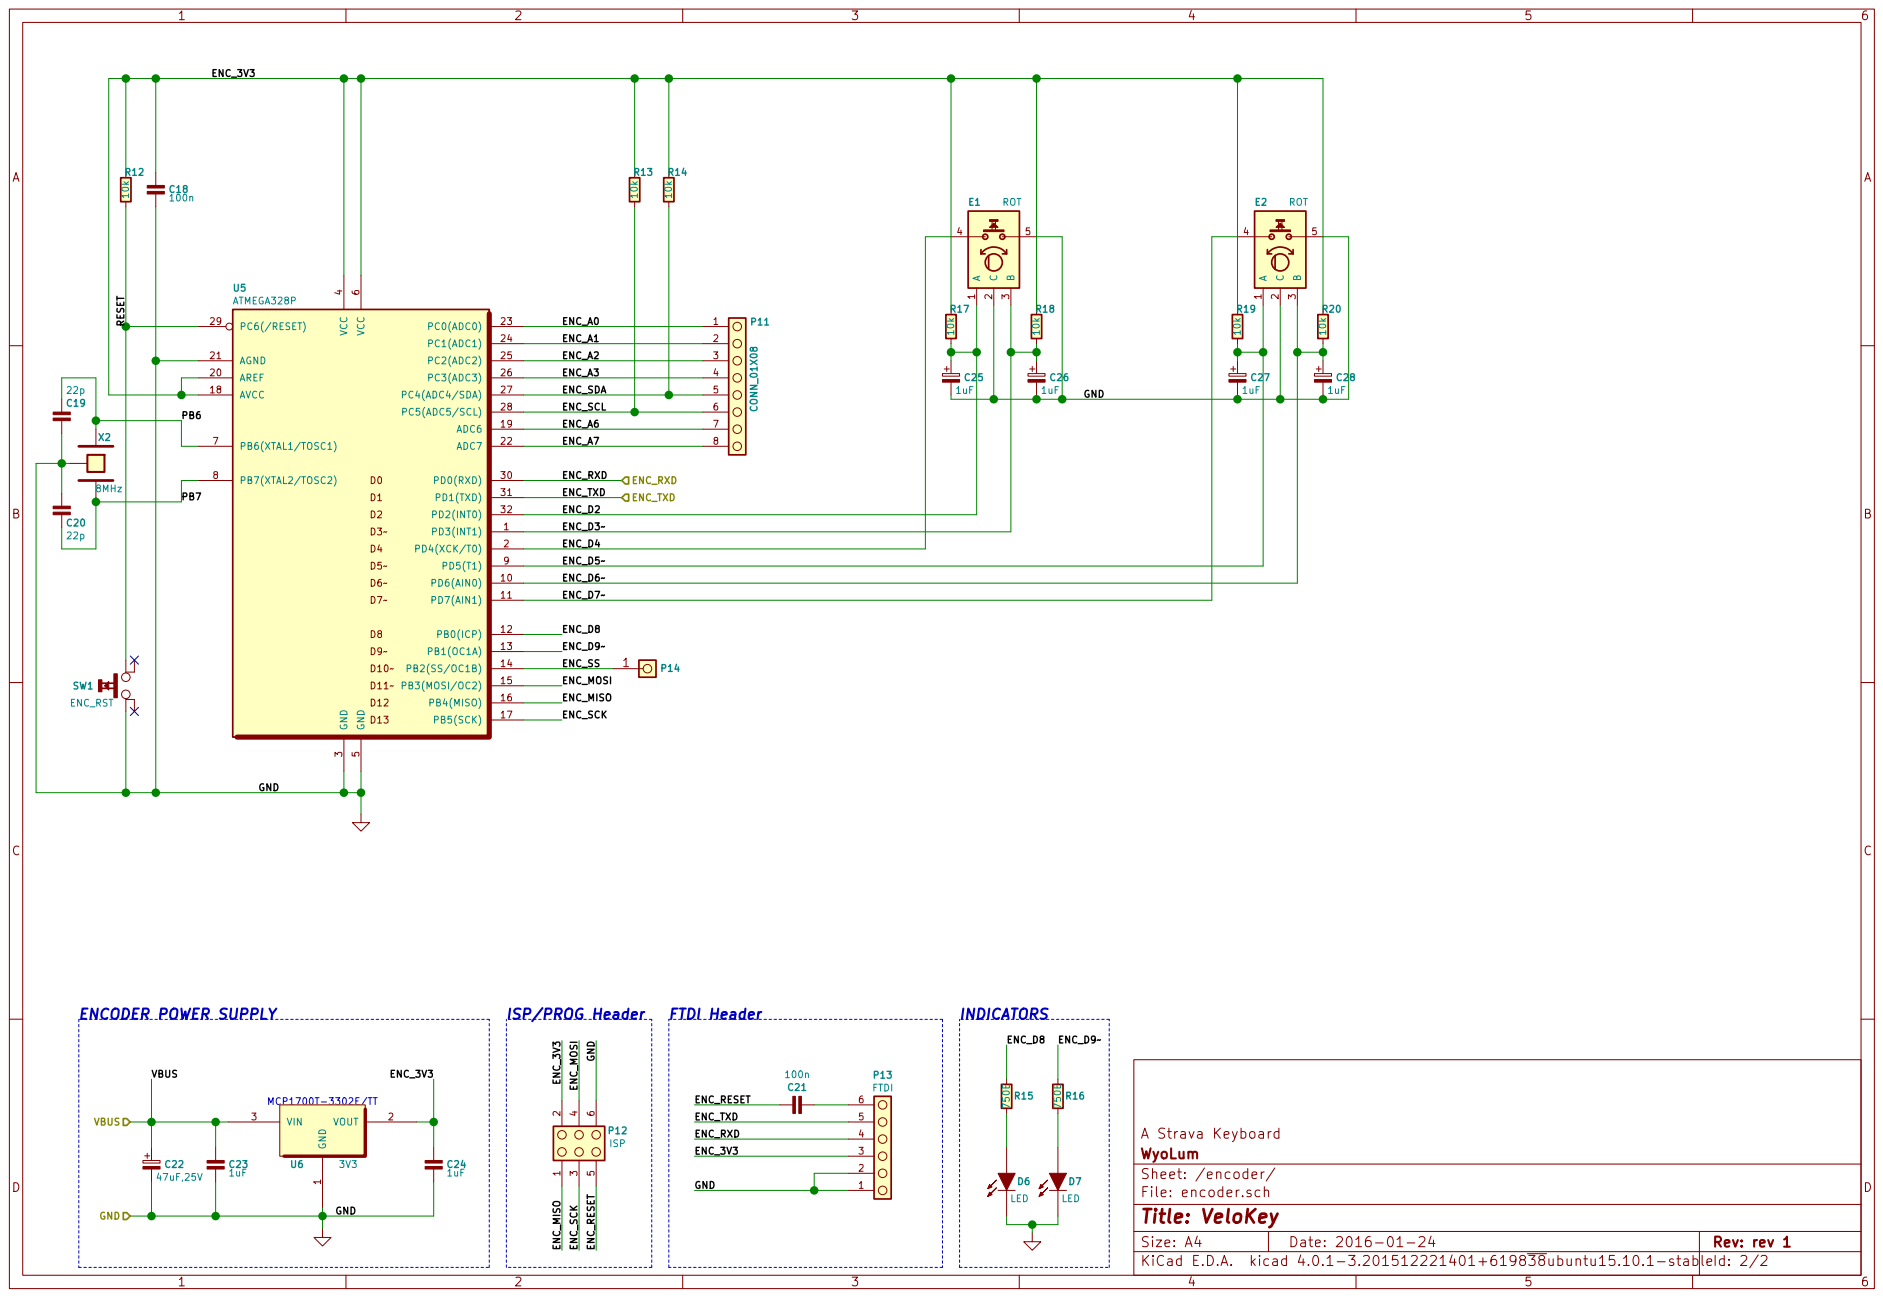
[picture p97: page 2]

6 PB6(XTAL1/TOSC1) 7 PB7(XTAL2/TOSC2) 8 PD5(T1) 9 PD6(AIN0) 10 AREF 20 PD0(RXD) 30 PD7(AIN1) 11 AGND 21 PD1(TXD) 31 PB0(ICP) 12 ADC7 22 PD2(INT0) 32 PB1(OC1A) 13 PC0(ADC0) 23 PB2(SS/OC1B) 14 PC1(ADC1) 24 PB3(MOSI/OC2) 15 PC2(ADC2) 25 PB4(MISO) 16 PC3(ADC3) 26 PB5(SCK) 17 PC4(ADC4/SDA) 27 AVCC 18 PC5(ADC5/SCL) 28 ADC6 19 PC6(/RESET) 29 U5 ATMEGA328P

File: encoder.sch Sheet: /encoder/ WyoLum
