wyolum/VeloKey/kicad/OTS_2/pdf/OTS2-B.Cu.pdf

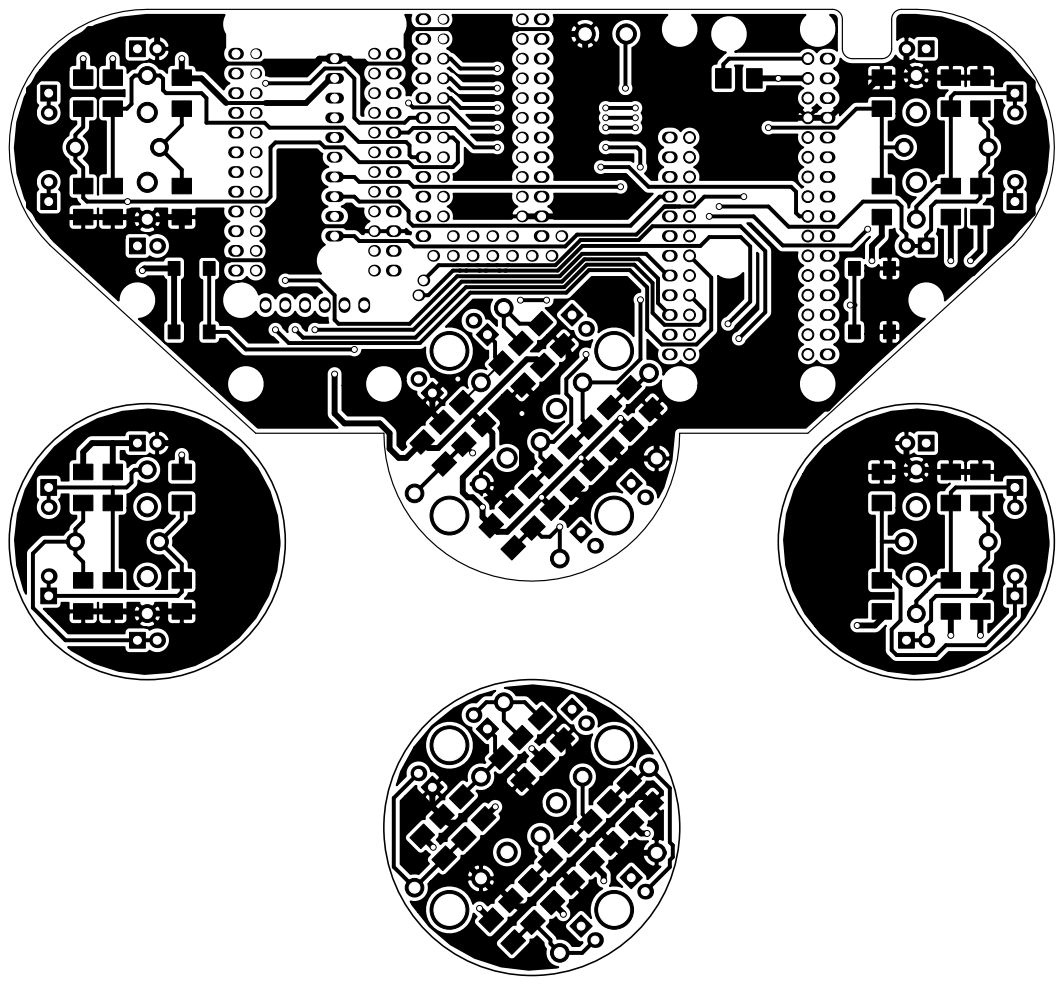
[picture p98: page 1]
