wyolum/VeloKey/kicad/OTS_2/pdf/OTS2-B.SilkS.pdf

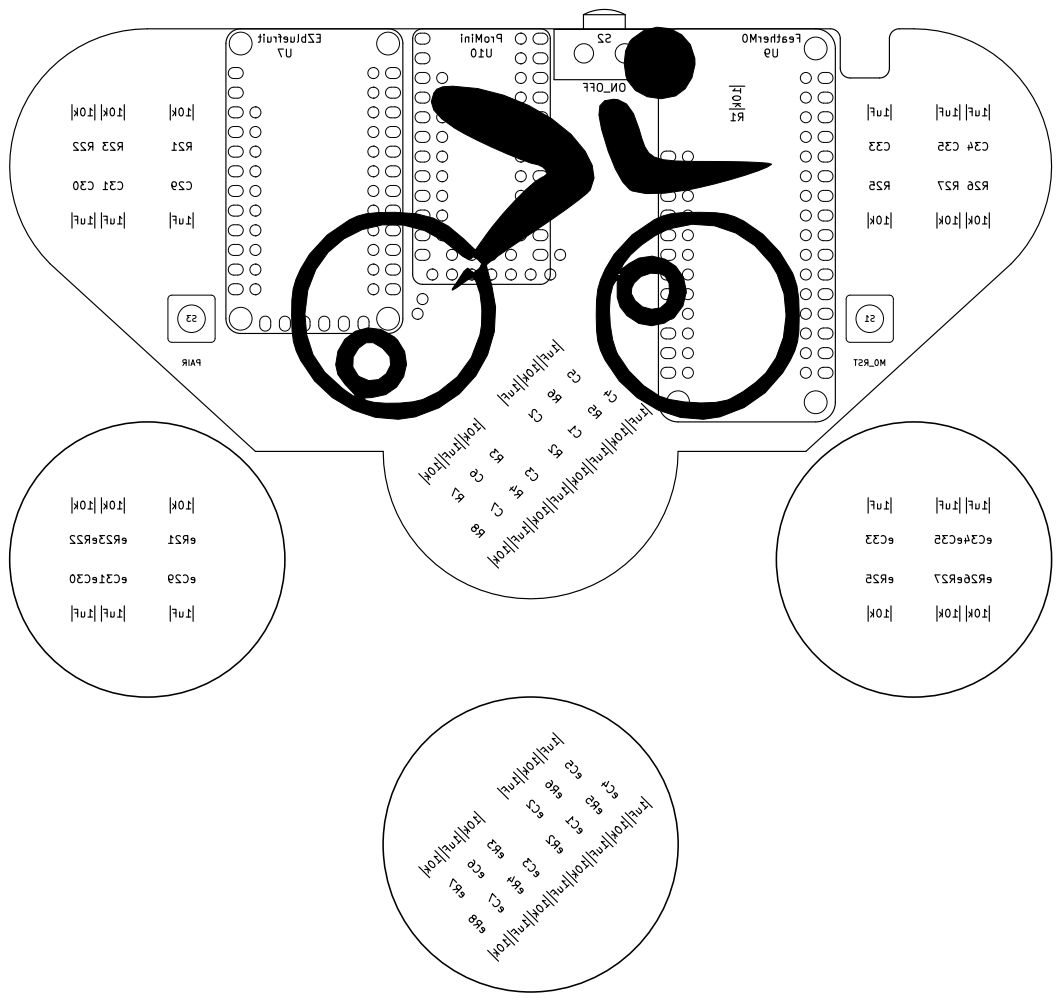
[picture p99: page 1]
