wyolum/VeloKey/kicad/OTS_2/pdf/OTS2-Dwgs.User.pdf

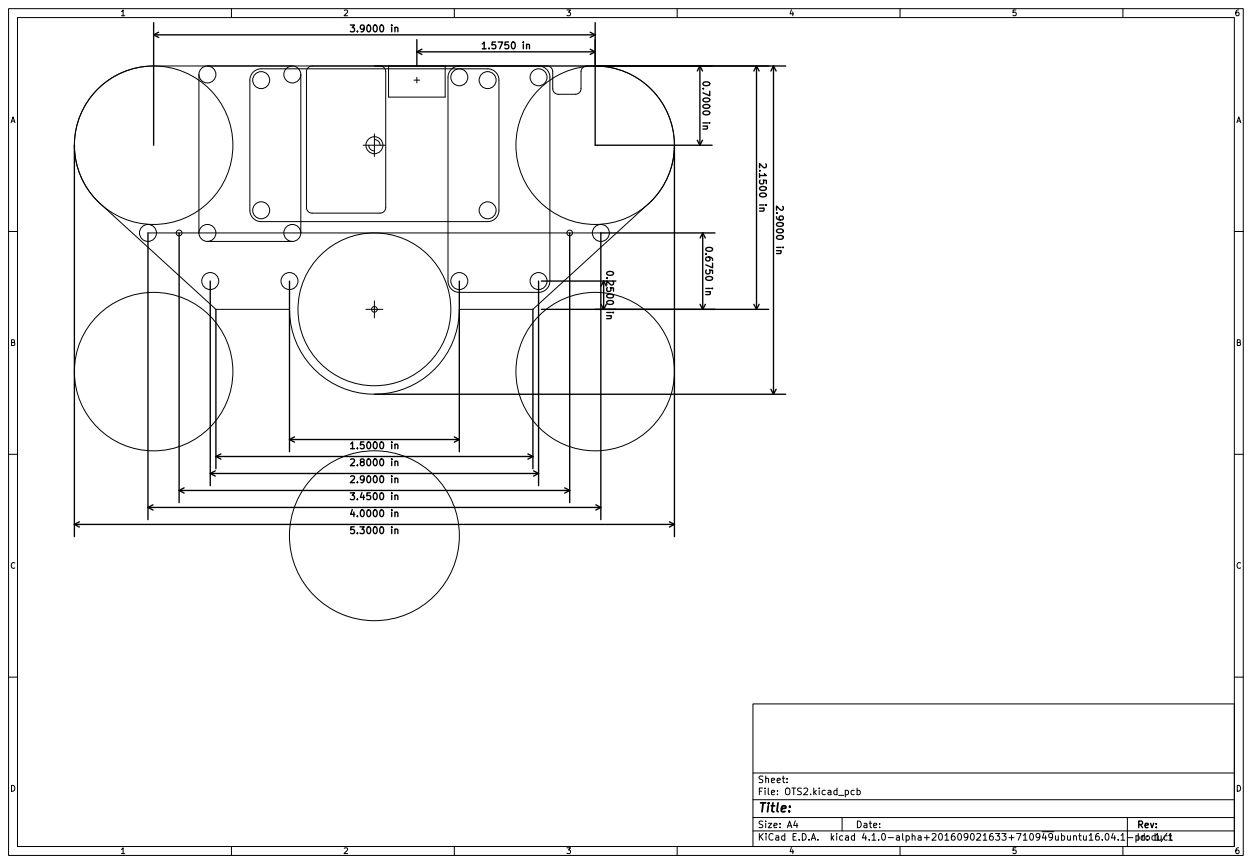
[picture p100: page 1]
