wyolum/VeloKey/kicad/OTS_2/pdf/OTS2-F.Cu.pdf

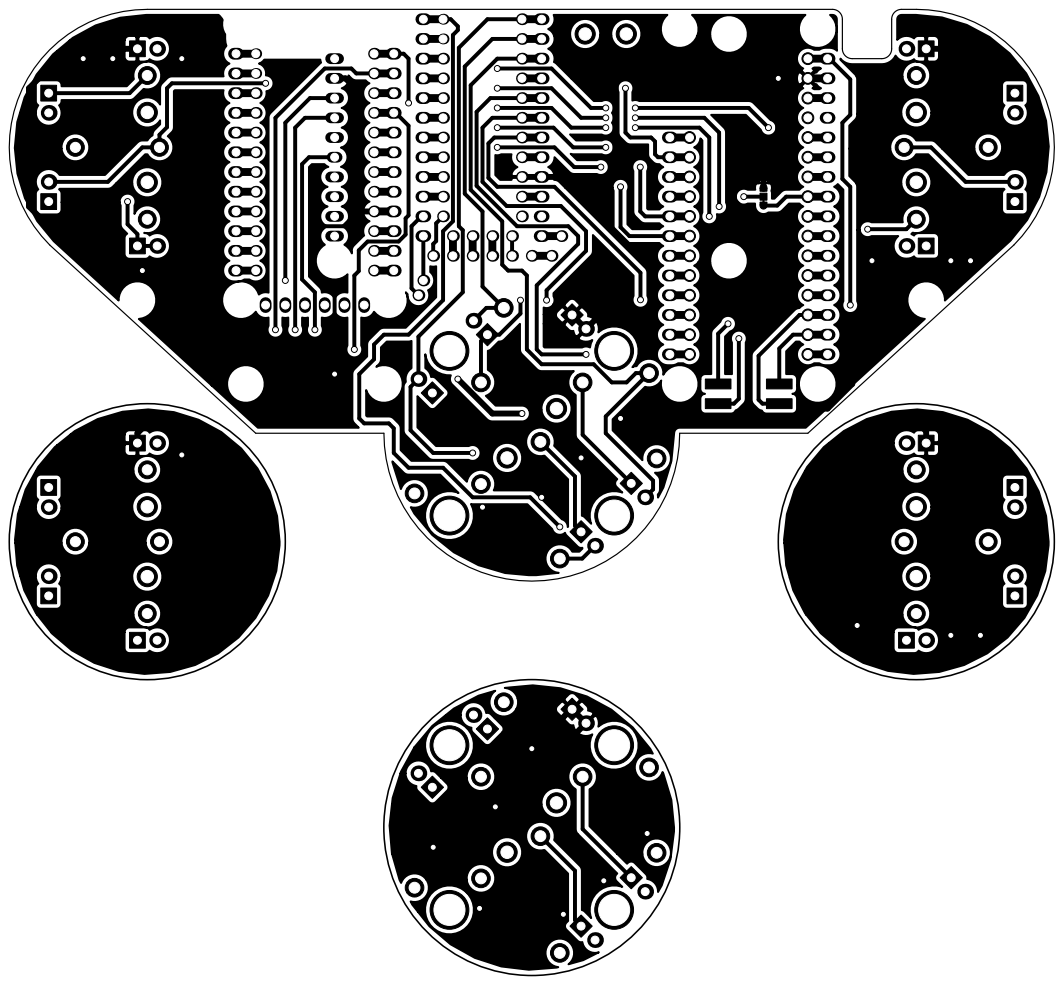
[picture p101: page 1]
