wyolum/VeloKey/kicad/OTS_2/pdf/OTS2-F.SilkS.pdf

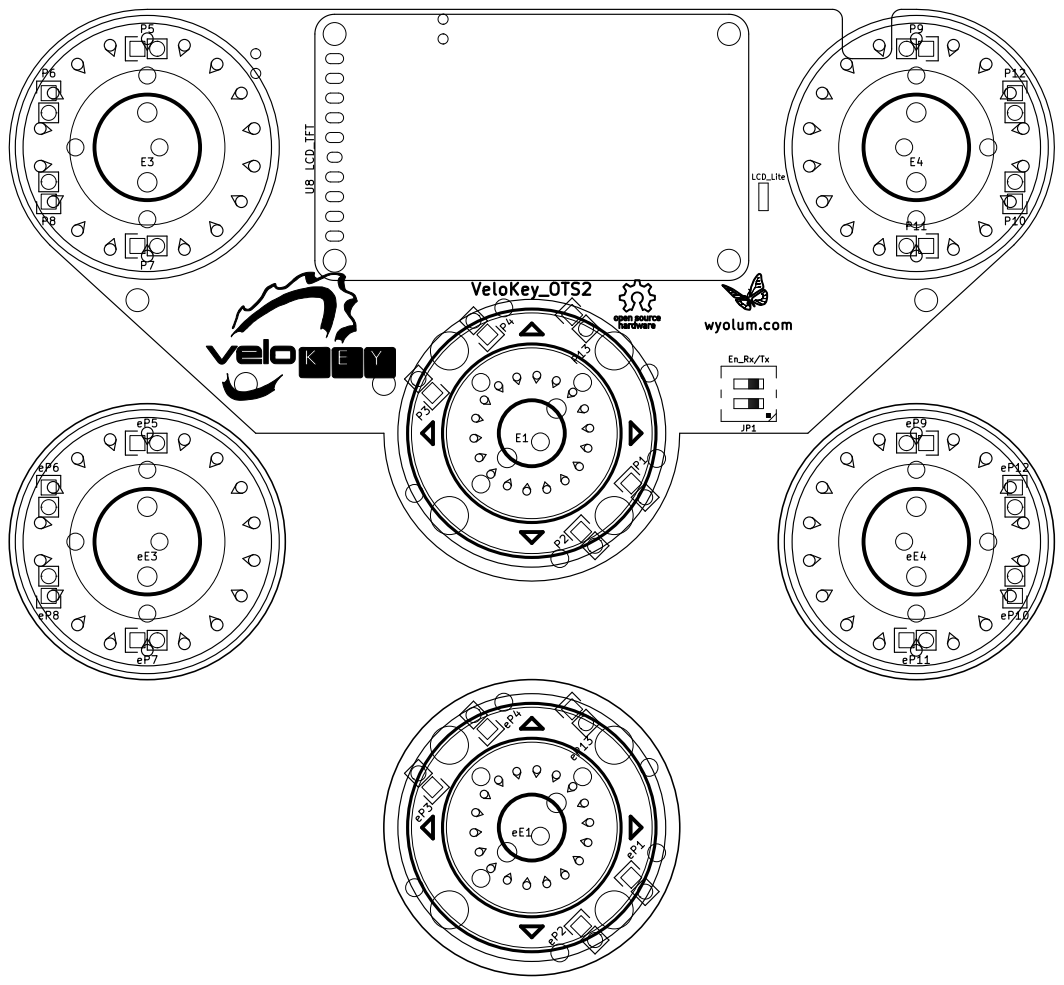
[picture p102: page 1]
