wyolum/VeloKey/kicad/OTS_1/pdf/OTS-B.Cu.pdf

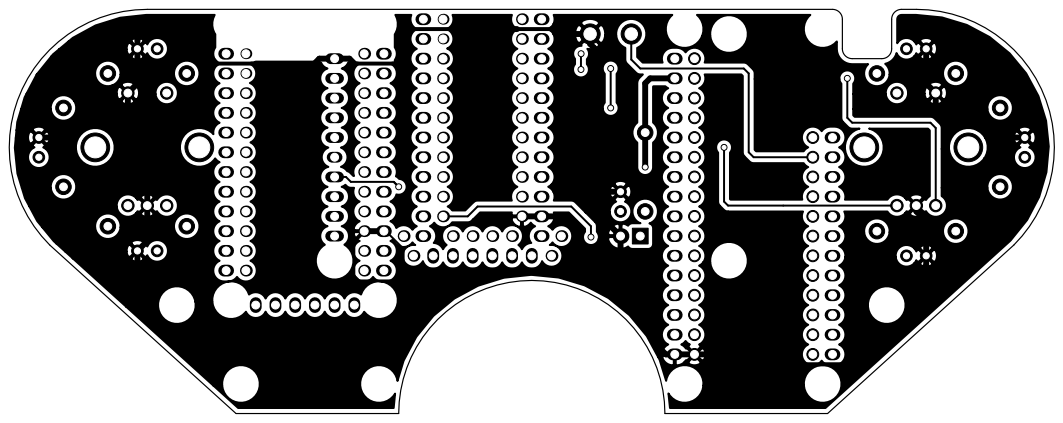
[picture p103: page 1]
