wyolum/VeloKey/kicad/OTS_1/pdf/OTS-B.SilkS.pdf

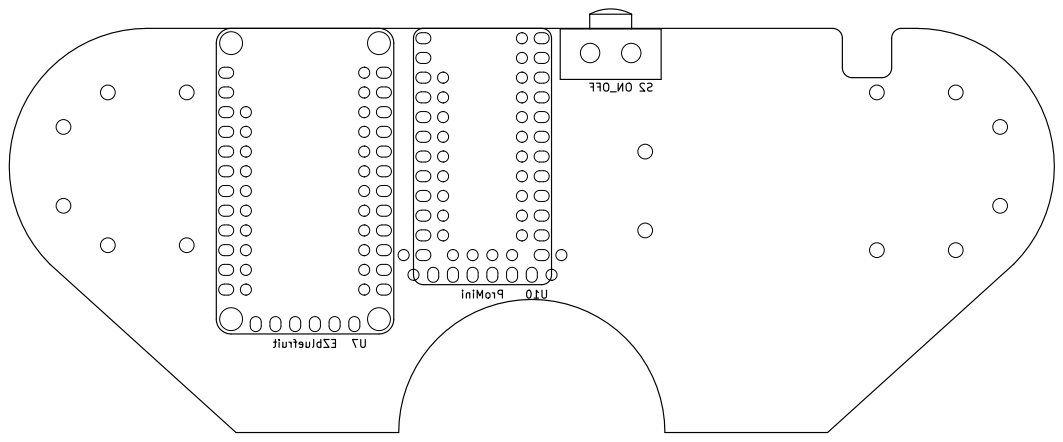
[picture p104: page 1]
