wyolum/VeloKey/kicad/OTS_1/pdf/OTS-F.Cu.pdf

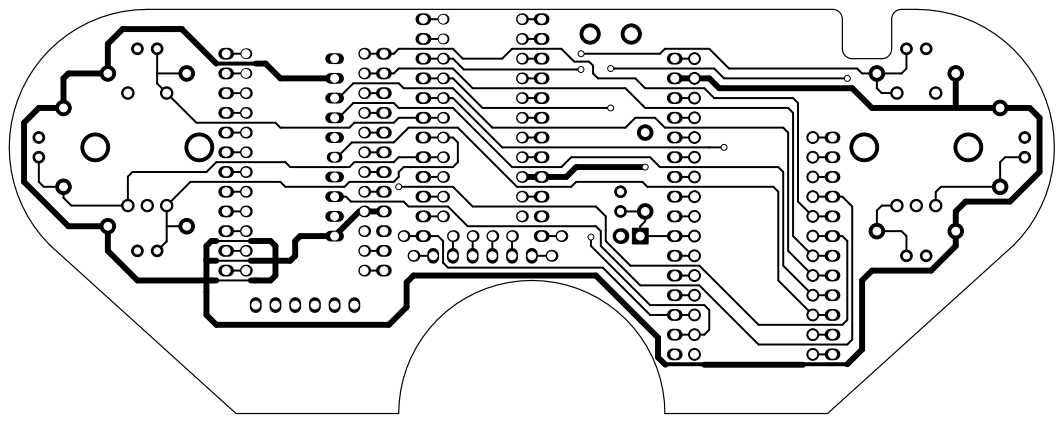
[picture p105: page 1]
