wyolum/VeloKey/kicad/OTS_1/pdf/OTS-F.SilkS.pdf

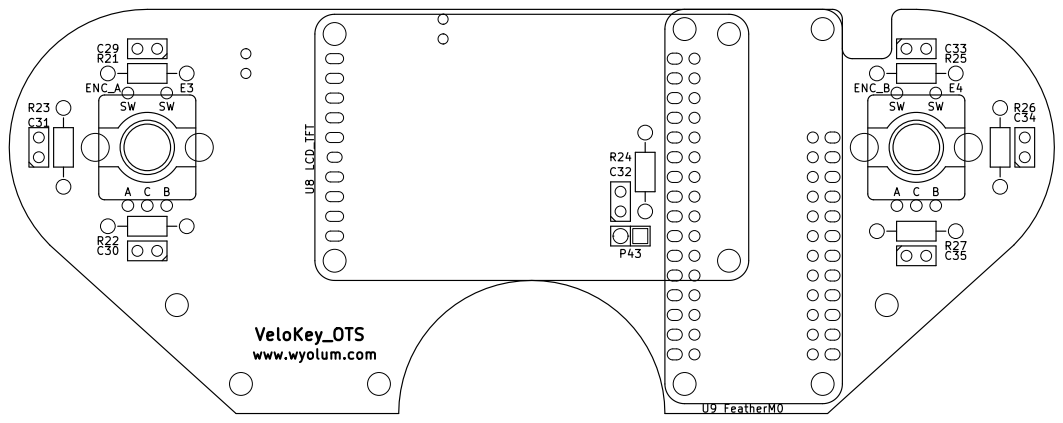
[picture p106: page 1]
