wyolum/VeloKey/kicad/data/Feather-M0/Feather_M0.pdf

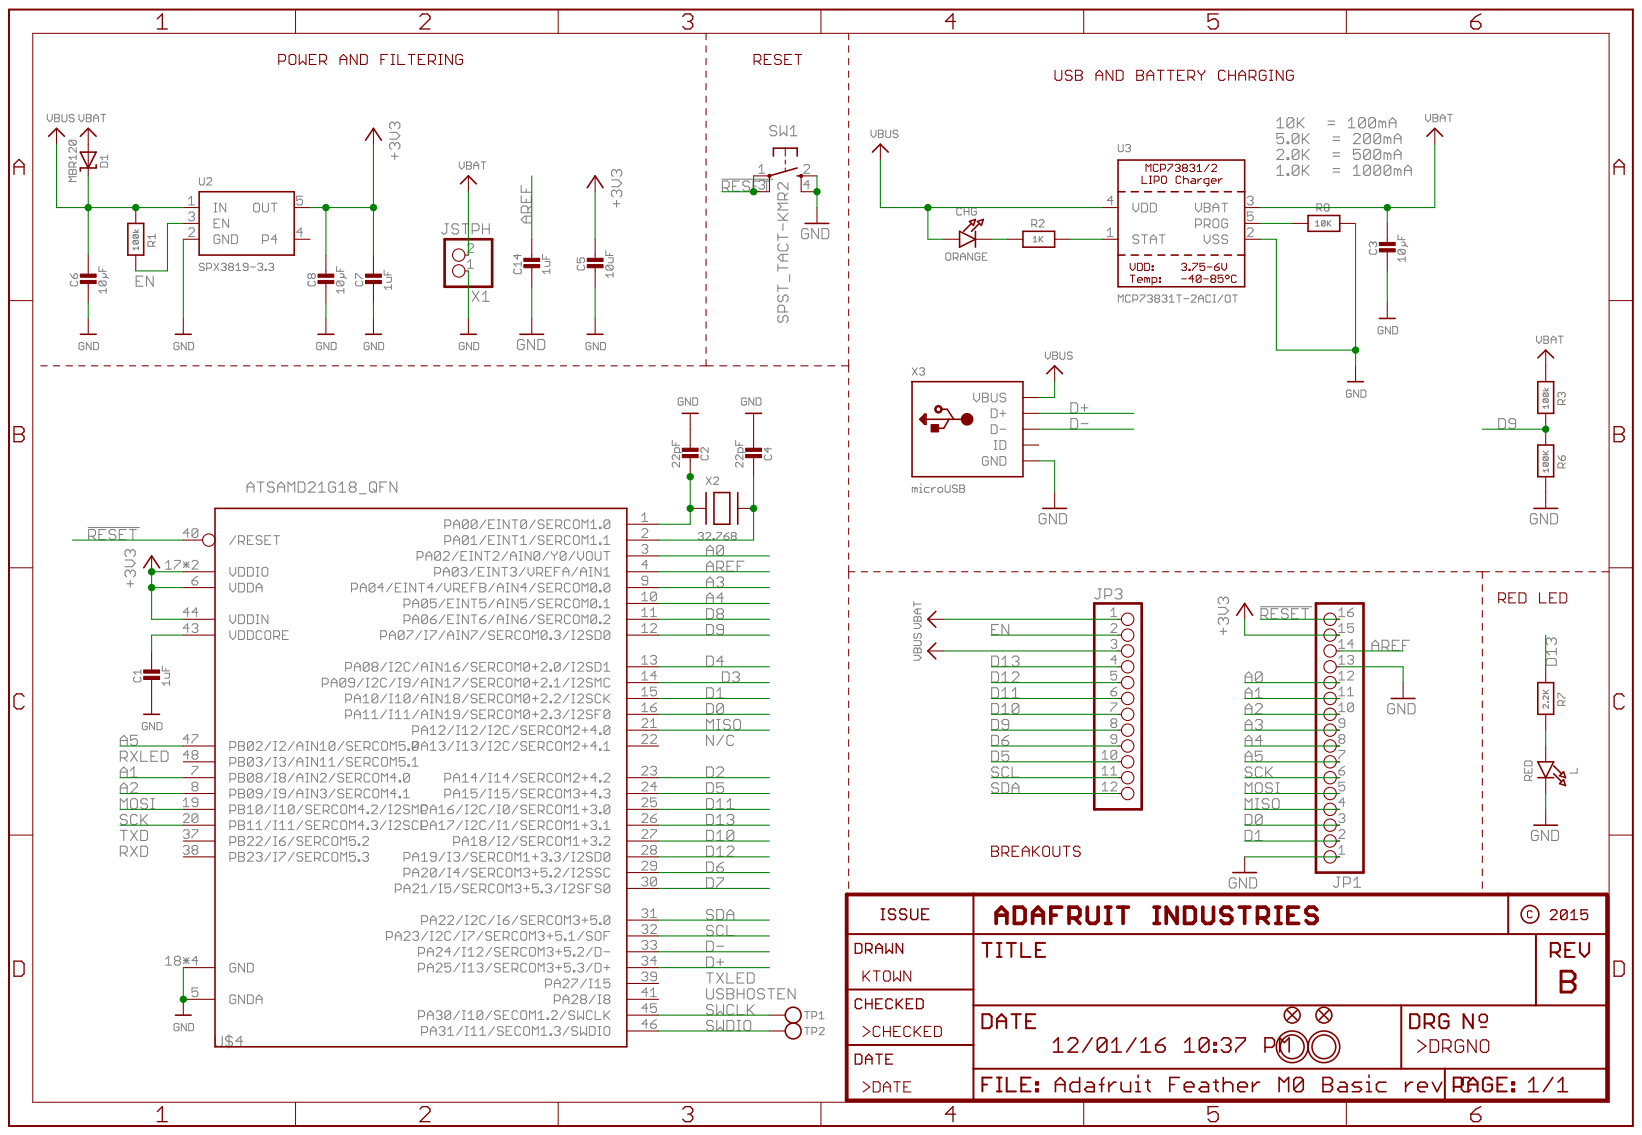
[picture p107: page 1]
