wyolum/VeloKey/kicad/OTS_2/pdf/encA/OTS2_encA-B.Cu.pdf

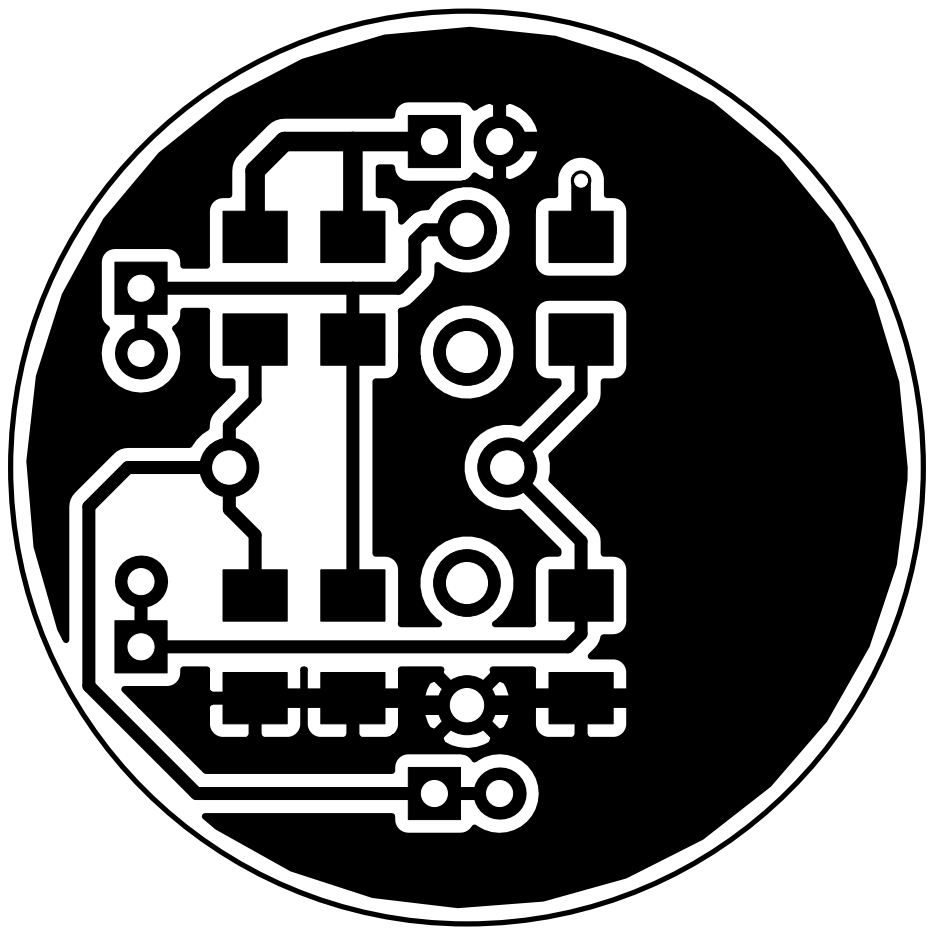
[picture p108: page 1]
