wyolum/VeloKey/kicad/OTS_2/pdf/encA/OTS2_encA-B.SilkS.pdf

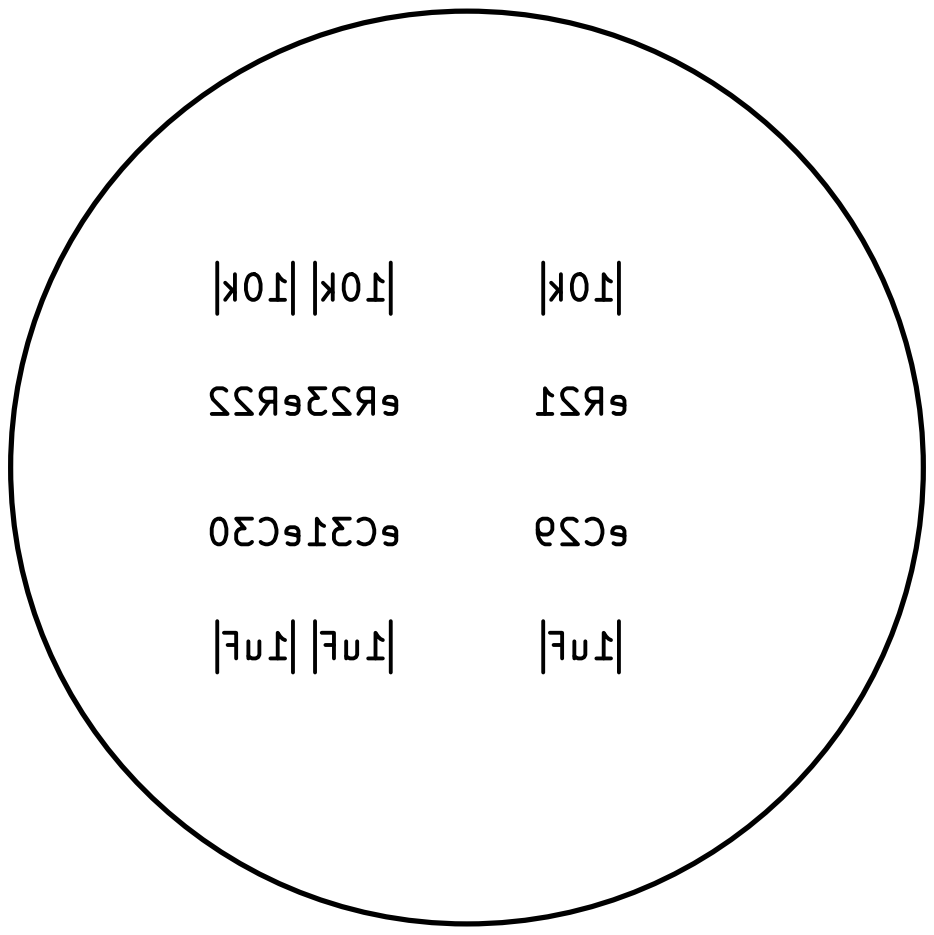
[picture p109: page 1]
