wyolum/VeloKey/kicad/OTS_2/pdf/encA/OTS2_encA-Dwgs.User.pdf

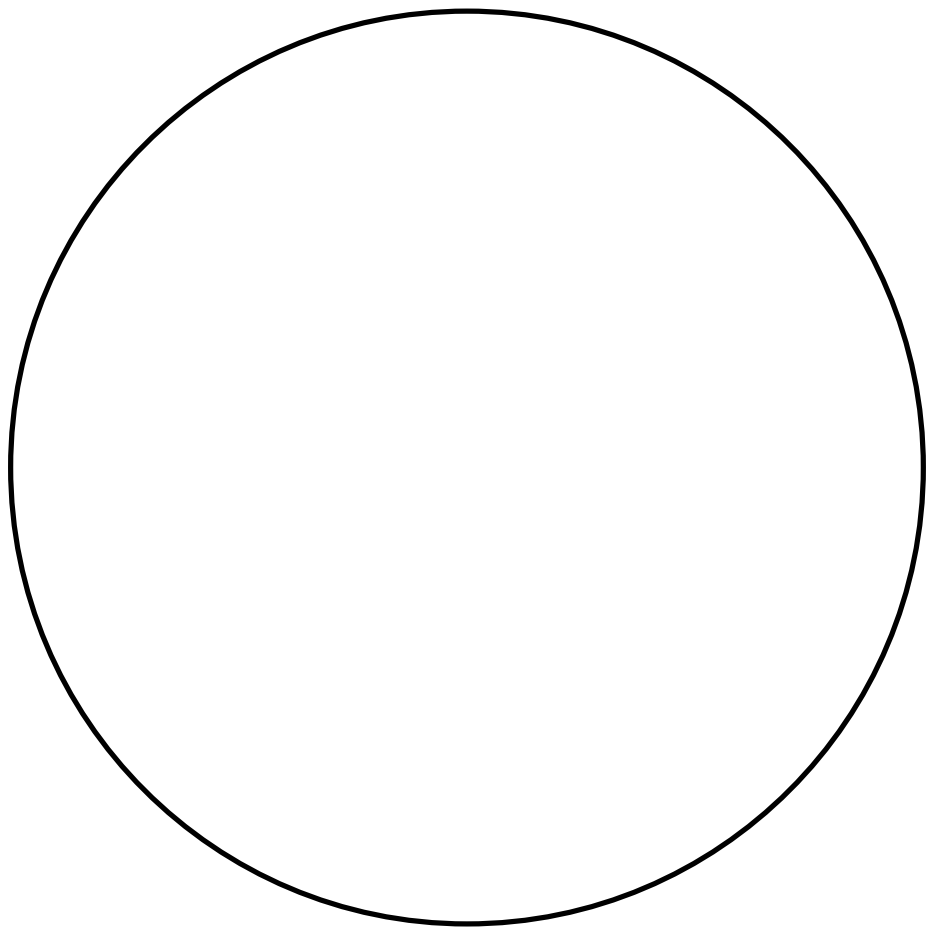
[picture p110: page 1]
