wyolum/VeloKey/kicad/OTS_2/pdf/encA/OTS2_encA-F.Cu.pdf

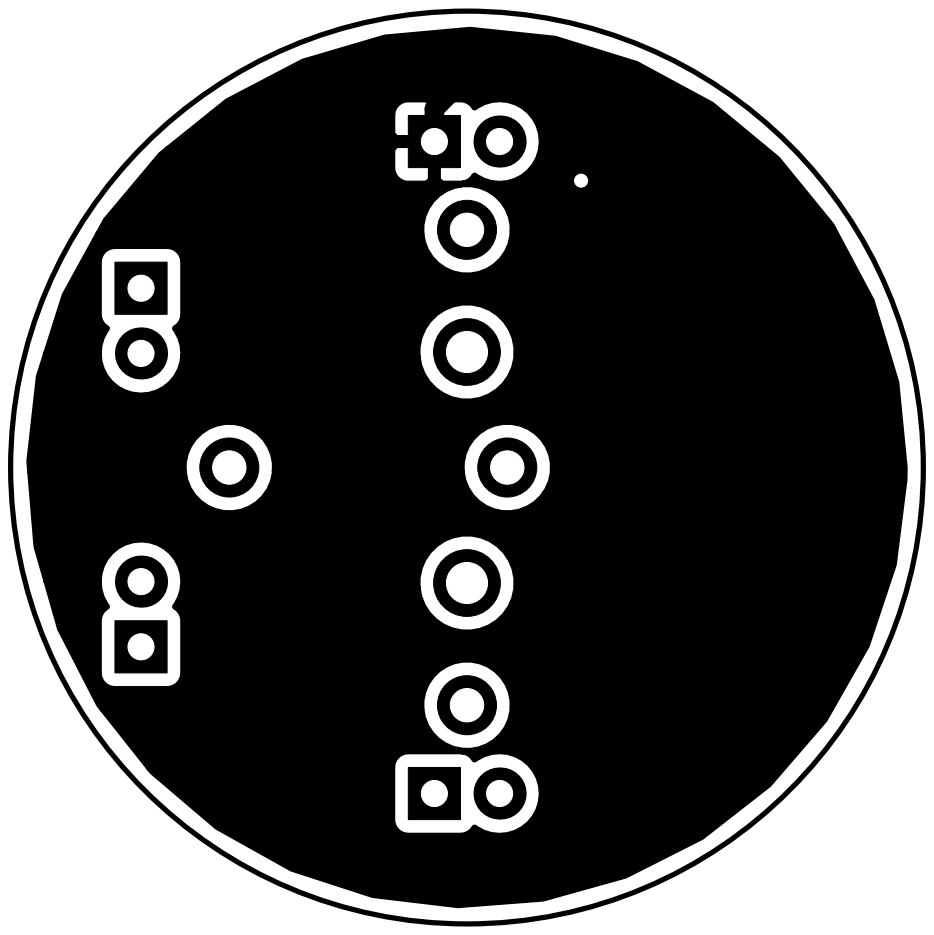
[picture p111: page 1]
