wyolum/VeloKey/kicad/OTS_2/pdf/encA/OTS2_encA-F.SilkS.pdf

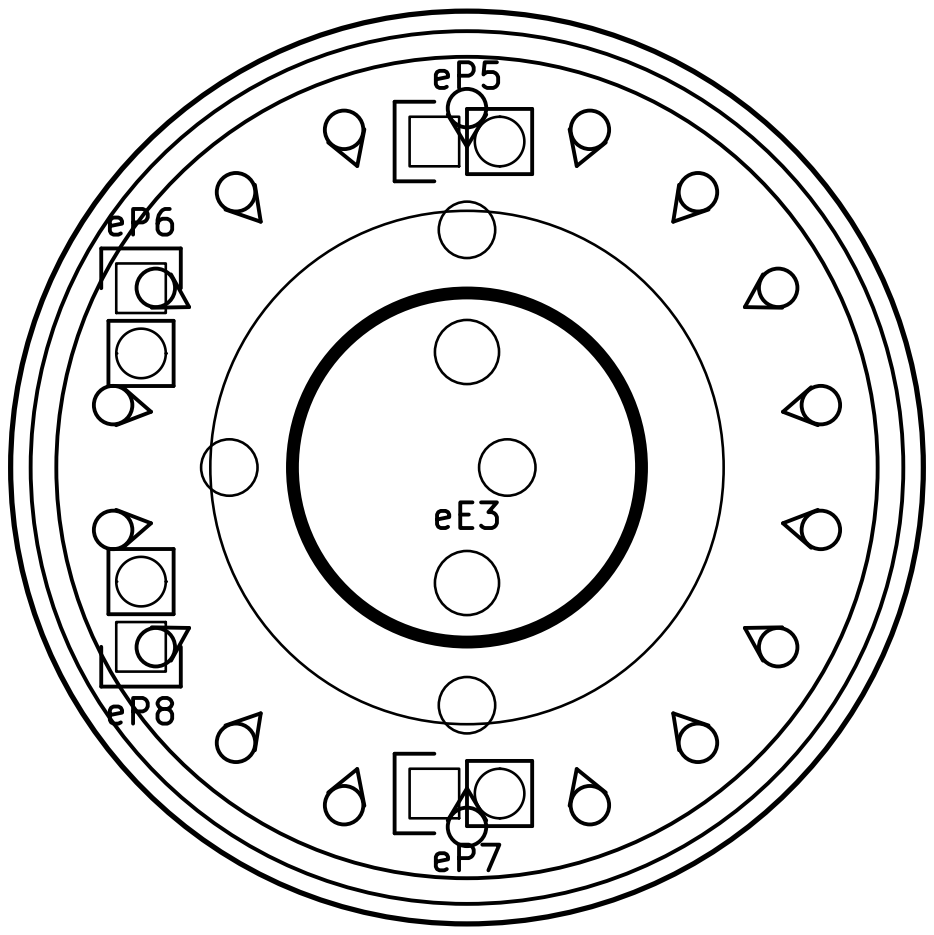
[picture p112: page 1]
