wyolum/VeloKey/kicad/OTS_2/pdf/encB/OTS2_encB-B.Cu.pdf

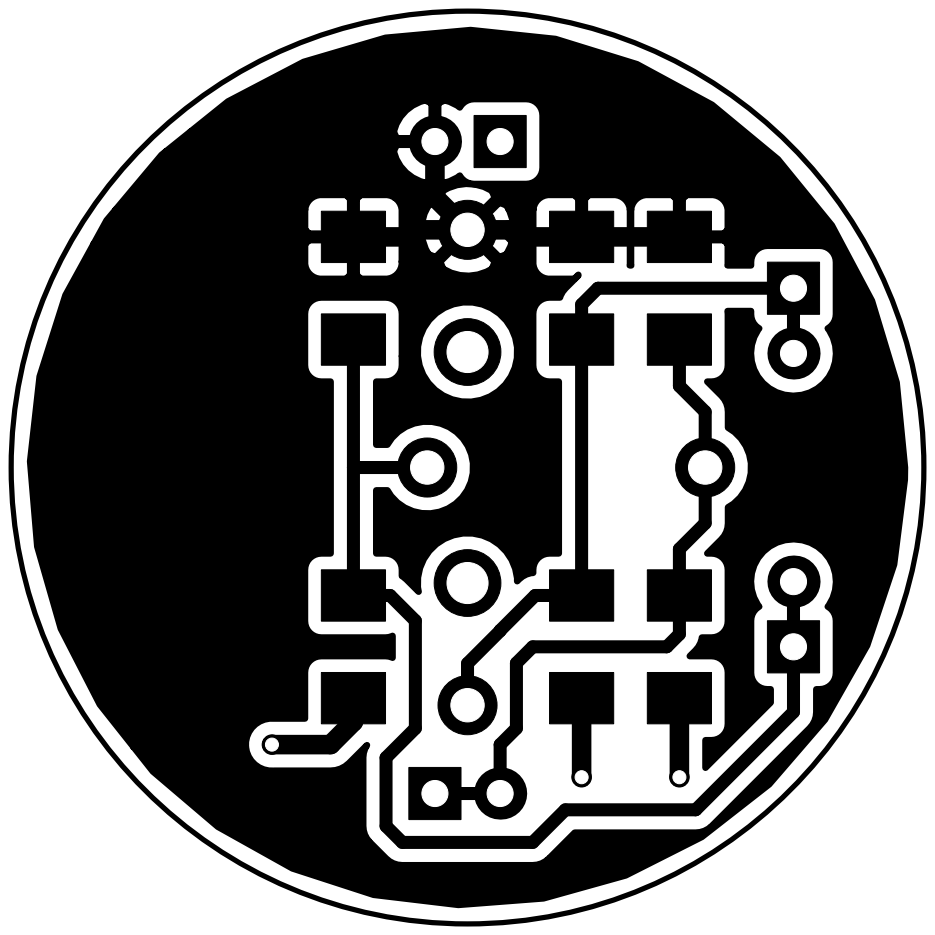
[picture p113: page 1]
