wyolum/VeloKey/kicad/OTS_2/pdf/encB/OTS2_encB-B.SilkS.pdf

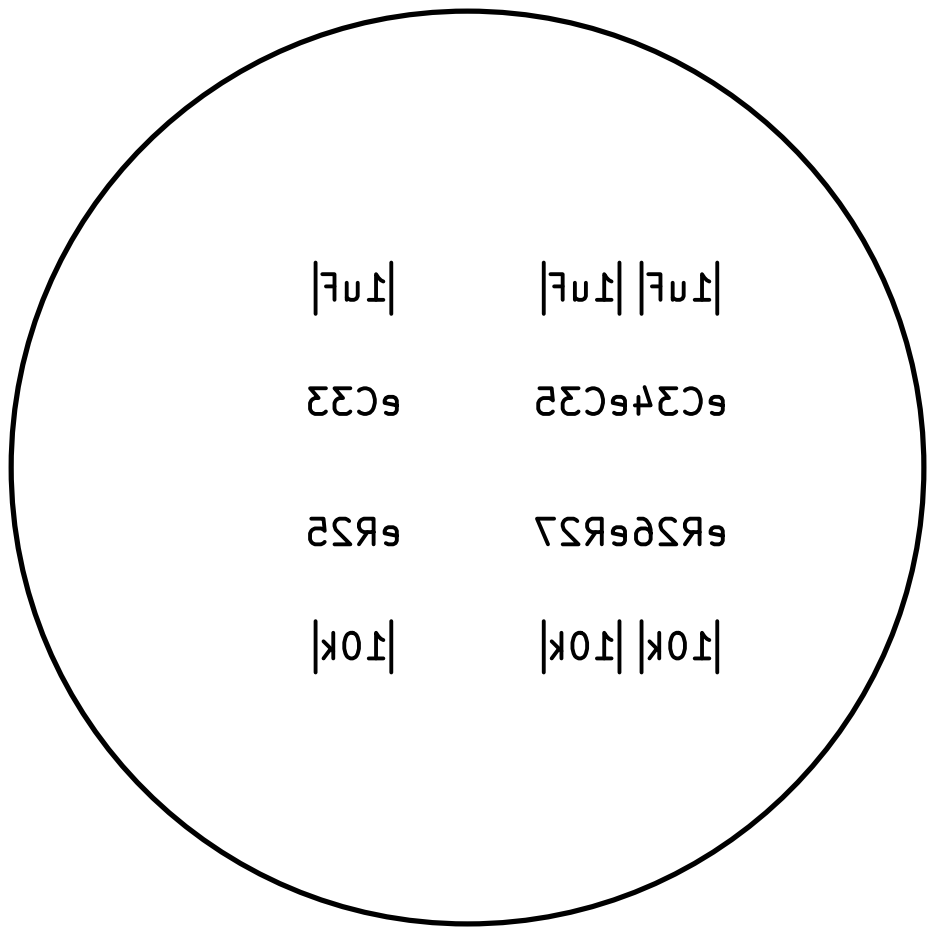
[picture p114: page 1]
