wyolum/VeloKey/kicad/OTS_2/pdf/encB/OTS2_encB-Dwgs.User.pdf

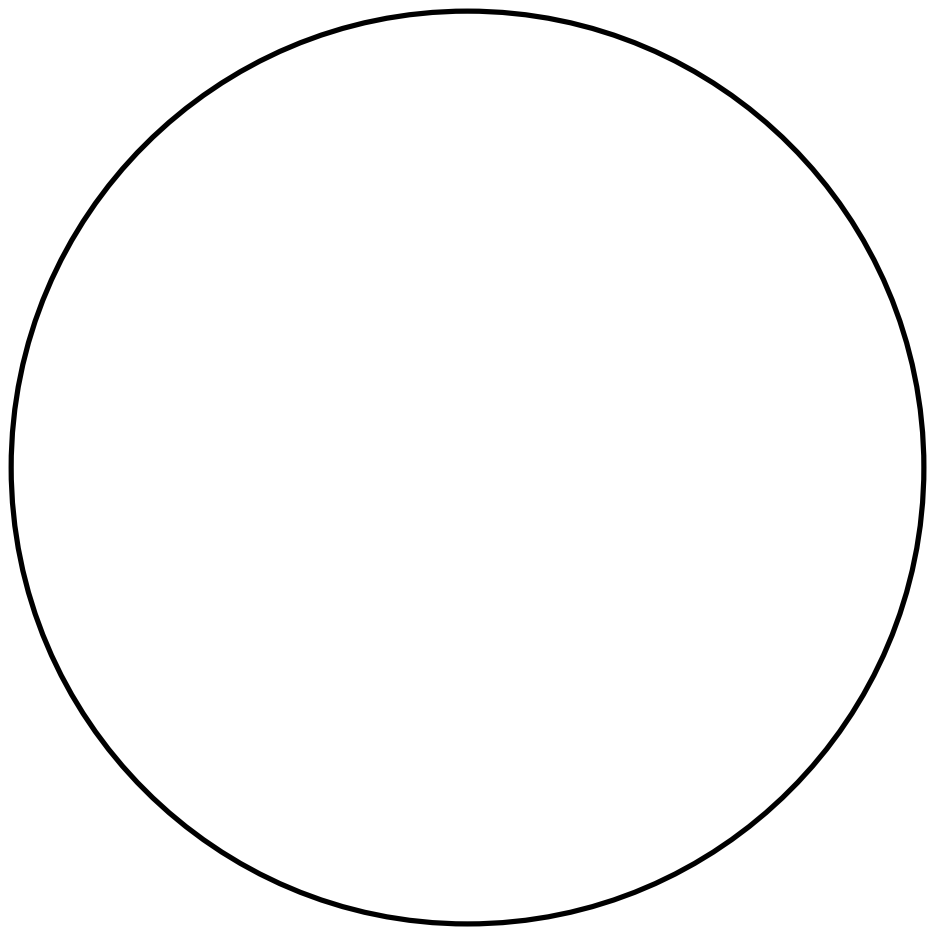
[picture p115: page 1]
