wyolum/VeloKey/kicad/OTS_2/pdf/encB/OTS2_encB-F.Cu.pdf

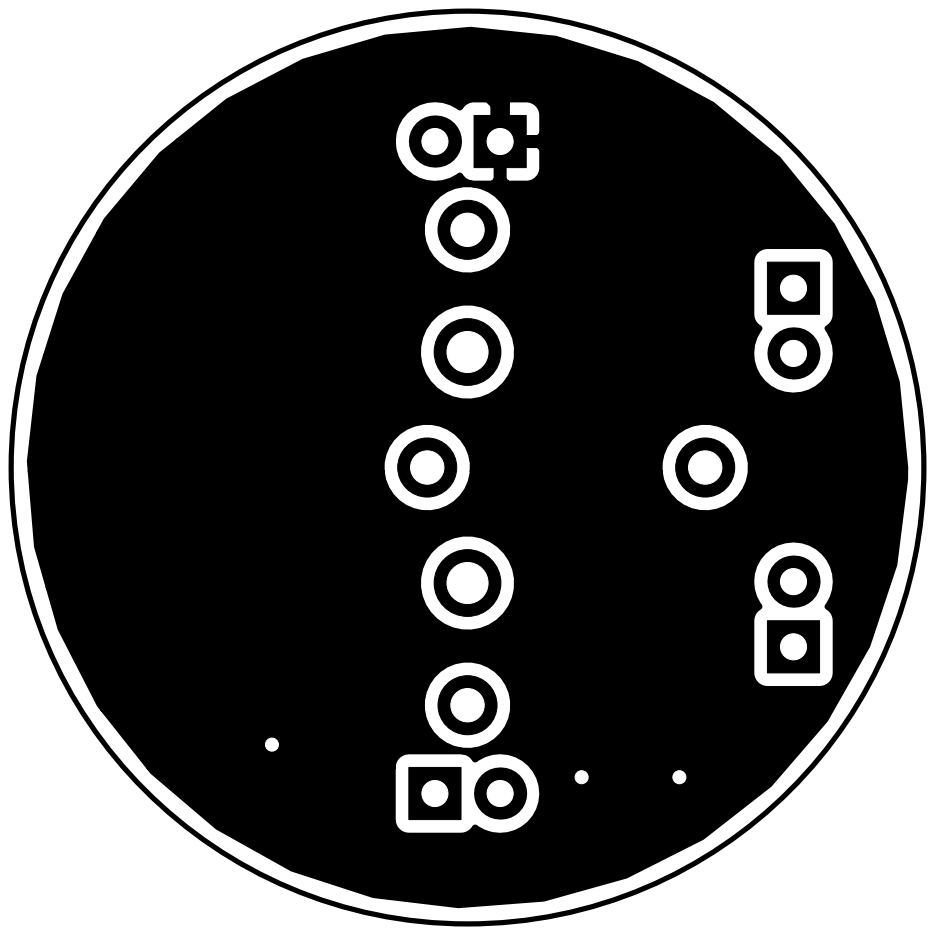
[picture p116: page 1]
