wyolum/VeloKey/kicad/OTS_2/pdf/encB/OTS2_encB-F.SilkS.pdf

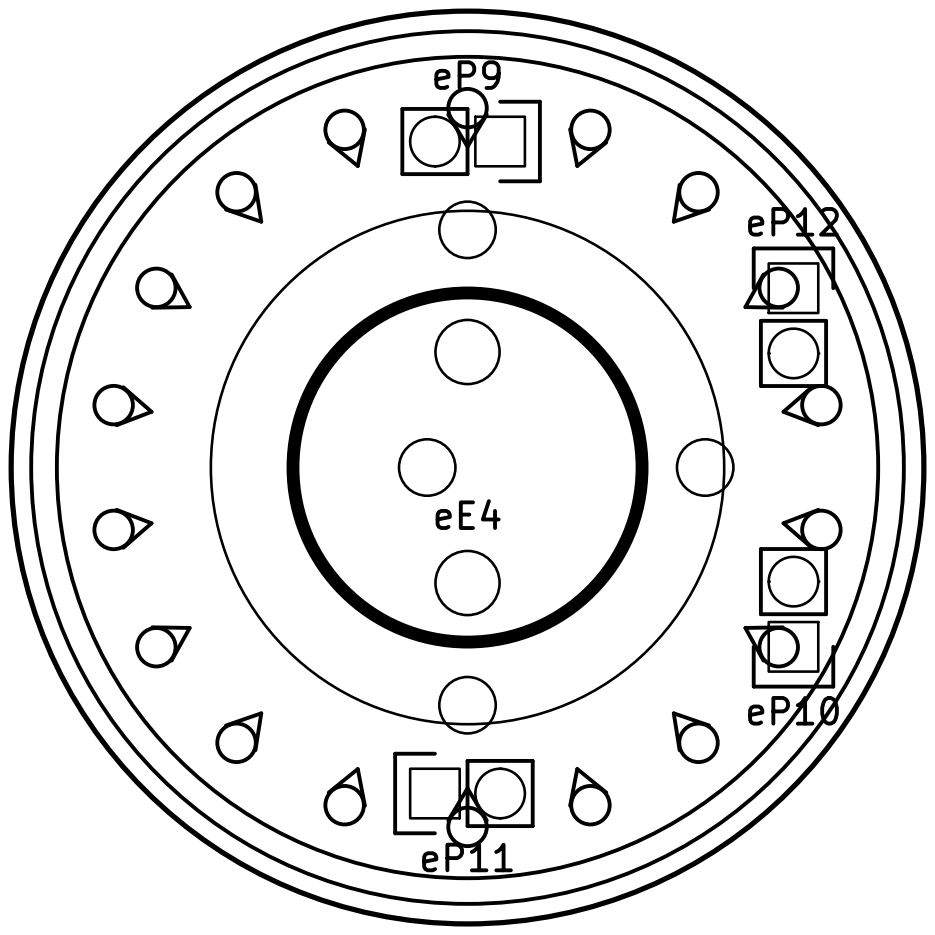
[picture p117: page 1]
