wyolum/VeloKey/kicad/OTS_2/pdf/encC/OTS2_encC-B.Cu.pdf

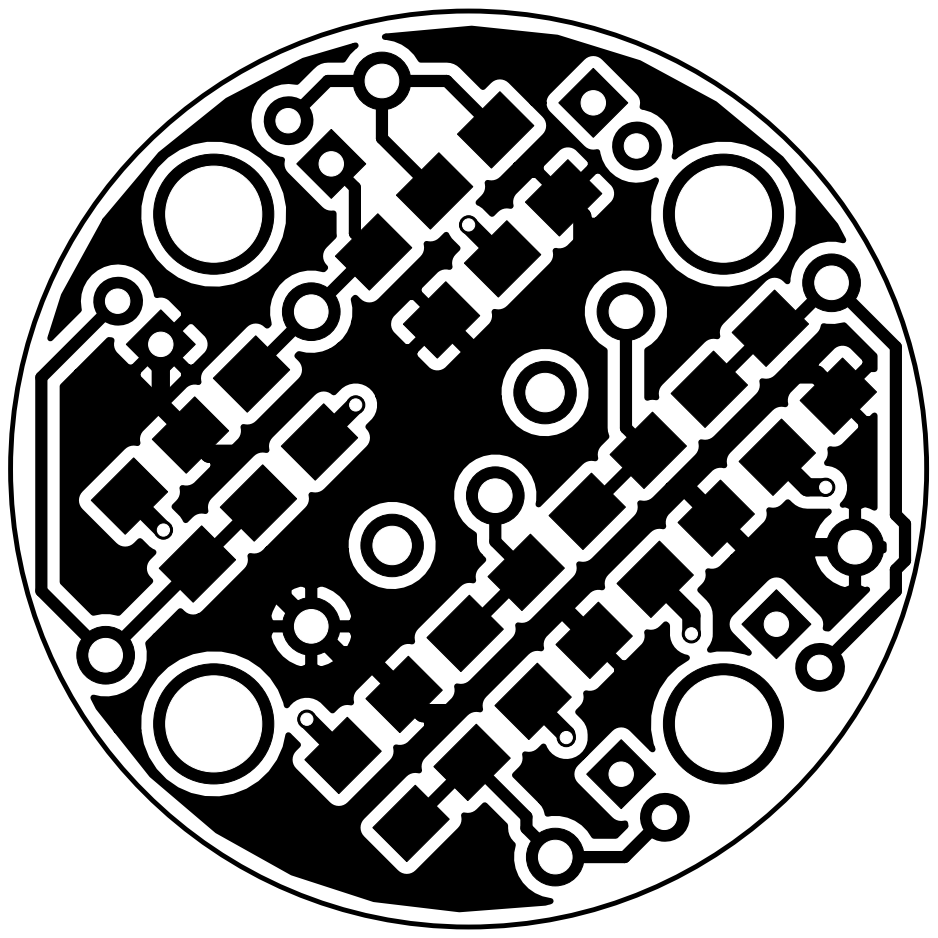
[picture p118: page 1]
