wyolum/VeloKey/kicad/OTS_2/pdf/encC/OTS2_encC-B.SilkS.pdf

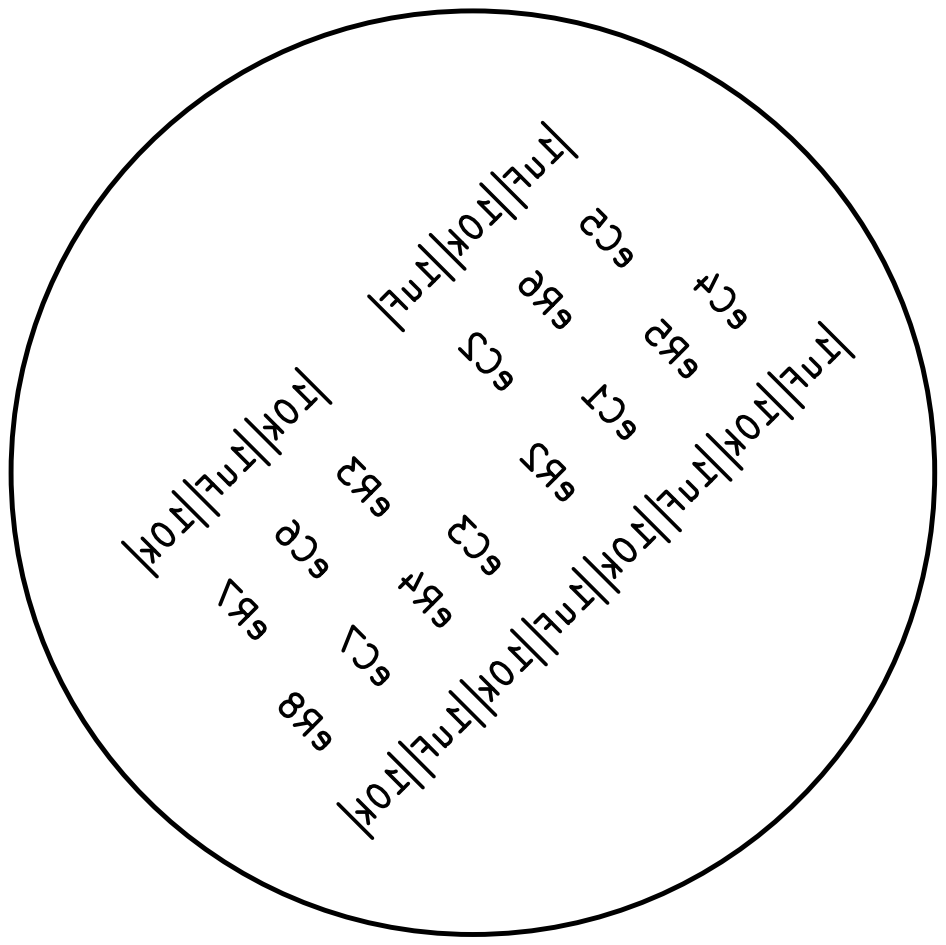
[picture p119: page 1]
