wyolum/VeloKey/kicad/OTS_2/pdf/encC/OTS2_encC-Dwgs.User.pdf

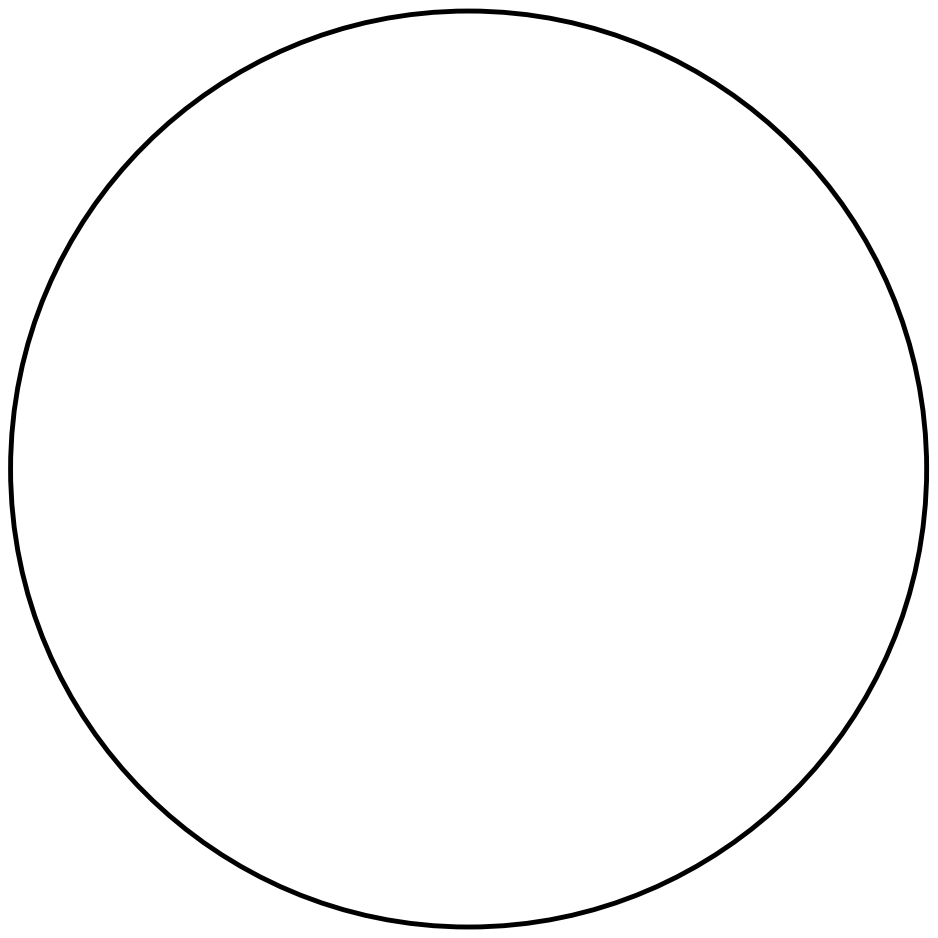
[picture p120: page 1]
