wyolum/VeloKey/kicad/OTS_2/pdf/encC/OTS2_encC-F.Cu.pdf

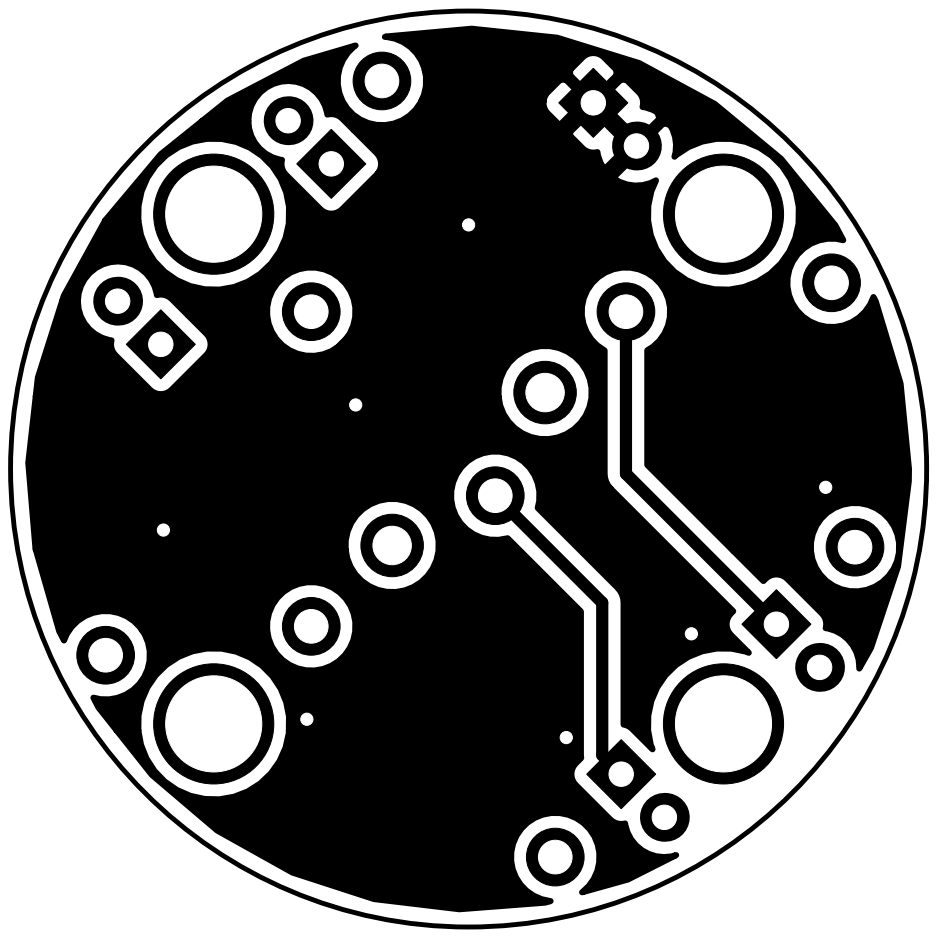
[picture p121: page 1]
