wyolum/VeloKey/kicad/OTS_2/pdf/encC/OTS2_encC-F.SilkS.pdf

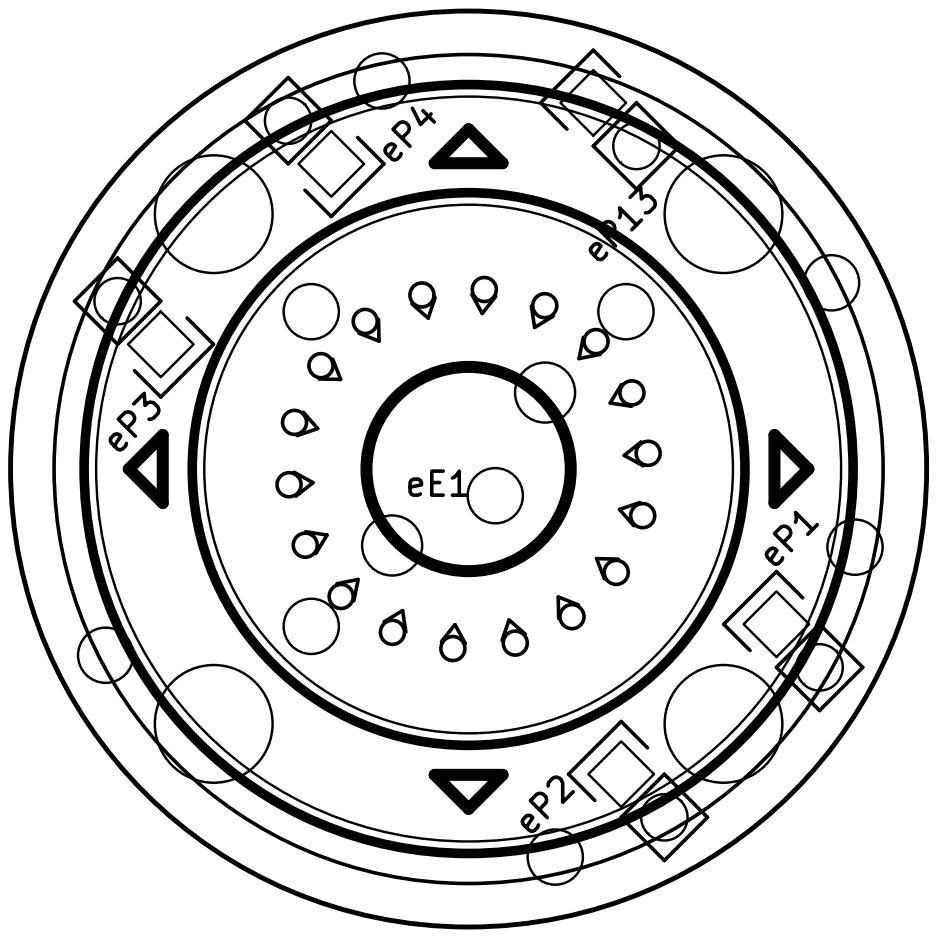
[picture p122: page 1]
