wyolum/VeloKey/kicad/OTS_2/pdf/main/OTS2_main-B.Cu.pdf

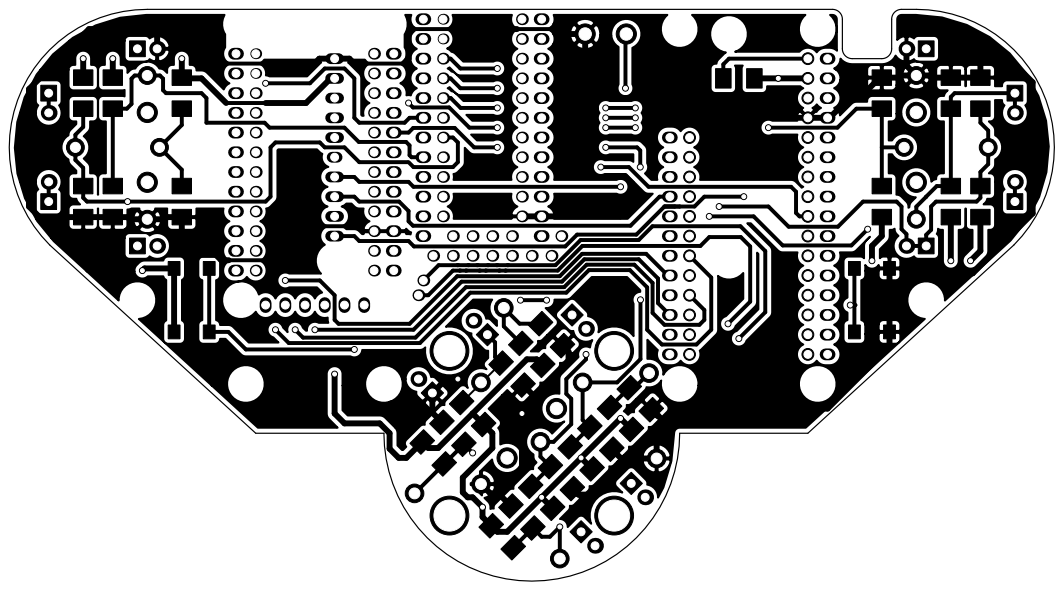
[picture p123: page 1]
