wyolum/VeloKey/kicad/OTS_2/pdf/main/OTS2_main-B.SilkS.pdf

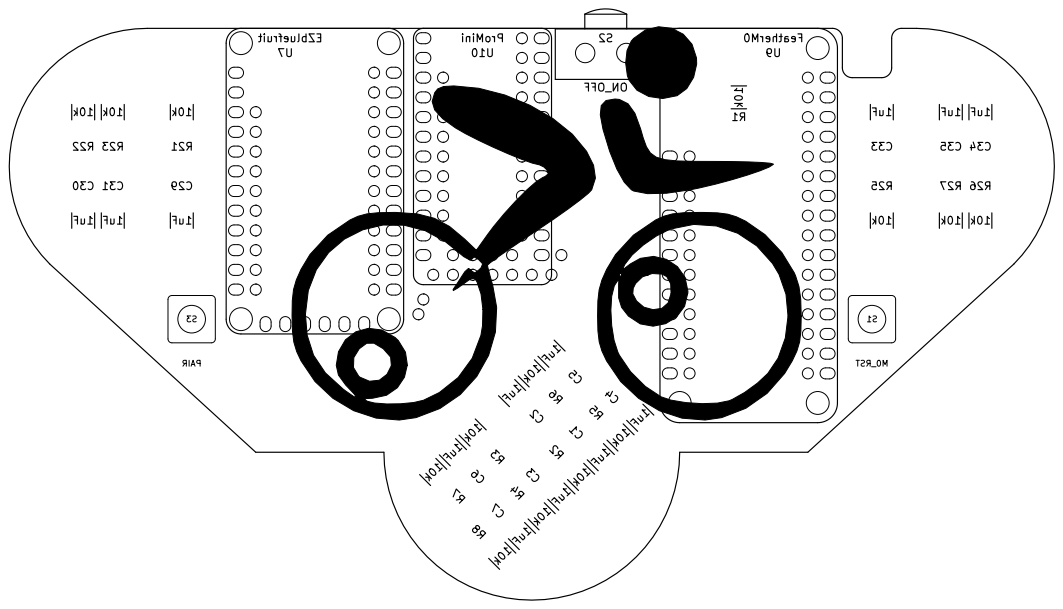
[picture p124: page 1]
