wyolum/VeloKey/kicad/OTS_2/pdf/main/OTS2_main-Dwgs.User.pdf

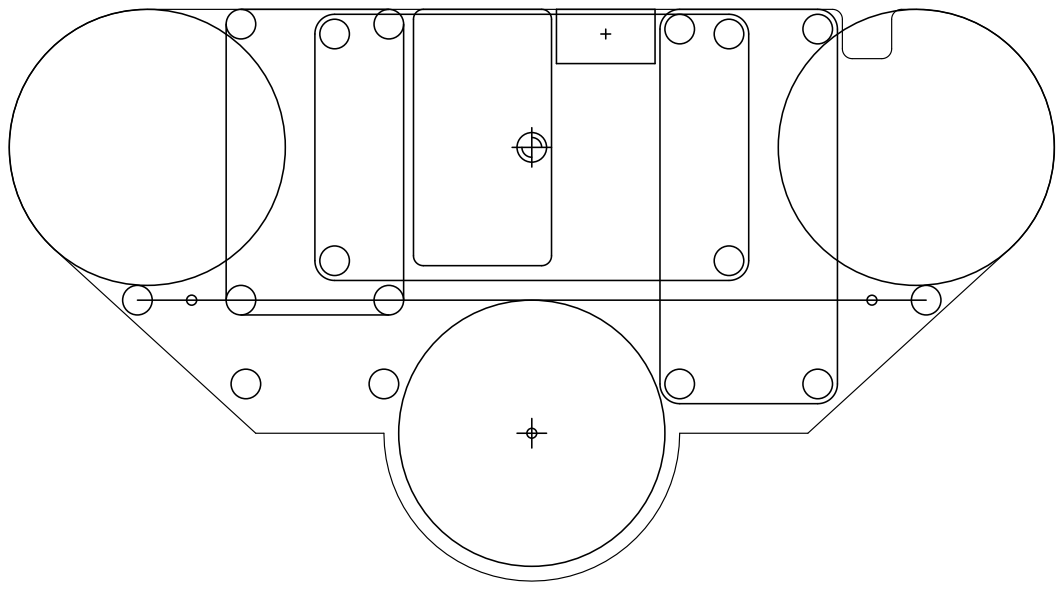
[picture p125: page 1]
