wyolum/VeloKey/kicad/OTS_2/pdf/main/OTS2_main-F.Cu.pdf

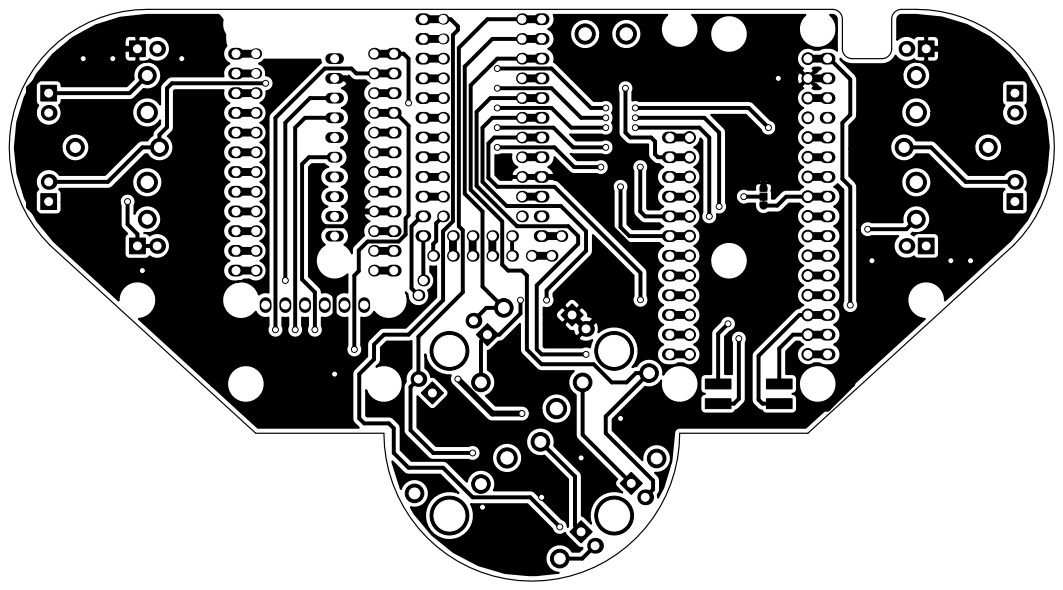
[picture p126: page 1]
