wyolum/VeloKey/kicad/OTS_2/pdf/main/OTS2_main-F.SilkS.pdf

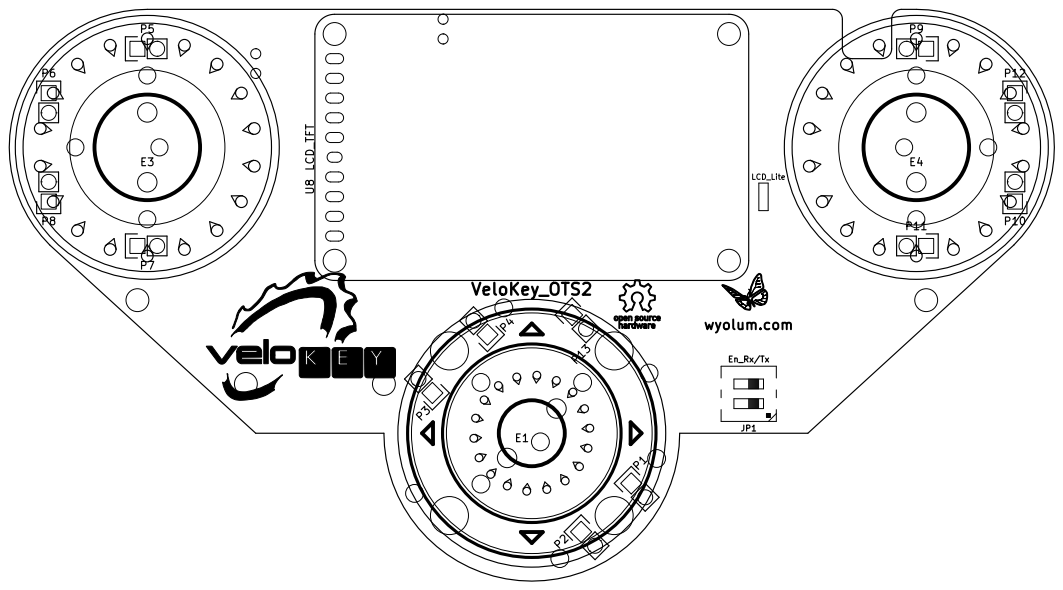
[picture p127: page 1]
