wyolum/VeloKey/kicad/OTS_2/OTS2_encA.kicad_pcb

## KiCad design kicad/OTS_2/OTS2_encA.kicad_pcb (2016-10-08)

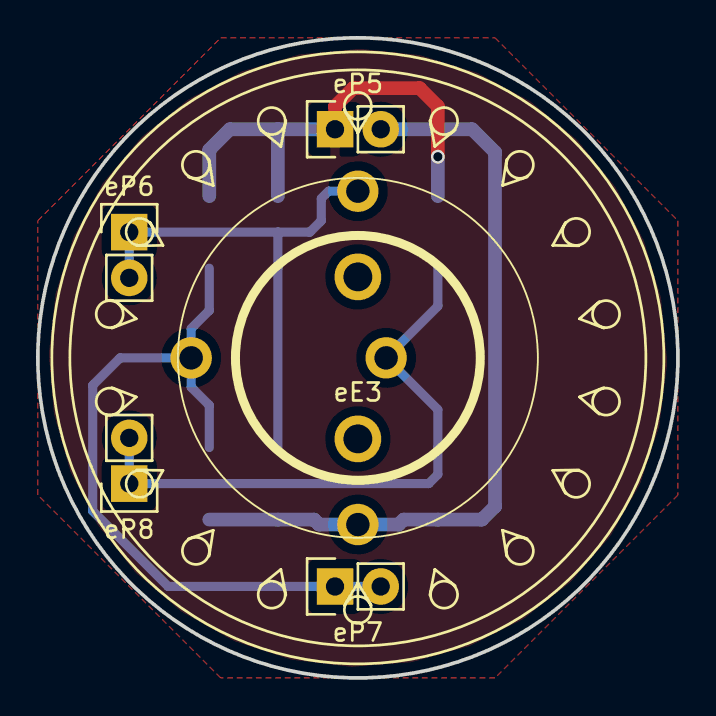
[picture p128: board OTS2_encA.kicad_pcb from above]

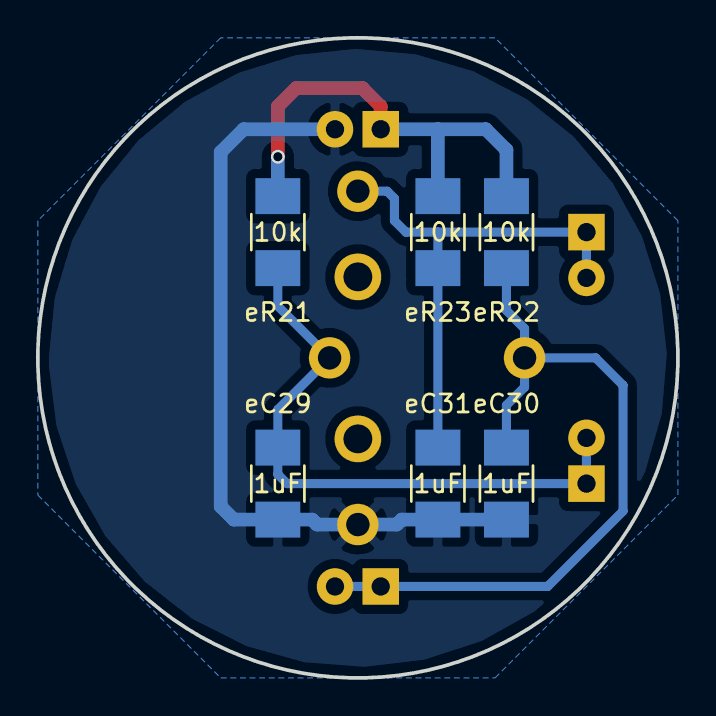
[picture p129: board OTS2_encA.kicad_pcb from below]

Board: 2 copper layers, 35.6 x 35.6 mm, 11 parts (6 on the bottom side), 5 nets.

Parts:
eC29, eC30, eC31: 1uF; C_1210_HandSoldering
eE3: ENC_A; TSWA3NCD23LFS
eP5: ENC_A_1; Pin_Header_Straight_1x02
eP6: ENC_A_2; Pin_Header_Straight_1x02
eP7: ENC_A_3; Pin_Header_Straight_1x02
eP8: ENC_A_4; Pin_Header_Straight_1x02
eR21, eR22, eR23: 10k; R_1210_HandSoldering

Connections:
/eEAA: eC31.1, eE3.1, eP6.1, eP6.2, eR23.2
/eEAB: eC30.1, eE3.3, eP7.1, eP7.2, eR22.2
/eEAS: eC29.1, eE3.4, eP8.1, eP8.2, eR21.2
/eGND: eC29.2, eC30.2, eC31.2, eE3.2, eP5.2
/eVCC: eP5.1, eR21.1, eR22.1, eR23.1
