wyolum/VeloKey/kicad/OTS_2/OTS2_main.kicad_pcb

## KiCad design kicad/OTS_2/OTS2_main.kicad_pcb (2016-10-08)

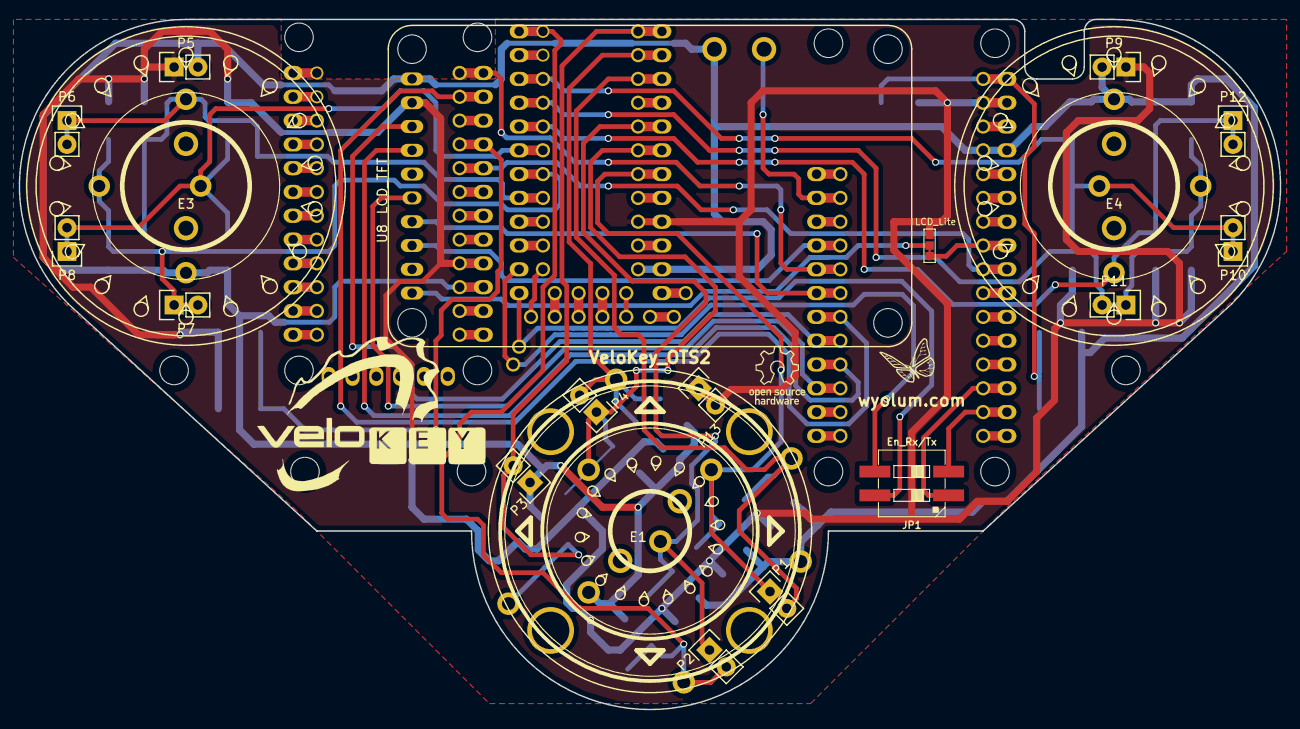
[picture p130: board OTS2_main.kicad_pcb from above]

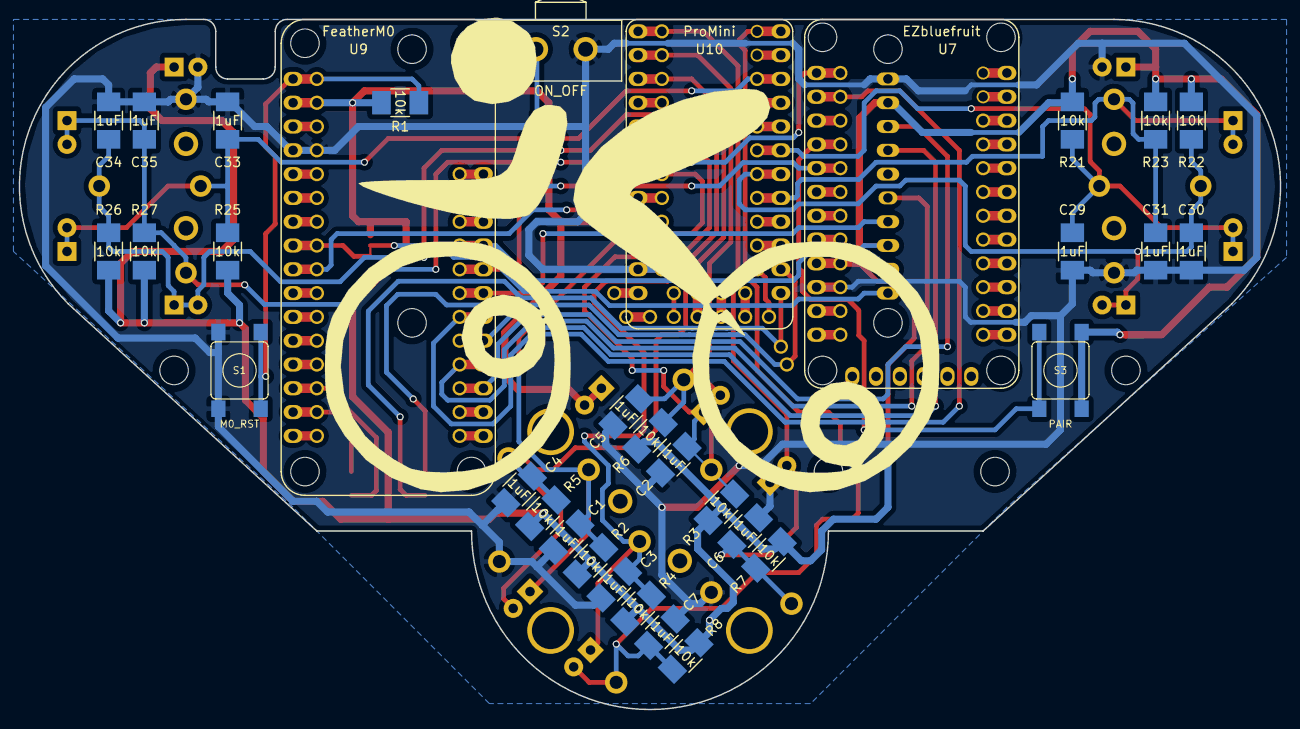
[picture p131: board OTS2_main.kicad_pcb from below]

Board: 2 copper layers, 134.6 x 73.7 mm, 60 parts (34 on the bottom side), 31 nets.

Parts:
C1, C2, C3, C4, C5, C6, C7, C29, C30, C31, C33, C34, C35: 1uF; C_1210_HandSoldering
E1: ENC_C; TSWB3NCB222LFS
E3: ENC_A; TSWA3NCD23LFS
E4: ENC_B; TSWA3NCD23LFS
G1: logo_wl; logo_wyo_butterfly_small
G2: OSHW; OSHW-LOGO
G3: logo_vk
G4: logo_vk; logo_vk8
H1, H2, H3, H4: MTG_HOLE; MountingHole_3mm
J1: LCD_Lite; SMD_Jumper_2way
JP1: En_Rx/Tx; DIP_2way
P1: ENC_C_1; Pin_Header_Straight_1x02
P2: ENC_C_2; Pin_Header_Straight_1x02
P3: ENC_C_3; Pin_Header_Straight_1x02
P4, P13: ENC_C_4; Pin_Header_Straight_1x02
P5: ENC_A_1; Pin_Header_Straight_1x02
P6: ENC_A_2; Pin_Header_Straight_1x02
P7: ENC_A_3; Pin_Header_Straight_1x02
P8: ENC_A_4; Pin_Header_Straight_1x02
P9: ENC_B_1; Pin_Header_Straight_1x02
P10: ENC_B_2; Pin_Header_Straight_1x02
P11: ENC_B_3; Pin_Header_Straight_1x02
P12: ENC_B_4; Pin_Header_Straight_1x02
R1, R2, R3, R4, R5, R6, R7, R8, R21, R22, R23, R25, R26, R27: 10k; R_1210_HandSoldering
S1: M0_RST; SW_SMD
S2: ON_OFF; SW_SPST
S3: PAIR; SW_SMD
U7: EZbluefruit; EZ_bluefruit
U8: LCD_TFT
U9: FeatherM0
U10: ProMini; Pro_Mini_alt2

Connections:
/CS: U8.5, U9.3
/DC: U8.7, U9.4
/EAA: C31.1, E3.1, P6.1, P6.2, R23.2, U10.23
/EAB: C30.1, E3.3, P7.1, P7.2, R22.2, U10.24
/EAS: C29.1, E3.4, P8.1, P8.2, R21.2, U10.25
/EBA: C35.1, E4.1, P12.1, P12.2, R27.2, U10.26
/EBB: C34.1, E4.3, P11.1, P11.2, R26.2, U10.27
/EBS: C33.1, E4.4, P10.1, P10.2, R25.2, U10.28
/ECA: C1.1, E1.1, P1.1, R2.2, U10.7
/ECB: C2.1, E1.3, P4.1, R3.2, U10.6
/ECS: C3.1, E1.4, P2.1, R4.2, U10.5
/GND: C1.2, C2.2, C3.2, C4.2, C5.2, C6.2, C7.2, C29.2, C30.2, C31.2, C33.2, C34.2, C35.2, E1.2, E1.11, E3.2, E4.2, P3.1, P5.2, P9.2, S1.1, S2.1, U7.10, U8.10, U9.16, U10.11
/L2: U7.5, U9.21
/LITE: J1.1, J1.2, U8.1, U9.20
/MOSI: U8.4, U9.7
/Pair: S3.1, U7.4
/RST: U8.8, U9.5
/RXD: JP1.1, U9.26
/RX_BLE: U7.2, U9.6
/RX_PRO: JP1.4, U10.20
/S2: C4.1, E1.7, P1.2, R5.2, U10.3
/S3: C5.1, E1.8, P4.2, R6.2, U10.2
/S4: C6.1, E1.9, P3.2, R7.2, U10.1
/S5: C7.1, E1.10, P2.2, R8.2, U10.30
/SCK: U8.3, U9.9
/TXD: JP1.3, U9.27
/TX_BLE: U7.1, U9.8
/TX_PRO: JP1.2, U10.19
/VCC: J1.3, P5.1, P9.1, P13.1, P13.2, R1.1, R2.1, R3.1, R4.1, R5.1, R6.1, R7.1, R8.1, R21.1, R22.1, R23.1, R25.1, R26.1, R27.1, S3.2, U7.9, U8.9, U9.14, U10.9
unnamed: R1.2, S1.2, U9.13
unnamed: S2.2, U9.11
