wyolum/VeloKey/kicad/OTS_2/OTS2_encB.kicad_pcb

## KiCad design kicad/OTS_2/OTS2_encB.kicad_pcb (2016-10-08)

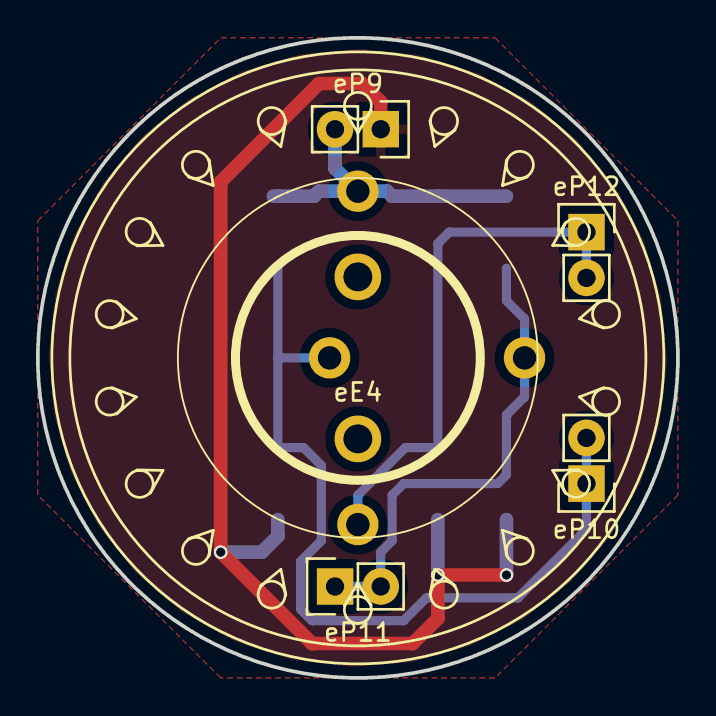
[picture p132: board OTS2_encB.kicad_pcb from above]

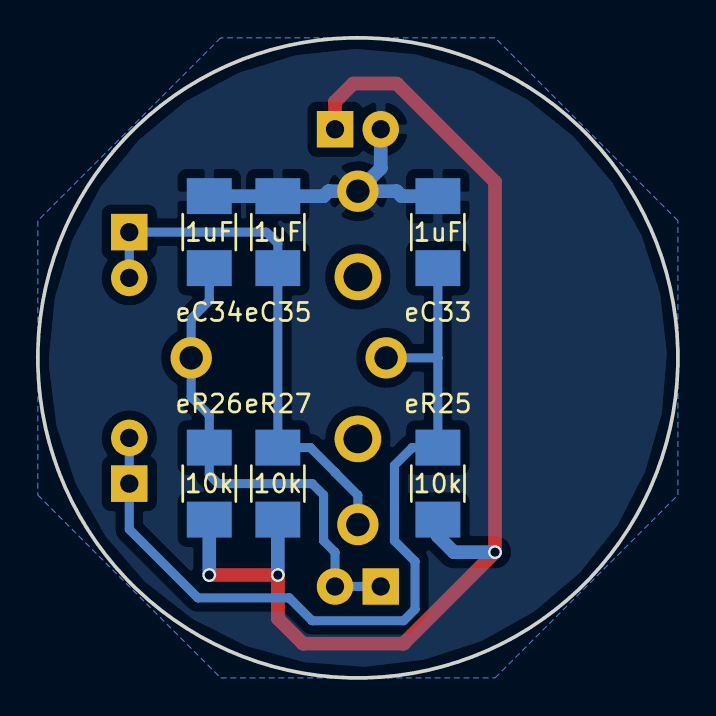
[picture p133: board OTS2_encB.kicad_pcb from below]

Board: 2 copper layers, 35.6 x 35.6 mm, 11 parts (6 on the bottom side), 5 nets.

Parts:
eC33, eC34, eC35: 1uF; C_1210_HandSoldering
eE4: ENC_B; TSWA3NCD23LFS
eP9: ENC_B_1; Pin_Header_Straight_1x02
eP10: ENC_B_2; Pin_Header_Straight_1x02
eP11: ENC_B_3; Pin_Header_Straight_1x02
eP12: ENC_B_4; Pin_Header_Straight_1x02
eR25, eR26, eR27: 10k; R_1210_HandSoldering

Connections:
/eEBA: eC35.1, eE4.1, eP12.1, eP12.2, eR27.2
/eEBB: eC34.1, eE4.3, eP11.1, eP11.2, eR26.2
/eEBS: eC33.1, eE4.4, eP10.1, eP10.2, eR25.2
/eGND: eC33.2, eC34.2, eC35.2, eE4.2, eP9.2
/eVCC: eP9.1, eR25.1, eR26.1, eR27.1
