wyolum/VeloKey/kicad/OTS_2/OTS2_encC.kicad_pcb

## KiCad design kicad/OTS_2/OTS2_encC.kicad_pcb (2016-10-08)

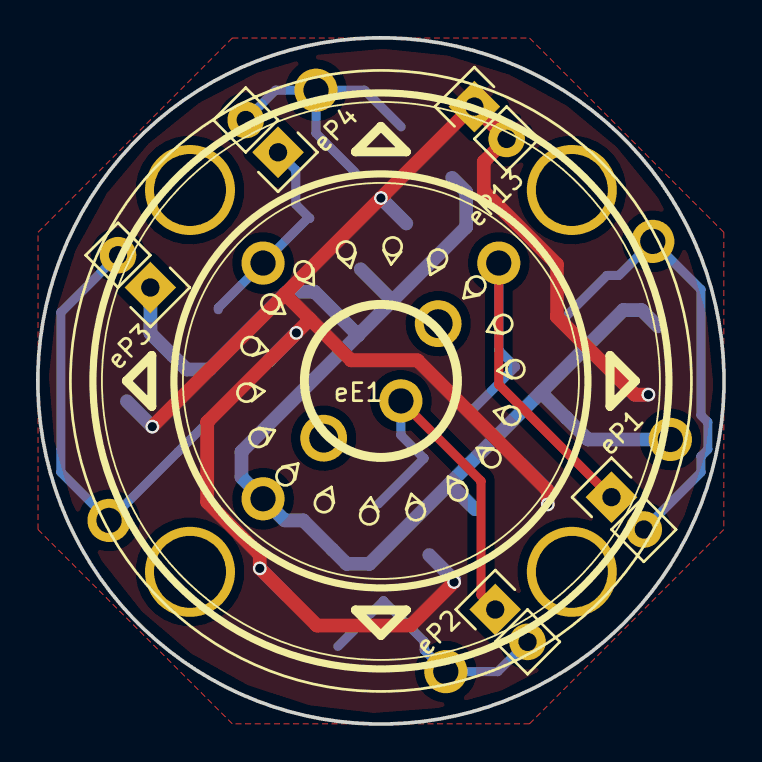
[picture p134: board OTS2_encC.kicad_pcb from above]

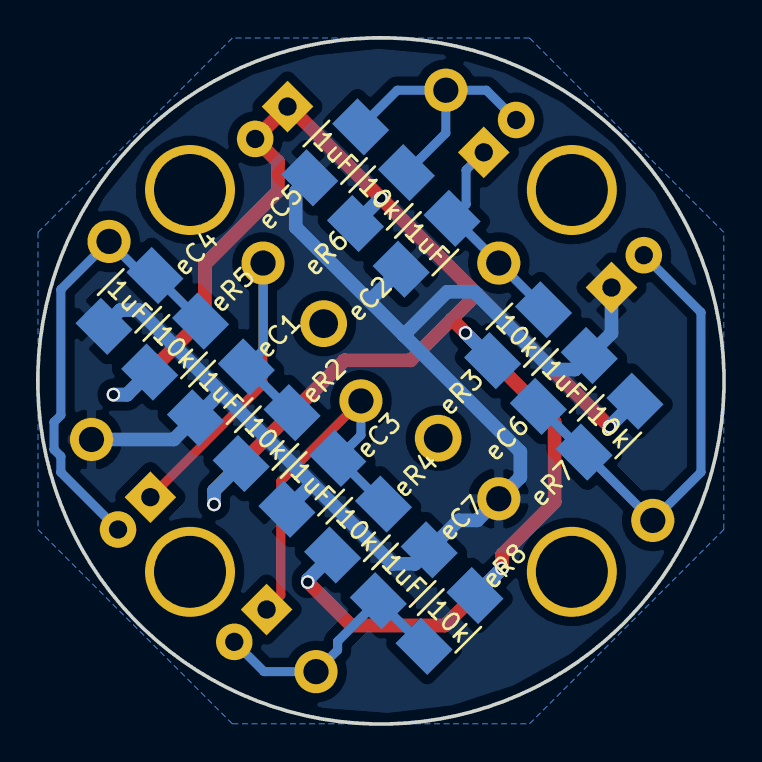
[picture p135: board OTS2_encC.kicad_pcb from below]

Board: 2 copper layers, 38.1 x 38.1 mm, 20 parts (14 on the bottom side), 9 nets.

Parts:
eC1, eC2, eC3, eC4, eC5, eC6, eC7: 1uF; C_1210_HandSoldering
eE1: ENC_C; TSWB3NCB222LFS
eP1: ENC_C_1; Pin_Header_Straight_1x02
eP2: ENC_C_2; Pin_Header_Straight_1x02
eP3: ENC_C_3; Pin_Header_Straight_1x02
eP4: ENC_C_4; Pin_Header_Straight_1x02
eP13: ENC_C_5; Pin_Header_Straight_1x02
eR2, eR3, eR4, eR5, eR6, eR7, eR8: 10k; R_1210_HandSoldering

Connections:
/eECA: eC1.1, eE1.1, eP1.1, eR2.2
/eECB: eC2.1, eE1.3, eP4.1, eR3.2
/eECS: eC3.1, eE1.4, eP2.1, eR4.2
/eGND: eC1.2, eC2.2, eC3.2, eC4.2, eC5.2, eC6.2, eC7.2, eE1.2, eE1.11, eP3.1
/eS2: eC4.1, eE1.7, eP1.2, eR5.2
/eS3: eC5.1, eE1.8, eP4.2, eR6.2
/eS4: eC6.1, eE1.9, eP3.2, eR7.2
/eS5: eC7.1, eE1.10, eP2.2, eR8.2
/eVCC: eP13.1, eP13.2, eR2.1, eR3.1, eR4.1, eR5.1, eR6.1, eR7.1, eR8.1
