wyolum/VeloKey/kicad/OTS_1/OTS.kicad_pcb

## KiCad design kicad/OTS_1/OTS.kicad_pcb (2016-02-25)

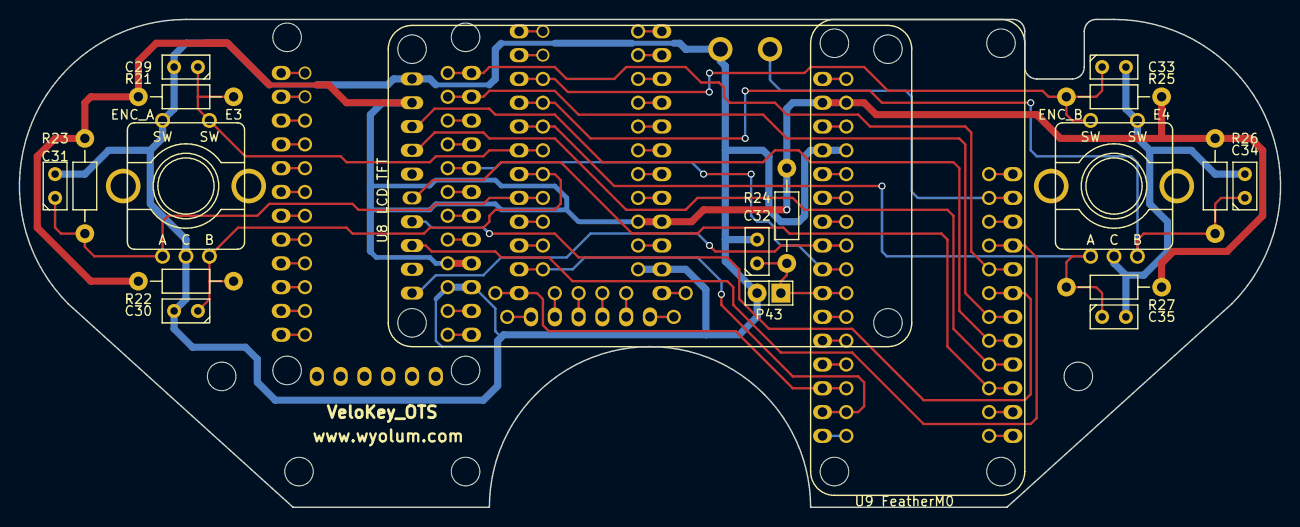
[picture p136: board OTS.kicad_pcb from above]

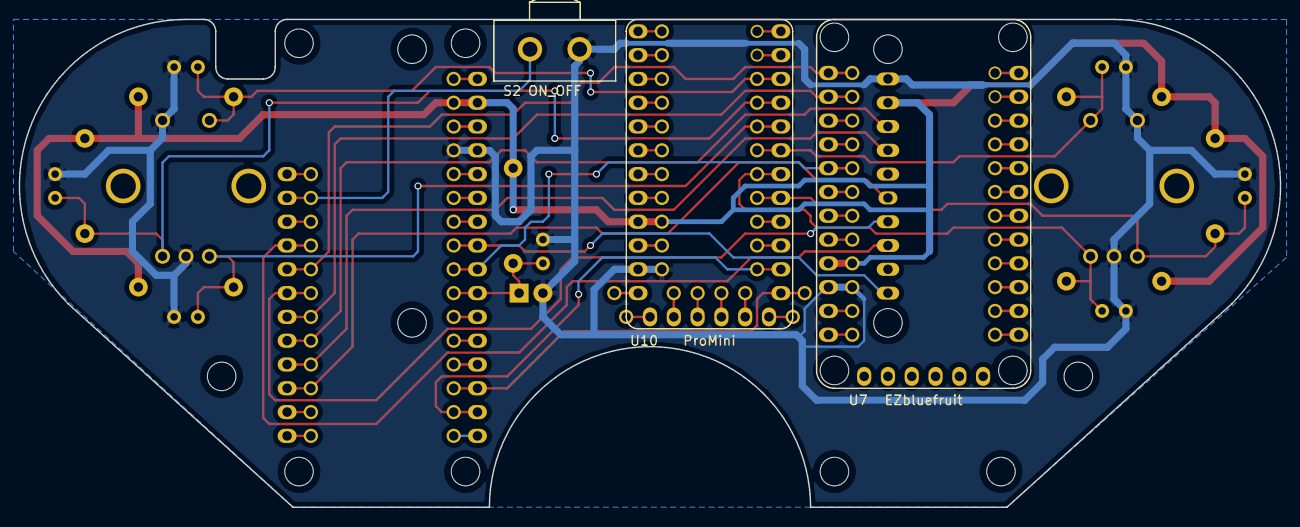
[picture p137: board OTS.kicad_pcb from below]

Board: 2 copper layers, 134.6 x 52.1 mm, 26 parts (3 on the bottom side), 21 nets.

Parts:
C29, C30, C31, C32, C33, C34, C35: 1uF; Capacitor3MMDiscRM2.5
E3: ENC_A; Encoder
E4: ENC_B; Encoder
H1, H2, H3, H4: MTG_HOLE; MountingHole_3mm
P43: POWER_UP; Pin_Header_Straight_1x02
R21, R22, R23, R24, R25, R26, R27: 10k; Resistor_Horizontal_RM10mm
S2: ON_OFF; SW_SPST
U7: EZbluefruit; EZ_bluefruit
U8: LCD_TFT
U9: FeatherM0
U10: ProMini; Pro_Mini

Connections:
/GND: C29.2, C30.2, C31.2, C32.2, C33.2, C34.2, C35.2, E3.2, E3.4, E4.2, E4.5, P43.2, S2.1, U7.10, U8.10, U9.16, U10.11
/L2: U7.5, U9.21
/LITE: U8.1, U9.20
/POWERUP: C32.1, P43.1, R24.2, U9.22
/VCC: R21.1, R22.1, R23.1, R24.1, R25.1, R26.1, R27.1, U7.9, U8.9, U9.14, U10.9
unnamed: C29.1, E3.5, R21.2, U10.25
unnamed: C30.1, E3.3, R22.2, U10.24
unnamed: C31.1, E3.1, R23.2, U10.23
unnamed: C33.1, E4.4, R25.2, U10.28
unnamed: C34.1, E4.3, R26.2, U10.27
unnamed: C35.1, E4.1, R27.2, U10.26
unnamed: S2.3, U9.11
unnamed: U7.1, U9.8
unnamed: U7.2, U9.6
unnamed: U8.3, U9.9
unnamed: U8.4, U9.7
unnamed: U8.5, U9.3
unnamed: U8.7, U9.4
unnamed: U8.8, U9.5
unnamed: U9.26, U10.19
unnamed: U9.27, U10.20
