wyolum/VeloKey/arduino/Pong/logo.h

uint8_t rgb565_width = 160;
uint8_t rgb565_height = 128;
const unsigned int n_rgb565 = 4098;
uint8_t rgb565_rows[n_rgb565] = {
77, 137, 80, 124, 150, 18, 41, 107, 99, 101, 123, 46, 133, 51, 115, 
30, 116, 151, 51, 51, 25, 30, 65, 94, 91, 106, 53, 141, 90, 85, 
51, 136, 58, 77, 122, 83, 110, 150, 27, 140, 35, 42, 53, 144, 56, 
51, 115, 111, 128, 106, 44, 96, 50, 115, 35, 93, 70, 35, 97, 106, 
21, 66, 120, 146, 84, 136, 25, 84, 146, 12, 32, 72, 145, 105, 115, 
144, 31, 50, 50, 93, 81, 99, 80, 146, 58, 125, 107, 136, 23, 67, 
58, 132, 118, 35, 21, 111, 134, 111, 82, 86, 54, 150, 51, 59, 103, 
47, 29, 85, 90, 149, 52, 80, 85, 31, 91, 52, 94, 84, 14, 121, 
91, 29, 32, 82, 151, 8, 100, 96, 25, 69, 116, 46, 100, 68, 90, 
92, 127, 97, 93, 108, 88, 31, 43, 83, 28, 107, 97, 43, 117, 112, 
89, 53, 143, 120, 24, 128, 64, 126, 107, 28, 127, 89, 81, 105, 98, 
101, 138, 109, 117, 83, 75, 149, 45, 154, 123, 103, 26, 74, 124, 99, 
121, 88, 130, 114, 125, 123, 112, 122, 115, 122, 104, 98, 73, 33, 40, 
139, 97, 90, 91, 86, 42, 63, 87, 61, 52, 97, 98, 53, 118, 123, 
152, 124, 25, 101, 14, 47, 86, 110, 52, 72, 100, 108, 97, 26, 107, 
98, 61, 122, 121, 51, 132, 89, 141, 151, 88, 88, 113, 104, 96, 90, 
120, 79, 115, 155, 121, 114, 111, 28, 58, 89, 61, 71, 81, 66, 100, 
34, 108, 92, 72, 67, 137, 156, 20, 106, 124, 145, 66, 146, 26, 107, 
19, 155, 134, 147, 109, 109, 34, 122, 76, 86, 34, 71, 98, 28, 87, 
24, 100, 116, 82, 42, 154, 148, 63, 40, 11, 56, 104, 149, 154, 120, 
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
12677, 4259, 14823, 30817, 8419, 
57537, 6339, 64170, 23307, 8452, 
32864, 23275, 63713, 16936, 10533, 
16903, 23275, 0, 10565, 12678, 
21129, 63713, 19017, 16904, 12646, 
29582, 53409, 8452, 4259, 21129, 
63713, 10565, 63681, 0, 2145, 
23275, 21130, 0, 6307, 6307, 
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
};
