wyolum/VeloKey/arduino/vk_displaytest/logo2.h

uint8_t image[20480] = {
255 ,
255 ,
255 ,
255 ,
255 ,
255 ,
255 ,
255 ,
255 ,
255 ,
255 ,
255 ,
255 ,
255 ,
255 ,
255 ,
255 ,
255 ,
255 ,
255 ,
255 ,
255 ,
255 ,
255 ,
255 ,
255 ,
255 ,
255 ,
255 ,
255 ,
255 ,
255 ,
255 ,
255 ,
255 ,
255 ,
255 ,
255 ,
255 ,
255 ,
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
};
