wyolum/VeloKey/(commit log)

2016-01-24 schematic, work in progress
    [VELO.sch, velokey.kicad_pcb, velokey.sch]
2016-01-24 using 328 code to handle encoders and buttons
2016-01-25 added adafruit libs to arduino/libraries directory
2016-01-26 added first 3d sketch of enclosure with ots components.
2016-01-26 added scad files and dxf files for enclosure mock up.
    [case1.scad, front.dxf, side.dxf, top.dxf]
2016-01-26 new case design based on minkowsky()
    [case1.scad, front.dxf, side.dxf, top.dxf]
2016-02-01 added off the shelf schematic
    [case1.scad, front.dxf, knob.scad, side.dxf]
2016-02-01 added OTH schematic
    [ArduinoProMini.step, encoder.sch, velokey.sch]
2016-02-01 work in progress
    [encoder.sch, velokey.kicad_pcb, velokey.sch]
2016-02-02 update PCB shape in OTH
    [case1.scad]
2016-02-02 added OTS schematic
    [encoder.sch, velokey.kicad_pcb, velokey.sch]
2016-02-02 Added dims to OTS schematic
2016-02-03 added screw holes to OSH board drawing
2016-02-03 udated PCB shape
2016-02-04 board layout work in progress
    [ArduinoProMini.step, BlueFruit.fcstd, BlueFruit.step, Capacitor_100nF_2-54mm.step, FeatherM0.fcstd, FeatherM0.step, Header_Male_01Pin.step, Header_Male_02Pin.step]
2016-02-05 Added GUI elements for more flexible swapping of graphical elements
    [VeloKey_V1.ino]
2016-02-05 PCB layout done. Gerbers generated
    [Header_Male_02Pin.step, LCD_TFT.fcstd, LCD_TFT.step, LCD_TFT2.step, ksu-config.cfg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]
2016-02-05 added power.lib
2016-02-05 fresh gerbers, revised mount hole clearances
    [velokey-B.Cu.gbl, velokey-B.Mask.gbs, velokey-B.SilkS.gbo, velokey-Edge.Cuts.gm1, velokey-F.Cu.gtl, velokey-F.Mask.gts, velokey-F.SilkS.gto, velokey.drl]
2016-02-05 created OTS pro, sch, pcb and other files
    [OTS.FCStd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]
2016-02-07 updated README with OTS pix
    [case1.scad, front.dxf, knob.scad]
2016-02-12 working on case3_OTS. TODO: break into two pieces
    [knob.scad]
2016-02-21 added L2 and LITE connections
    [OTS-B.Cu.gbl, OTS-B.Mask.gbs, OTS-B.SilkS.gbo, OTS-Edge.Cuts.gm1, OTS-F.Cu.gtl, OTS-F.Mask.gts, OTS-F.SilkS.gto, OTS-drl_map.gbr]
2016-02-22 added Limited Encoder Library
2016-02-22 Git issue #1,#2,#5,#7 closed
    [OTS.kicad_pcb]
2016-02-25 added board outline drawings to fabricate
    [VeloKey_dims.fcstd, velokey.fcstd, velokey_edge.dxf, velokey_outline.dxf]
2016-02-26 fixed encode crosstalk bug
    [VeloKey_V2.ino]
2016-02-28 fixed section jumping issue when screen toggles
    [VeloKey_V2.ino]
2016-03-05 added fabrication files
    [case2_OTS.scad, case3_OTS.scad, case4_OTS.scad, case5_OTS.scad]
2016-03-05 added stl files
    [Garmin_Quarter_Turn_Plate.stl, board_OTS.stl, case1.stl, case1_bottom.stl, case1_top.stl, case3_OTS.stl, case3_OTS_bottom.stl, case4_OTS.stl]
2016-03-05 modifed case in (case6) that should print better without support
    [case6_OTS.scad, case6_OTS_top.stl]
2016-03-06 flattened case6 top to make a bigger gleam
    [case6_OTS.scad]
2016-03-07 added unit tests
    [case6_OTS.scad, case6_OTS_top.stl]
2016-03-26 opened fresh project for OTS_2
    [Adafruit Feather M0 Basic rev C.brd, Adafruit Feather M0 Basic rev C.sch, BlueFruit.fcstd, BlueFruit.step, Capacitor_100nF_2-54mm.step, FeatherM0.fcstd, FeatherM0.step, Header_Male_01Pin.step]
2016-03-27 VeloKey OTS rev2 schematic
2016-03-27 VeloKey OTS rev2 initial board mockup
    [OTS2.kicad_pcb]
2016-03-28 OTS_2 board layout progressing
    [Cap_smd_1210.step, OTS2.kicad_pcb, Res_smd_1210.step, SW_smd.step]
2016-03-31 VeloKey OTS rev2 awaiting review
    [OTS2.kicad_pcb]
2016-04-01 OTS2 complete, gerbers ready
    [OTS2-B.Cu.gbl, OTS2-B.Mask.gbs, OTS2-B.SilkS.gbo, OTS2-Edge.Cuts.gm1, OTS2-F.Cu.gtl, OTS2-F.Mask.gts, OTS2-F.SilkS.gto, OTS2.drl]
2016-04-22 Issue #11 closed. Swapped incorrect values of C2/R6
    [OTS2.kicad_pcb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]
2016-04-25 ProMini<>Encoder Pin13 connection changed. Added 2 way DIP for disabling Rx-Tx
    [OTS2.kicad_pcb]
2016-04-25 Increased all track widths. Added 2 way DIP switch
    [OTS2.kicad_pcb, dip_sw_smd.step, dip_switch_smd_x2.step, dip_switch_smd_x2_2.step, dip_switch_smd_x2_3.step]
2016-07-04 new STEP file with revised LCD display
    [LCD_TFT.fcstd, LCD_TFT.step, LCD_TFT2.step, LCD_TFT_2.fcstd, OTS2.FCStd, OTS2.kicad_pcb]
2016-07-04 reduced 3D
    [OTS21.FCStd, OTS22.FCStd, OTS22.stl]
2016-07-06 fabricate top cover revised design OTS23.stl
    [OTS22.FCStd, OTS23.FCStd, OTS23.stl]
2016-08-05 added EZKey.h
    [case6_OTS.scad, case_1.scad, display_post.scad]
2016-08-10 enclosure work in progress. Top is mostly done. working on the bottom
    [OTS23.FCStd]
2016-08-20 enclosure top, ver OTS2_4 in fabricate/OTS2 folder
    [OTS.FCStd, OTS2_0.FCStd, OTS2_1.FCStd, OTS2_2.FCStd, OTS2_2.stl, OTS2_3.FCStd, OTS2_3.stl, OTS2_4.FCStd]
2016-08-21 enclosure top/bot, ver OTS2_4 in fabricate/OTS2 folder + top/bot STL
    [OTS2_4.FCStd, OTS2_4.stl, OTS2_4_bot.stl, OTS2_4_top.stl]
2016-08-29 enclosure top/bot, ver OTS2_4 in /fabricate/OTS2 folder + STLs
    [OTS2_4.FCStd, OTS2_4_bot.stl, OTS2_4_top.stl]
2016-09-02 added event based ncodr driver
2016-09-02 added note about pin change
2016-09-05 encoder daughter boards, WIP
    [OTS2.kicad_pcb, OTS2_enc.sch]
2016-09-14 gerbers for encA, encB, encC, main - ready
    [OTS2-B.Cu.gbl, OTS2-B.Mask.gbs, OTS2-B.SilkS.gbo, OTS2-Edge.Cuts.gm1, OTS2-F.Cu.gtl, OTS2-F.Mask.gts, OTS2-F.SilkS.gto, OTS2.drl]
2016-09-14 enclosure top half, WIP
2016-09-15 OTS2 enclosure top+bottom STL's ready
    [OTS2_0.FCStd, OTS2_1.FCStd, OTS2_2.FCStd, OTS2_2.stl, OTS2_3.FCStd, OTS2_3.stl, OTS2_4_bot.stl, OTS2_4_top.stl]
2016-10-02 Modified pin number for OTS_V3 with extended thumbwheels
2016-10-06 VK enclosure mods
    [OTS2_4_bot.stl, OTS2_4_top.stl]
2016-10-08 enclosure revisions
    [OTS2_4_bot.stl, OTS2_4_top.stl]
2016-10-08 editd .kicad_pcb files to open in stable ver
    [OTS2.kicad_pcb, OTS2_encA.kicad_pcb, OTS2_encB.kicad_pcb, OTS2_encC.kicad_pcb, OTS2_main.kicad_pcb]
2016-10-20 VK case mods
    [OTS2_5_bot.stl]
2016-10-21 added garmin quarter turn and magnet base
    [OTS2_5_garmin_base.scad, OTS2_5_garmin_base.stl]
2016-10-22 modified quarter turn base
    [OTS2_5_garmin_base.scad, OTS2_5_garmin_base.stl]
2016-10-24 modified battery level indicator
    [OTS2_5_garmin_base.scad, OTS2_5_garmin_base.stl]
2016-12-15 VK case - pocket for acrylic window
    [OTS2_6_bot.stl, OTS2_6_top.stl, OTS2_7_bot.stl, OTS2_7_top.stl, OTS2_7_top_NoSupport.stl]
2018-01-31 added KandyBar
    [OTS2_7_top.stl]
